guilhermelionzo/tcc_files/latex/editaveis/abreviaturas.tex

\begin{siglas} 		
\item[ADC	] Analog to Digital Converter
\item[AMBA	] Advanced Microcontroller Bus Architecture
\item[AODCS	] Attitude and Orbit Determination and Control System
\item[APIs	] Application Programming Interface
\item[ASCII	] American Standard Code for Information Interchange
\item[CAF	] Camada de Aplicação Final
\item[CAN	] Controller Area Network
\item[CBD	] Component-based Development
\item[CMOS	] Complementary Metal Oxide Semiconductor
\item[COTS	] Commercial off-the-shelf
\item[CSS	] Camada de Serviço do Sistema
\item[DD	] Displacement Damage
\item[ELDRS	] Enhanced Low Dose Rate Sensitivity
\item[EPS	] Electrical Power System
\item[FIFO	] First in, first out
\item[FRAM	] Ferroelectric Random-Access Memory
\item[GPIO	] General Purpose Input/Output
\item[GPL	] General Public License
\item[HAL	] Hardware Abstraction Layer
\item[I2C	] Inter-Integrated Circuit
\item[IMU	] Inertial Measurement Unit
\item[ISS	] International Space Station
\item[JTAG	] Joint Test Action Group
\item[LBA	] Layered-based Architecture
\item[LEO	] Low Earth Orbit
\item[OBC	] On Board Computer
\item[P-POD	] Poly-PicoSatellite Orbital Deploye
\item[PCB	] Printed Circuit Board
\item[PPT	] Pulsed Plasma Thruster 
\item[PWM	] Pulse Width Modulation
\item[RISC	] Reduced Instruction Set Computer
\item[RTC	] Real Time Clock
\item[RTOS	] Real Time Operating Systems
\item[SDW	] SPI Digital Waveform
\item[SEB	] Single Event Burnout
\item[SEE	] Single Event Effect
\item[SEGR	] Single Event Gate Rupture
\item[SEL	] Single Event Latchup	 
\item[SOA	] Service Oriented Architecture
\item[SoC	] System-on-a-chip
\item[SPI	] Serial Peripheral Interface 
\item[SS	] Structural System
\item[SSTP	] Small Space Technology Program
\item[TID	] Total de Dose Ionizante
\item[TT\&C	] Telemetry Telecomand Control
\item[UART	] Universal Asynchrounous Receiver/Transmiter
\item[UML	] Unified Modeling Language
\item[UnB	] Universidade de Brasília
\item[WTD	] Watchdog
\end{siglas}
