guilhermelionzo/tcc_files/latex/editaveis/agradecimentos.tex

\begin{comment}

\end{comment}

\begin{agradecimentos}

Agradeço à equipe da Percepio, que forneceram uma licença para a utilização do Tracealyzer. Agradeço aos professores Leonardo Aguayo e Giancarlo Santilli por acreditarem e incentivarem meu projeto de graduação. E por fim, agradeço minha irmã, Juliana Lionço, por reler inúmeras versões dessa monografia.
	
\end{agradecimentos}
