guilhermelionzo/tcc_files/documents/Referencial Bibliografico.docx

1. Referencial Bibliográfico

Esta seção visa oferecer uma introdução aos conceitos básicos para o entendimento da pesquisa.

Um ponto de ressalto é que este trabalho aborda aspectos de espaçonaves que orbitam a Terra, sendo assim essas espaçonaves são satélites. Onde se ler satélite entende-se espaçonave, vice-versa.

  1.1. Pequenos Satélites

O termo “pequenos satélites” é designado para caracterizar satélites que possuem massa úmida (massa do satélite mais massa do propelente) inferior a 500 kg. Esta definição cumpre a terminologia estabelecida pelo Small Space Tecnology Program (SSTP) da NASA (SHIMMIN, 2015). As subcategorias de pequenos satélites, e alguns exemplos de espaçonaves já lançadas, podem ser observadas na figura abaixo.

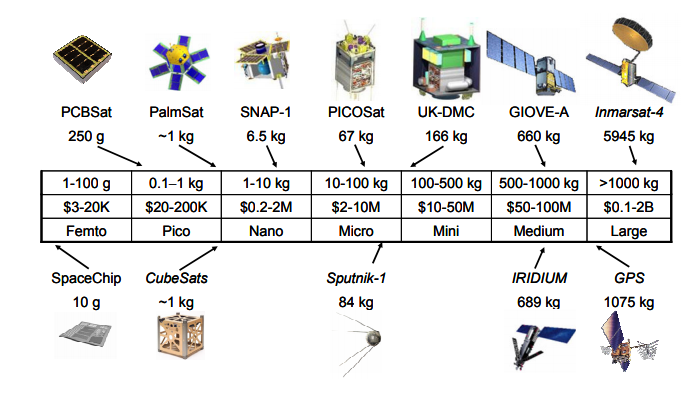
[picture p17: figure]

Figura X.: Categoria de Pequenos Satélites e alguns exemplos (BARNHART, 2008).

No limite superior da categoria de pequenos satélites, existem minissatélites como o Globalstar, satélite de telecomunicações da empresa Globalstar LP, que possui massa úmida de 450 kg (GLOBALSTAR, L.P, 2000). Já no extremo inferior, existem projetos como o KickSat que colocou em orbita 128 femtosatelites com 5g (GRIFFITHS, 2017). As espaçonaves são normalmente agrupadas conforme sua massa, onde pequenos satélites incluem minissatélites com massa entre 100-500kg, microssatélites com massa entre 10-100kg, nanosatélites com massa entre 1-10kg, picosatélites com massa entre 0.1-1kg e femtosatelites com massa entre 1-100g.

Dentre estas subcategorias uma se tornou muito popular na última década, a dos nanosatélites. Esse crescimento pode ser observado na figura X, que mostra a quantidade de pequenos satélites colocados em orbita, entre os anos de 1995 e 2014. Tal aumento foi provocado devido ao surgimento do padrão Cubesat, plataforma cubica de 10 × 10 × 10 cm que possui alguns quilogramas. No ano de 2014, mais de 123 nanosatélites foram lançados, sendo 68% CubeSats (WEKERLE; FILHO, 2017).

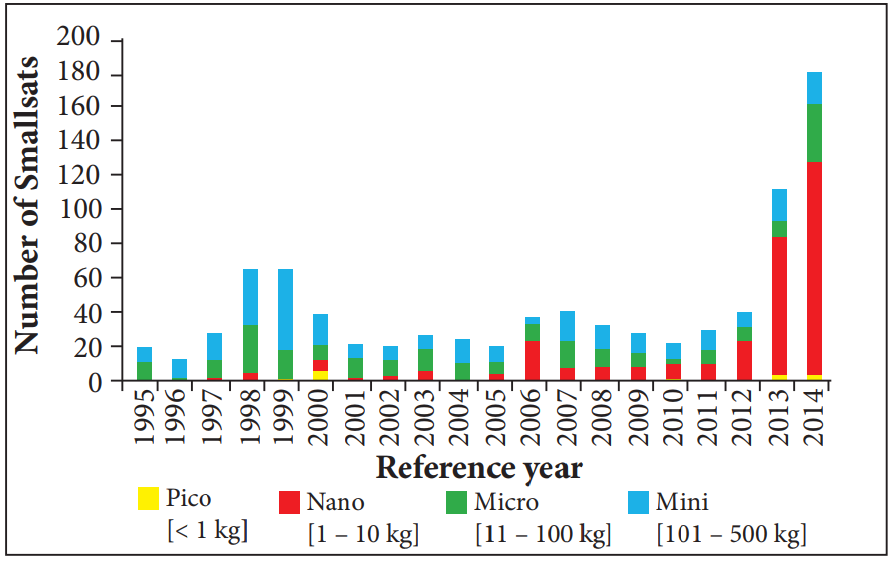
[picture p18: figure]

Figura X.: Lançamento de pequenos satélites por entre 1995 e 2014 (WEKERLE; FILHO, 2017).

Como a figura X mostra, no ano de 2014 que mais de 100 nanosatélites foram lançados, e mais de 68% eram Cubesats (WEKERLE; FILHO, 2017). Os nanosatélites Na última década um padrão de nanossatélites se tornou muito comum no meio acadêmico. Esse padrão, chamado CubeSat, possui a forma de um cubo de 10 × 10 × 10 cm que pesa apenas alguns quilogramas. Os CubeSats podem ser compostos por um único cubo (uma unidade ou 1U) ou vários cubos combinados formando, por exemplo, unidades 3U ou 6U. A figura abaixo mostra as configurações mais usuais para uma CubeSat (SHIMMIN, 2015).

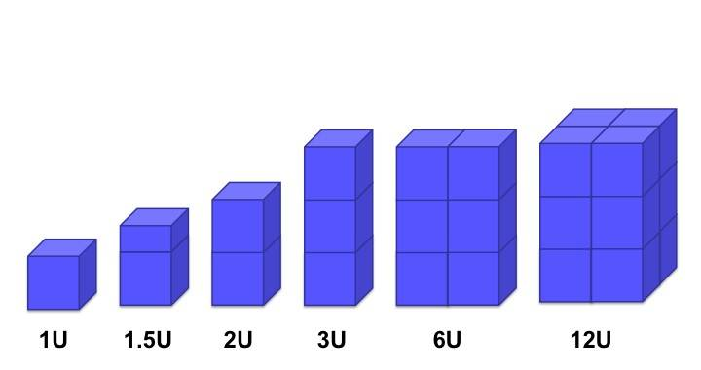
[picture p19: figure]
Image result for cubesats forms

Figura X.: Algumas variações de CubeSat (MABROUK, 2017).

  1.2. Padrão CubeSat

O padrão CubeSat começou como um esforço colaborativo entre Jordi Puig-Suari, professor na Universidade Politécnica da Califórnia (CalPoly), e Bob Twiggs, professor na Universidade de Stanford. A intenção original era fornecer para a comunidade científica universitária meios mais acessíveis ao espaço (DEEPAK; TWIGGS, 2012).

Twiggs retrata o contexto histórico do desenvolvimento do conceito CubeSat em detalhes no seu artigo “Origin of CubeSat” (TWIGGS, 2008). Em resumo, o abandono radical do design tradicional de satélites, ocasionado pelo CubeSat, começou após o lançamento bem-sucedido do Orbiting Picosatellite Automatic Launcher (OPAL), projeto liderado por Twiggs, que pôs em orbita seis hockey picosatélites. Inspirado por este sucesso, Twiggs explorou um design maior e mais cúbico para suportar mais capacidade. De acordo com Twiggs, ele encontrou o modelo perfeito para seu novo design em uma loja varejo, uma embalagem cubica de 10 cm para ursinhos de pelúcia. O nanosatélites resultante, foi um cubo medindo 10 cm de aresta e pesando apenas 1 kg, nomeado CubeSat (DEEPAK; TWIGGS, 2012).

Mais tarde naquele ano, Twiggs e Puig-Suari disponibilizaram as especificações para o CubeSat. Em 2003, Puig-Suari e CalPoly desenvolveram o Poly-PicoSatellite Orbital Deployer, ou P-POD, para lançar até três CubeSats 1U. As primeiras missões CubeSat começaram no mesmo ano do desenvolvimento do P-POD (DEEPAK; TWIGGS, 2012).

Com o passar dos anos, o documento CubeSat Standard sofreu algumas alterações. A versão mais atualizada pode ser encontrada em alguns sites, como o Cubesat.org. A imagem X mostra as dimensões padronizadas de um CubeSat 3U+ (CUBESAT PROGRAM, 2014). Um ponto a ser mencionado é que o 3U+ foi criado para atender as demandas de sensoriamento remoto, possibilitando colocar uma câmera sem prejudicar o espaço interno da plataforma.

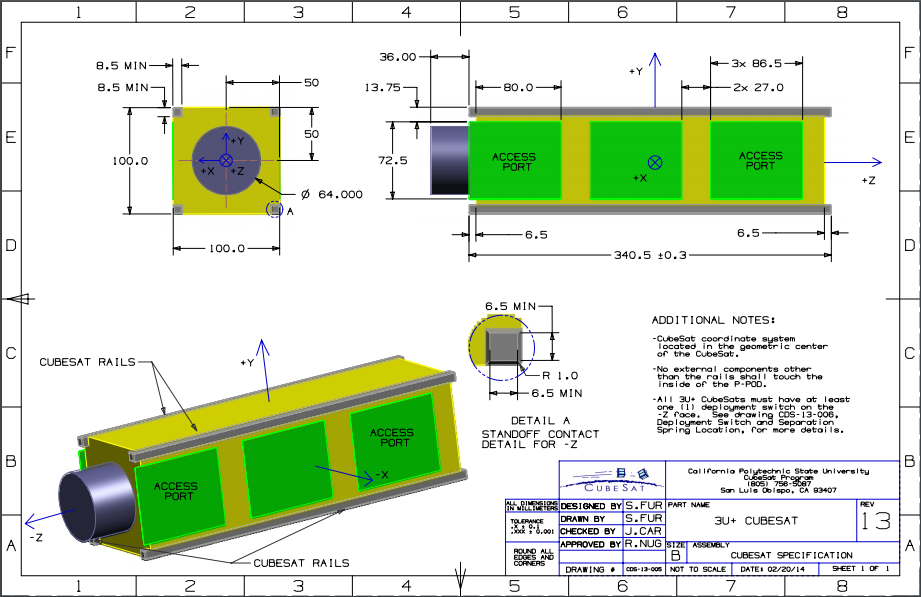
[picture p20: figure]

Figura X.: Especificações Estruturais para um CubeSat 3U+ (CUBESAT PROGRAM, 2014).

Graças aos CubeSats, muitas universidades agora possuem um programa espacial. Porém o uso dessa tecnologia não é exclusiva apenas para grandes universidades; escolas secundarias, ensino médio e escolas primarias puderam iniciar seus próprios programas CubeSat (DEEPAK; TWIGGS, 2012). Um exemplo de projetos como esse é o UbatubaSat, que é um CubeSat feito pelos estudantes da escola municipal Tancredo de Almeida Neves, em Ubatuba-SP (FIORAVANTI, 2011).

Essa facilidade de acesso ao espaço é em consequência de algumas características que o padrão CubeSat dispõem. Os aspectos mais relevantes da plataforma podem ser sintetizados em sete atributos (ISIS, 2018):

- Modularidade: Por possuir um tamanho normalizado, tornou-se possível desenvolver módulos funcionais padronizados, como subsistemas de energia, comunicação, etc. Isso fez com que soluções de prateleira (COTS) fossem amplamente utilizados no projeto de algumas missões, fazendo com que a implementação se tornasse rápida e barata;
- Lançamento: Os CubeSats são tipicamente lançados no espaço como cargas contidas em contêineres padronizados, por exemplo o P-POD, como um meio de reduzir a complexidade e custos de um lançamento;
- Custo: Geralmente as missões CubeSat são desenvolvidas usando um orçamento baixo;
- Componentes: Componentes que não possuem o selo “Space Qualified” são frequentemente utilizados e aceitos em missões CubeSat, permitindo uma abordagem de baixo custo e de rápida implementação. O fato de muitas missões CubeSat estarem em orbita baixa e possuírem um tempo de vida curto faz com que o uso desses componentes se torne viável;
- Desenvolvimento: Devido à baixa complexidade, escopo limitado e capacidade dos CubeSats, é comum usar metodologias de projeto menos formais. Em algumas circunstâncias, é possível trabalhar em equipes compactas, eliminando a necessidade de pacotes de documentação e outras despesas gerais. Obviamente, um certo nível mínimo de formalidade e documentação é sempre necessário;
- Risco: Tipicamente, a abordagem utilizada em missões CubeSats correm um risco técnico mais elevado oferecendo em troca: custo menor, implementação mais rápida, aplicação mais inovadora, ou um conjunto desses elementos;
- Nichos de Aplicação: Os benefícios do padrão CubeSats não são ter boas performances em termos de largura de banda ou resolução espacial, pois não é compatível com as restrições estruturais impostas pelo padrão. Entretanto, quando usado em redes ou constelações, os CubeSats são capazes de fornecer uma resolução temporal a preços acessíveis.
  1.3. Arquitetura e Subsistemas de um CubeSat

O satélite é formado por duas partes principais, que são: a carga útil e a plataforma. A carga útil (câmera, transceptor) é definida pela missão do satélite (observação da terra, telecomunicações…). Essa carga útil não pode funcionar corretamente no ambiente espacial sem plataforma. A plataforma é composta de vários subsistemas; cada um tem seu próprio papel. A carga deve estar inserido em um subsistema estrutural para proteger o satélite dos efeitos do ambiente espacial após sua colocação em órbita e servir como interface com o veículo lançador. Os equipamentos eletrônicos a bordo do satélite precisam ser energizados pela energia elétrica, com isso, o satélite precisa de um subsistema de energia que seja responsável pela geração, armazenamento e distribuição da energia elétrica. A temperatura no ambiente espacial pode variar entre - 170 °C (em eclipse) e + 100° C (em pleno sol). Assim, o satélite precisa de um subsistema de controle térmico que garanta que a temperatura de cada equipamento a bordo permaneça dentro do intervalo correto de temperaturas de operação. Os componentes de carga, como a antena e a câmera, devem ser apontados em uma área geográfica precisa. O satélite precisará então de um subsistema de controle de atitude que será responsável por controlar a orientação do satélite no espaço (sua atitude). (ADDAIM; KHERRAS ; ZANTOU, 2010)

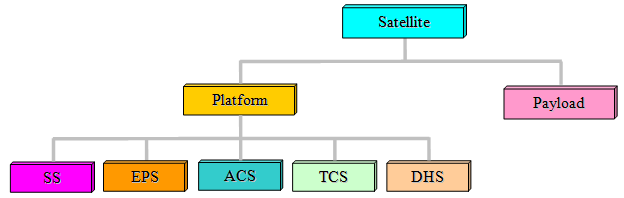
[picture p21: figure]

Figura X. Arquitetura de um Satélite (ADDAIM; KHERRAS ; ZANTOU, 2010).

  1.4. Ferramenta de Avaliação de Tecnologia

O Techonology Readiness Levels (TRLs) é uma ferramenta métrica que ajuda na avalição da maturidade de tecnologias, consistindo na atribuição da maturidade (escala de 1 até 9) de acordo com seu estágio evolucional tecnológico (Mankins, 1995). A figura X mostra a escala TRL.

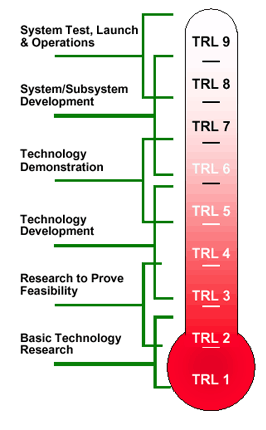
[picture p22: figure]
Image result for trl nasa

Figura X. Escala do TRL (https://en.wikipedia.org/wiki/Technology_readiness_level).

Uma tecnologia é considerada estado da arte quando seu TRL é maior ou igual a 6. Um TRL acima de 6 indica que o produto, ou protótipo, está próximo da configuração desejada em termos de desempenho, peso e volume, e foi testado e demonstrado em um ambiente relevante. Um ambiente relevante é um ambiente de laboratório de alta fidelidade ou um sistema operacional ambiente. Uma tecnologia é considerada não-técnica sempre que o seu TRL for inferior ou igual a 5. Nesta categoria, a tecnologia é considerada “no horizonte” (SHIMMIN, 2015).

O uso de TRL será importante na hora de decidir em quais missões se basear, para escolher os componentes e dispositivos. Essa ferramenta deixará explicito os possíveis riscos em se basear em missões que ainda possuem um TRL baixo.

  1.5. Computador de Bordo

O Computador de Bordo é considerado o cérebro do CubeSat e consiste essencialmente de um microcontrolador conectado à outros subsistemas por uma por barramentos de dados e periféricos adicionais. Um sistema operacional de tempo real (RTOS) controla todas as aplicações que rodam no microcotrolador e constitui o software de voo do CubeSat (FSW) (Development of an onboard computer (OBC) for a CubeSat).

As funções mais importantes de um Computador de bordo são exemplificadas abaixo (Well et al., 2003):

- Capturar e armazenar dados da telemetria e Payload para a tramsmissão para a estação de solo;
- Codificar e decodificar pacotes de dados para a estação de solo;
- Processar os telecomandos da estação de solo, incluindo o tempo atraso entre dos telecomandos enviados pelo canal de uplink;
- Monitorar os subsistemas, implementando funções de watchdog e re-iniciando subsistemas críticos quando necessário.

This is also accomplished by the OBC which decodes these telecommands and executes them by in turn commanding the other subsystems to achieve the desired action (Polaschegg, 2005).

O computador de bordo também pode fazer a leitura dos sensores do ADCS para determinar a leitu

The OBC also makes use of the data from ADCS sensors to determine the attitude of
the orbiting satellite and controls the ADCS actuators to control the satellite’s attitude.
This is done by loading a pre-defined control algorithm into the microcontroller and
executing manoeuvres whenever necessary (Hales et al., 2001).
As illustrated in Figure 2.3, the OBC is composed of both hardware and software
components. Such a global visualisation is very useful to associate all the OBC elements
with their respective functions and build the OBC architecture based on these elements
(Noergaard, 2005). These two components are presented in more details:

n its very basic form, a CubeSat’s architecture is similar to what is presented in Figure
2.2. The OBC is at the centre of all communications between other subsystems via a
serial bus interface. The OBC generally includes the memory subsystem because it has
the additional function to record housekeeping parameters and telemetry payload data
collected at given timestamps or coordinates, before initiating the transmission to the
ground station during an overpass (Hardy, 2009).
Each subsystem is assigned a dedicated task. A brief description of each subsystem is
given in the points that follow.

Os subsistemas de um satélite são encarregados de transmitir e armazenar informações ou comandos entre eles. O computar de bordo se assemelha ao coração dessa troca de dados e funciona com a comunicação a bordo entre todos os subsistemas. As especificações do computador de bordo precisam ser determinadas e otimizada para assegurar o seu funcionamento e eficiência de troca de dados, desde que varias taxas estão sendo utilizadas entre os subsistemas. (Hidayat, 2010). (TUSat1—The Innovative Creation of a Low-Cost CubeSat)

Parametros do computador de bordo, como temperatura e potencia consumida, em diferentes pontos do satelite, são constantemente medidos e armazenados na memoria do computador de bordo e constituem os dados de telemetria para sem baixados pela estação de solo durante a passada. A estação de solo pode enviar novas versões do firmware de voo, pelo canal uplink, e novos parâmetros orbitais podem ser definidos e implementados. Isso é pego asdasdasd

    1.5.1. Computadores de Bordo existentes

Nesta seção serão avaliadas algumas missões e seus Computadores de Bordo. Levou-se em consideração a maturidade tecnologia, mencionada na seção X.

- FloripaSat OBDH

O projeto FloripaSat, da Universidade Federal de Santa Catarina (UFSC), possui um computador de bordo que é responsável pela sincronização de ações e fluxo de dados entre os subsistemas (Payload e EPS) e com a Segmento Terrestre. Esse subsistema é composto por seis sub-modulos: CPU (MCU: CPU + RAM + Program Flash), memoria não volátil, Drivers de controle, unidade de medição inercial (IMU), Sensores de Corrente (sensor de Sol) e interfaces de comunicação (FLORIPASAT,2016).

O sistema responsável pela execução do firmware consiste de SoC que contém uma CPU, Memória RAM e Flash (usado para armazenamento de programas e status dos registradores). O Microcontrolador escolhido foi o MSP430F6659IPZ da Texas Instruments. Tal microcontrolador, conhecido por ter um baixo consumo, possui sete modos de operação de consumo, 4 timers de 16-bits, 12 AD/DA de 12-bits, 6 interfaces de comunicação serial, bloco de real-time clock (RTC) e mais de 74 pinos de I/O. O clock de operação do OBDH é de 32MHz (FLORIPASAT,2016).

Provendo um sistema de redundância, há um monitor de tensão com um Watchdog Timer (FLORIPASAT,2016). A figura abaixo mostra a arquitetura do OBDH do FloripaSat.

Obdh Topology

Figura X: Arquitetura do OBDH do FloripaSat. Fonte: (FLORIPASAT,2016)

- Open OBC

Esse é um computador open source para CubeSat, desenvolvido pela Universidade Federal do Ceara (UFC) com o do Instituto Nacional de Pesquisas Espaciais (INPE), tendo como pontos fortes o baixo custo e a ata confiabilidade. A arquitetura utilizada no Open OBC contém: processador TMS570LS0432 da fabricante Texas Instruments

A arquitetura proposta utiliza o processador TMS570LS0432 do fabricante Texas Instruments, o qual possui: núcleo ARM Cortex-R4 em duas CPUs; detecção e correção de falhas em suas memórias RAM e ROM internas; hardware BIST (Auto-teste interno de fábrica) tanto na CPU quanto na memória RAM; e outras características de segurança como o monitoramento do clock e da tensão de alimentação. Uma memória Flash externa foi utilizada para armazenamento de código e dados. Foram disponibilizadas duas interfaces I2C para a comunicação com os subsistemas existentes em um CubeSat, sendo uma exclusiva para comunicação com o Transponder e outra comum para os demais. A arquitetura é complementada por uma interface UART para diagnóstico e depuração, sinais PWM para acionamento das bobinas de torque e entradas ADC para medição da intensidade da luz solar nas faces do satélite. Estão previstos ainda um cartão MicroSD para armazenamentos de dados e uma interface CAN para tráfego de informações transmitidas em tempo real, garantindo assim um controle rígido de erros e a recepção de mensagens (OPENOBC, 2017)


Figura X: Arquitetura do OpenOBC. Fonte: (OPENOBC, 2017)

- ISIS On Board Computer (iOBC)

O iOBC, do fabricante ISIS (Innovative Solution In Space), é um computador de bordo com alto desempenho baseado em um processador ARM9 com velocidade de clock de 400MHz e oferece uma infinidade de interfaces padronizadas. Tem a capacidade de modularidade, permitindo a adição de eletrônicos ou interfaces especificas da missão, tornando o iOBC um ótimo computador de bordo para inúmeras missões (ISIS, 2016).

A arquitetura utiliza o processador AT91SAM9G20 do fabricante Microchip, o qual possui: núcleo ARM9 32-bit com 400MHz; detecção e correção de falhas em suas memórias RAM e ROM internas; hardware BIST (Auto-teste interno de fábrica) tanto na CPU quanto na memória RAM; e outras características de segurança como o monitoramento do clock e da tensão de alimentação. Uma memória Flash externa foi utilizada para armazenamento de código e dados. Foram disponibilizadas duas interfaces I2C para a comunicação com os subsistemas existentes em um CubeSat, sendo uma exclusiva para comunicação com o Transponder e outra comum para os demais. A arquitetura é complementada por uma interface UART para diagnóstico e depuração, sinais PWM para acionamento das bobinas de torque e entradas ADC para medição da intensidade da luz solar nas faces do satélite. Estão previstos ainda um cartão MicroSD para armazenamentos de dados e uma interface CAN para tráfego de informações transmitidas em tempo real, garantindo assim um controle rígido de erros e a recepção de mensagens (OPENOBC, 2017)

- FM430 Flight Module

O FM430, da fabricante Pumpkin Inc, é uma solução compacta para sistemas ambientais difíceis. Possui como microcontrolador o MSP430F1612 de 16-bit, da fabricante Texas Instruments, com velocidade de clock de 7.3728 MHz. 50-60kB ROM e 2-10kB de RAM, 48 pinos I/O, 2 USART, 2 SPI, 1 I2C, 12-bit A/D D/A, sensor de temperatura. SD Card para armazenamento (32MB – 2GB). Uma porta USB (Universal Serial Bus) e um conector de fonte de alimentação externa para facilitar a configuração pré-lançamento. A unidade do microcontrolador consome mais de 100 mW de potência (PUMPKIN,2008).


Figura X: Arquitetura do FM430. Fonte: (PUMPKIN, 2008)

Tabela Comparativa

| Projetos
Recursos | FloripaSat OBDH | Open OBC | iOBC | FM430 Flight Mode
Processador | MSP430F6659IPZ | TMS570LS0432 | AT91SAM9G20 | MSP430F1612
Fabricante | Texas Instruments | Texas Instruments | Micro Chip | Texas Instruments
Clock | 8 MHz | 80 MHz | 400 MHz | 7.3728 MHz
Watchdog Timer | Sim | Sim | Sim | Sim
Memória Flash | 512 KB | 16 KB | X | 55 KB
Memória RAM | 66 KB | 32 KB | 32 KB | 5 KB
EEPROM | X | 16 KB | X | X
I2C | 3 | 0 | 2 | 1
Canais ADC | 16 canais de 12bit | 6 canais de 12bit | 6 canais de 10bit | 8 canais de 12bit
CAN | X | X | X | X
SPI | 3 | 2 | 2 | 2
PWM | 5 canais | 0 | 6 | 1
UART | 3 | 1 | 7 | 2

  1.6. PADRÃO PC/104

O PC/104 é o padrão de placas eletrônicas mais utilizado na indústria e em missões CubeSat. O PC/104 Embedded Consortium (2008) definiu as restrições mecânicas e elétricas para uma placa padrão de circuito impresso. As principais restrições podem ser encontradas a seguir: mostrado na Figura X,

- Cada placa deve ter uma forma de 90x96mm;
- A potência por modulo deve estar entre 1-2W, reduzindo a corrente do barramento para 4mA.
- Os módulos devem ser de 8-bits ou 18-bits, correspondendo ao barramento PC e PC/AT, respectivamente;
- O espaçamento entre as placas não deve exceder 15,24mm;
- Os conectores do barramento podem ser do tipo “empilhado” ou “não-empilhado” dependendo do projeto;
- A altura dos componentes não deve exceder 11,05mm;
- A uso do barramento deve estar de acordo com a tabela 2, Apêndice B, PC/104 Standard.

A tecnologia PC/104 é vantajosa para missões CubeSat devido a padronização de dimensões, barramentos, interfaces mecânicas e elétricas. Esses fatores acarretam na redução de custos, riscos e tempo envolvidos no projeto, sem contar na versatilidade de integrar outras soluções presentes no mercado, que utilizam o mesmo padrão (JANES,2006). A Figura X mostra as dimensões mecanicas para uma placa PC/104 de 8-bits.

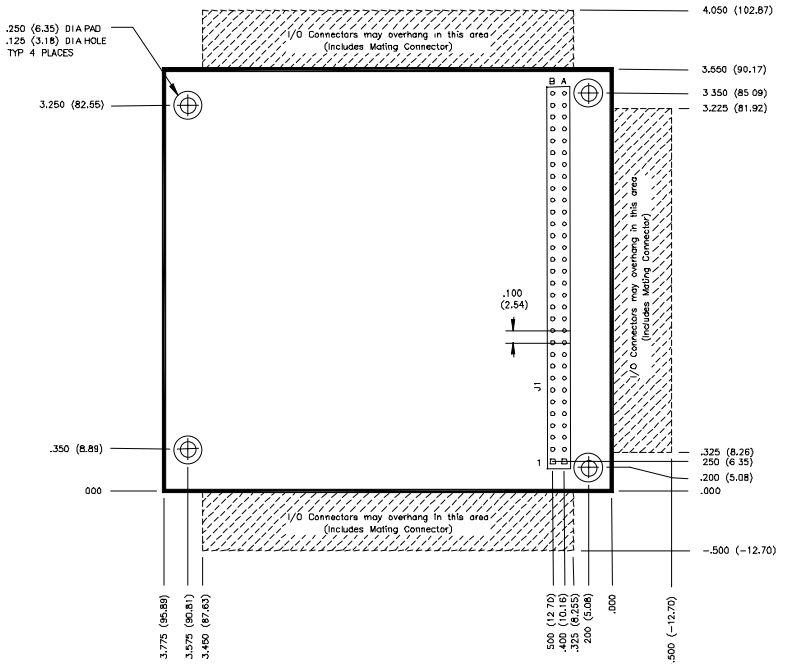
[picture p23: figure]

Figura X. PCB Padrão PC104 8-bits (PC/104 Embedded Consortium, 2008).

  1.7. AMBIENTE ESPACIAL

Um problema que se torna importante no design de um satélite, são os efeitos do ambiente espacial sobre os dispositivos eletrônicos. Esses problemas podem variar entre mal funcionamento operacional até danos físicos. Geralmente essas considerações são feitas para missões LEO e Deep Space de longa duração (SHIMMIN, 2015).

De acordo com Finckenor e Groh (2015), vários testes foram realizados na ISS para estudar a degradação dos materiais no ambiente espacial. Esses testes servirão para comparar com os dados obtidos em laboratórios, o que tornou mais preciso as bateriais de testes pre lançamento. Os efeitos que degradam os materiais são:

- Vácuo;
- Radiação Ultravioleta;
- Partículas Inionizadas (Plasma);
- Temperaturas Extremas;
- Fadiga termica;
- Impacto de Lixo Espacial;

CMOS technology is preferred for space applications because of its high noise margins and low static power requirements. Scaling and integration are other advances CMOS technology has over other semiconductor technologies. On the other hand, CMOS is susceptive to two types of space radiation effects caused by electrons and protons trapped by the terrestrial magnetic field: Total Ionizing Dose (TID) and Single Event Effects (SEE). TID effects are the result of accumulated exposure to ionizing radiation. SEE are the result of a single high-energy particle that strikes the device.

The total dose radiation exposure is measured in rads. The term rad (radiation absorbed dose) quantifies the total radiation exposure of a material. One rad(Si) is equal to 10 x 10-6 W of energy absorbed per gram of silicon. The total dose radiation threshold of a device is the minimum level of rad(Si) that will cause device failure. Typical CMOS technology devices can survive nearly 5 krads before physical damage occurs (Pisacane & Moore, 1994 (https://www.intechopen.com/books/aerospace-technologies-advancements/design-of-low-cost-telecommunications-cubesat-class-spacecraft)).

However, single-event effects are significantly more hazardous to the satellite and can result in either Single Event Upset (SEU) or Single Event Transient (SET) (Poivey et al., 2003 (https://www.intechopen.com/books/aerospace-technologies-advancements/design-of-low-cost-telecommunications-cubesat-class-spacecraft)) or Single Event Latchup (SEL). SEU effects are internal device memory bit changes (0 becomes 1 and vice versa) that can cause erroneous instruction execution and SET is a transient voltage pulse that can cause erroneous data transmission over a bus. SEU and SET effects are considered soft-errors and do not cause physical damage to the devices. In contrast, SEL effect is a hard-error, which leads to a high current-flow through the device. If not remedied quickly, latch-up can cause permanent damage.

Tema: radiance

https://www.nasa.gov/sites/default/files/atoms/files/small_spacecraft_technology_state_of_the_art_2015_tagged.pdf

As the cubesat class of small spacecraft evolve into deep space and extended duration missions, there will be a need to address the impact of the space radiation environment. It will be necessary to develop radiation tolerant system designs to ensure mission reliability and success. Radiation hardened (rad-hard) hardware is available for a majority of the electronic components used in C&DH systems. However rad-hard devices can be significantly more costly when compared to standard COTS components. Developers will undoubtedly utilize a combination of rad-hard components, COTS devices, shielding and mitigation techniques such as watchdog timers and memory scrubbing to reduce radiation environment impacts and improve system reliability in an effort to keep development costs as low as possible.

2. REFERENCIAS BIBLIOGRAFICAS

SHIMMIN, Rogan. Editor. Small Spacecraft Technology State of the Art. California: NASA Ames Research Center, 2015. 17 p. Disponível em: <https://www.nasa.gov/sites/default/files/atoms/files/small_spacecraft_technology_state_of_the_art_2015_tagged.pdf>. Acesso em: 25 mar. 2018.

DEEPAK, Ravi A.; TWIGGS, Robert J. Thinking Out of the Box: Space Science Beyond the CubeSat. 1. ed. Virginia - US: Journal Of Small Satellites, 2012. 3 e 4 p. v. 1. Disponível em: <http://www.jossonline.com/wp-content/uploads/2014/12/0101-Thinking-Outside-the-Box-Space-Science-Beyond-the-CubeSat.pdf>. Acesso em: 25 mar. 2018.

FIORAVANTI, Carlos . Uma escola em órbita: Professores e estudantes constroem satélite no litoral paulista. São Paulo: FAPESP, 2011. 1 p. Disponível em: <http://revistapesquisa.fapesp.br/wp-content/uploads/2012/05/040-041-180.pdf>. Acesso em: 25 mar. 2018.

MABROUK, Elizabeth . What are SmallSats and CubeSats?. Disponível em: <https://www.nasa.gov/content/what-are-smallsats-and-cubesats>. Acesso em: 25 mar. 2018.

TWIGGS, Robert. Origin of CubeSat. In: HELVAJIAN, HENRY ; JANSON, SIEGFRIED W. . SMALL SATELLITES: PAST, PRESENT, AND FUTURE. 1. ed. El Segundo, CA: He Aerospace Corporation, 2008. p. 151-153. v. 1.

GLOBALSTAR, L.P. EMPRESA. Description of the Globalstar System. California: [s.n.], 2000. 47 p. Disponível em: <https://gsproductsupport.files.wordpress.com/2009/04/description-of-the-globalstar-system-gs-tr-94-0001-rev-e-2000-12-07.pdf>. Acesso em: 31 mar. 2018.

GRIFFITHS, Ian Michael. Location techniques for pico- and femto-satellites, with applications for space weather monitoring. 2017. 142 p. Thesis ( Doctor of Philosophy)- University of Leicester, England, 2017. Disponível em: <https://lra.le.ac.uk/bitstream/2381/39973/1/2017GriffithsIMPhD.pdf>. Acesso em: 31 mar. 2018.

WEKERLE, Timo ; FILHO, José Bezerra Pessoa . Status and Trends of Smallsats and Their Launch Vehicles — An Up-to-date Review. São Paulo: Departamento de Ciência e Tecnologia Aeroespacial - Instituto Tecnológico de Aeronáutica - Divisão de Engenharia Aeronáutica e Mecânica, 2017. 18 p. v. 3. Disponível em: <http://www.scielo.br/pdf/jatm/v9n3/2175-9146-jatm-09-03-0269.pdf>. Acesso em: 31 mar. 2018.

BARNHART, David J. .Very Small Satellite Design for Space Sensor Networks . United Kingdom: Faculty Of Engineering And Physical Sciences - Faculty Of Engineering And Physical Sciences, 2008. 233 p. Disponível em: <http://www.dtic.mil/dtic/tr/fulltext/u2/a486188.pdf>. Acesso em: 31 mar. 2018.

CUBESAT PROGRAM. CubeSat Design Specification Rev. 13. California: California Polytechnic, 2014. 42 p. Disponível em: <https://static1.squarespace.com/static/5418c831e4b0fa4ecac1bacd/t/56e9b62337013b6c063a655a/1458157095454/cds_rev13_final2.pdf>. Acesso em: 31 mar. 2018.

ISIS. Innovative Solutions In Space. 2016. Disponível em: <https://www.isispace.nl/cubesats/>. Acesso em: 31 nov. 2018.

ADDAIM, Adnane ; KHERRAS , Abdelhaq ; ZANTOU, El Bachir. Design of Low-cost Telecommunications CubeSat-class Spacecraft. Centre For Space Research And Studies, EMI, Marocos: [s.n.], 2010. 6 p. Disponível em: <https://www.intechopen.com/books/aerospace-technologies-advancements/design-of-low-cost-telecommunications-cubesat-class-spacecraft/>. Acesso em: 05 abr. 2018.

LUMBWE, LWABANJI TONY. Development of an onboard computer (OBC) for a CubeSat. Bellville: Faculty Of Engineering At The Cape Peninsula University Of Technology, 2013. 178 p. Disponível em: <http://etd.cput.ac.za/bitstream/handle/20.500.11838/1172/Lumbwe_T_Final2013.pdf?sequence=1&isAllowed=y>. Acesso em: 06 abr. 2018.

PC/104 Embedded Consortium. PC/104 Embedded Consortium. 2.6. ed. [S.l.: s.n.], 2008. 25 p. Disponível em: <https://pc104.org/wp-content/uploads/2015/02/PC104_Spec_v2_6.pdf>. Acesso em: 06 abr. 2018.

JANES, Michael . The PC/104 Technology In Embedded System Design. Canada: [s.n.], 2006. 22 p. Disponível em: <http://nparc.nrc-cnrc.gc.ca/eng/view/fulltext/?id=22caabb7-7f63-42b1-96fa-47bcd465d87b>. Acesso em: 08 abr. 2018.

FINCKENOR, Miria M. ; GROH, Kim K. . Space Environmental Effects. Washington: NASA ISS Program Science Office, 2015. 40 p. Disponível em: <https://www.nasa.gov/sites/default/files/files/NP-2015-03-015-JSC_Space_Environment-ISS-Mini-Book-2015-508.pdf>. Acesso em: 08 abr. 2018.
