guilhermelionzo/tcc_files/latex/figuras/flowChart_wdt.pdf

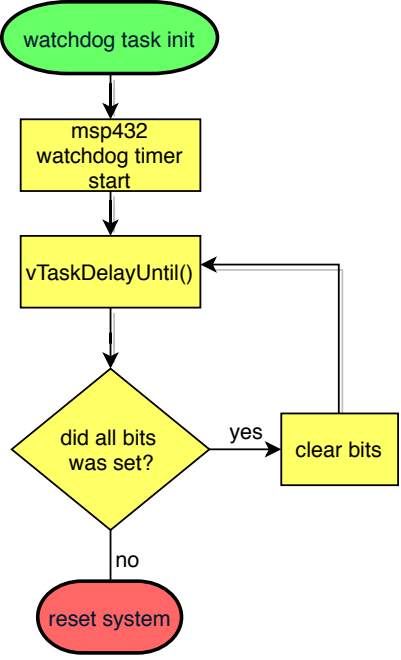
[picture p57: figure]
watchdog task init; vTaskDelayUntil(); clear bits did all bits was set?; yes; reset system; msp432 watchdog timer start
