guilhermelionzo/tcc_files/latex/editaveis/dedicatoria.tex

\begin{dedicatoria}
	\vspace*{\fill}
	\centering
	\noindent

	\textbf{Dedicatória}.
	
	\textit{Dedico este trabalho primeiramente à Deus, que me guiou durante toda minha jornada. Aos meus pais, irmãos e à toda minha família que, com muito carinho e apoio, não mediram esforços para que eu chegasse até esta etapa de minha vida. Aos meus amigos, que tornaram a graduação mais agradável e divertida.} 

	\vspace*{\fill}
\end{dedicatoria}

\begin{comment}

\end{comment}
