guilhermelionzo/tcc_files/latex/editaveis/informacoes.tex

% Dados pessoais
\autor{Guilherme Silva Lionço}
\curso{Engenharia Aeroespacial}

% Dados do trabalho
\titulo{Desenvolvimento de um Computador de Bordo para Pequenos Satélites}
\data{2019}
\palavraChaveUm{Palavra-chave01}
\palavraChaveDois{Palavra-chave02}

% Dados da orientacao
\orientador{Prof. Dr. Leonardo Aguayo}
\coorientador{Prof. Dr. Giancarlo Santilli}

% Dados para a ficha catalográfica
\cdu{02:141:005.6}

% Dados da aprovação do trabalho
\dataDaAprovacao{15 de julho de 2019 -- Data da aprovação do trabalho}
\membroConvidadoUm{Prof. Dr. William Reis Silva}
%\membroConvidadoDois{Prof. Dr. YY}
