guilhermelionzo/tcc_files/latex/editaveis/epigrafe.tex

\begin{epigrafe}
    \vspace*{\fill}
	\begin{flushright}

		\textit{``Nunca guarde o conhecimento.\\ 
        		Guardado enaltece o ego, partilhado enobrece o ser.\\ 
                Guardado morre inerte, partilhado vive ativo.\\ 
                Guardado vale apenas àquilo que é,
                partilhado vale aquilo em que pode se tornar.\\  
                Transmitir o que se sabe é eternizar a existência.``\\
		(Fernando Pinheiro)}
	\end{flushright}
\end{epigrafe}
