guilhermelionzo/tcc_files/documents/Justificativa.docx

- PRIMEIRA VERTENTE (POLONESES)

Justificativa

-Realizar um computador de bordo levando em consideração os requisitos da missão;

Metodologia

- o que eu fiz no TCC1 e o que será feito no TCC2;

- explicar o uso da launchpad para facilitar o desenvolvimento do projeto;

- SEGUNDA VERTENTE (FOMENTO DO CENARIO AEROESPACIAL)

Justificativa

- importância no meio acadêmico e cientifico;

- importância técnica;

- o que já existia na área e revisão bibliográfica;

Metodologia

- o que eu fiz no TCC1 e o que será feito no TCC2;

- explicar o uso da launchpad para facilitar o desenvolvimento do projeto;
