guilhermelionzo/tcc_files/email/1.docx

Boa noite professores,

Gostaria de agradecer mais uma vez pela avaliação e conselhos durante a defesa. Fiquem a vontade para enviar outras sugestões.

Mais uma vez muito obrigado.

Boa noite professor Giancarlo,

O professor Aguayo será o orientador do TCC2? Esqueci de perguntar isso ontem para o senhor.

Fala Netinho, beleza meu vei? Então, você teria como pagar os 30,00 reais esse mês? Valeuuu meu vei. Ah, bora marcar de ficar locão na próxima semana. To quase ficando louco com a facul kkkk
