guilhermelionzo/tcc_files/latex/figuras/capa-eps-converted-to.pdf

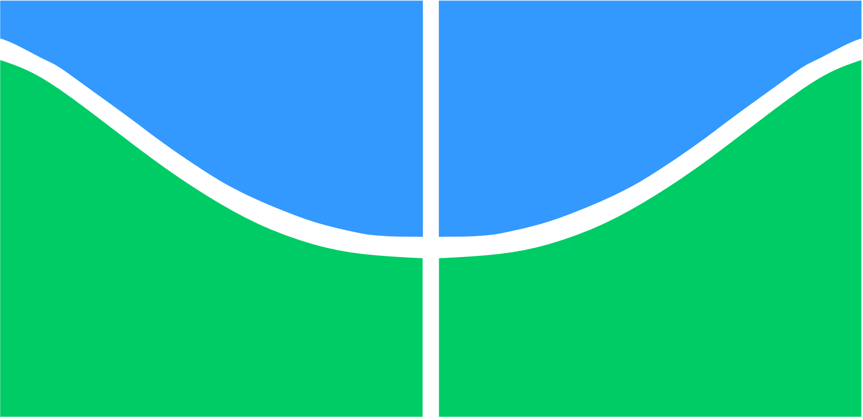
[picture p105: figure]
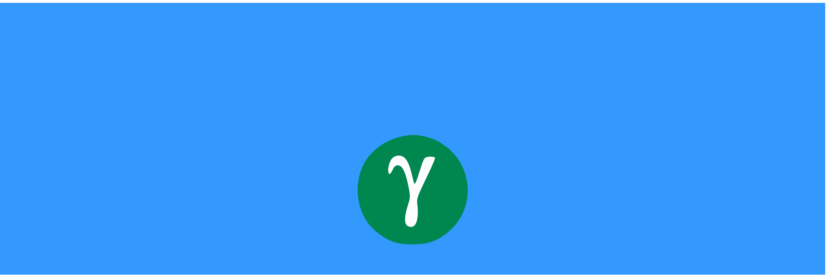
[picture p106: figure]
