guilhermelionzo/tcc_files/imagens/alimentacao_esquema.PNG

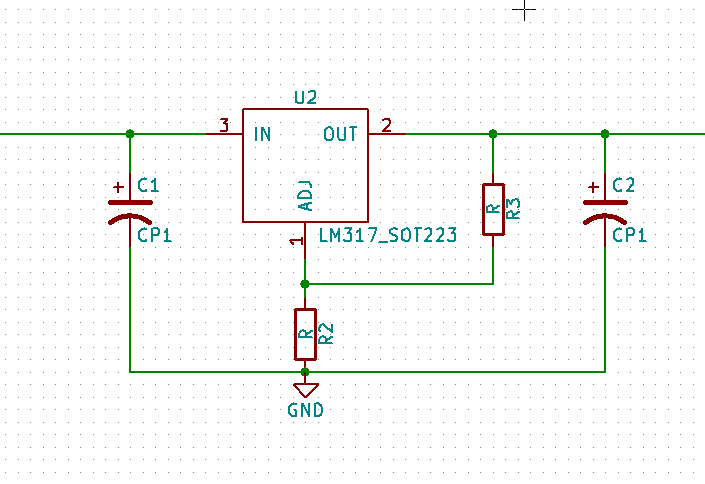
imagens/alimentacao_esquema.PNG
