guilhermelionzo/tcc_files/imagens/aodcs.jpg

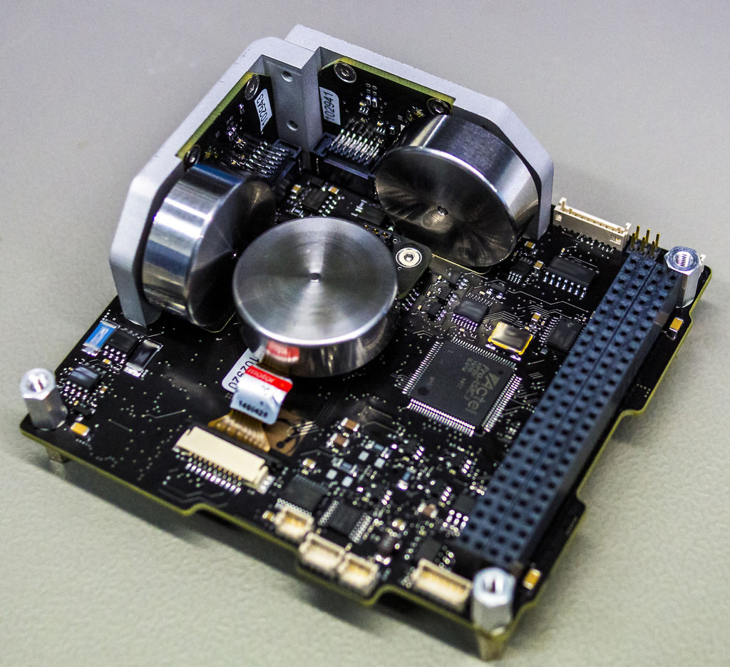
imagens/aodcs.jpg
