guilhermelionzo/tcc_files/imagens/cronograma.PNG

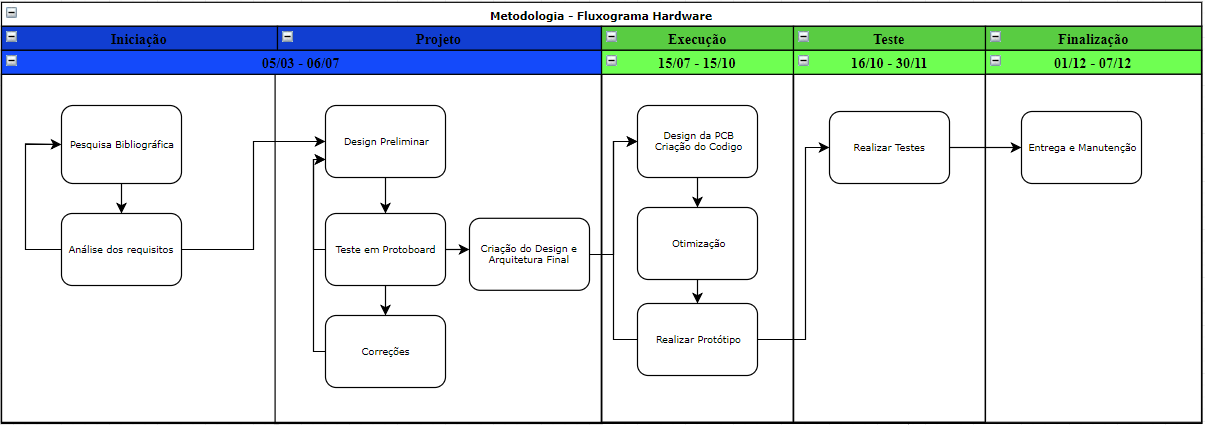
imagens/cronograma.PNG
