guilhermelionzo/tcc_files/imagens/Cubesat-OBC-module-1.png

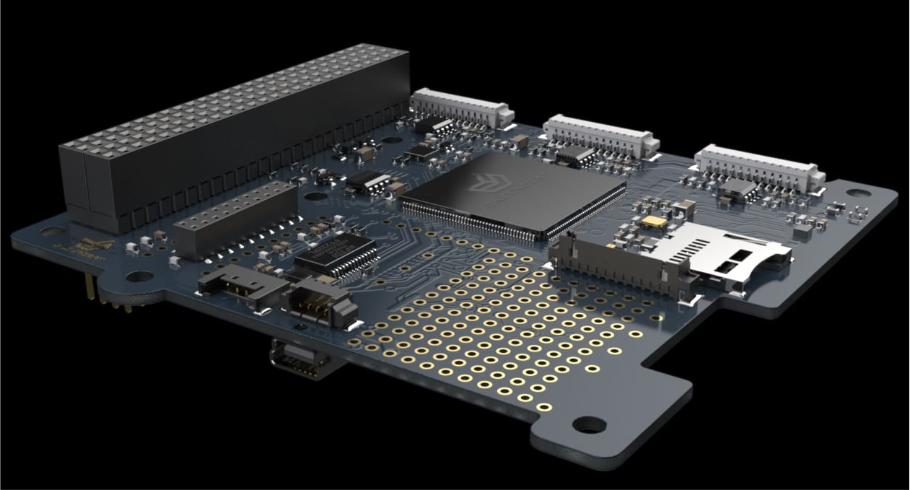
imagens/Cubesat-OBC-module-1.png
