guilhermelionzo/tcc_files/imagens/eventLog_wtd.png

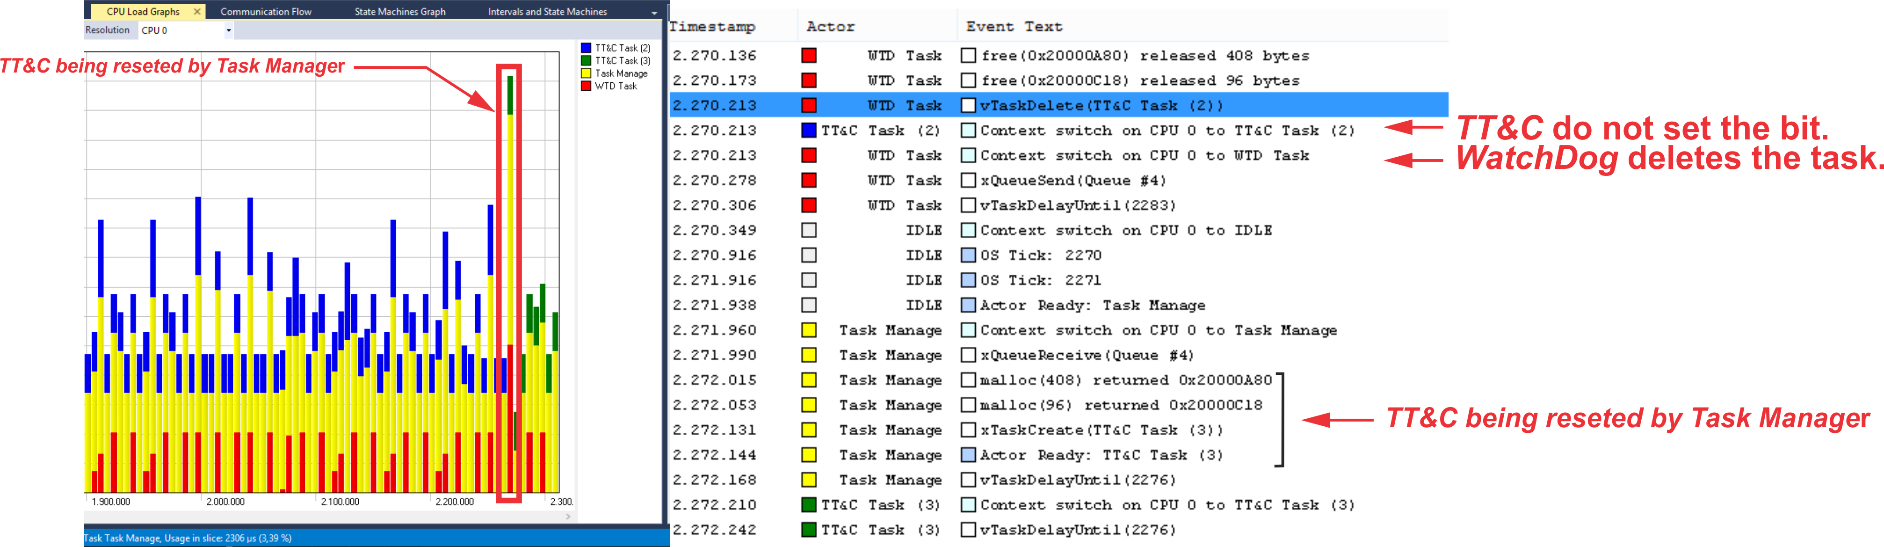
imagens/eventLog_wtd.png
