guilhermelionzo/tcc_files/imagens/Modos de Operação do S.E..png

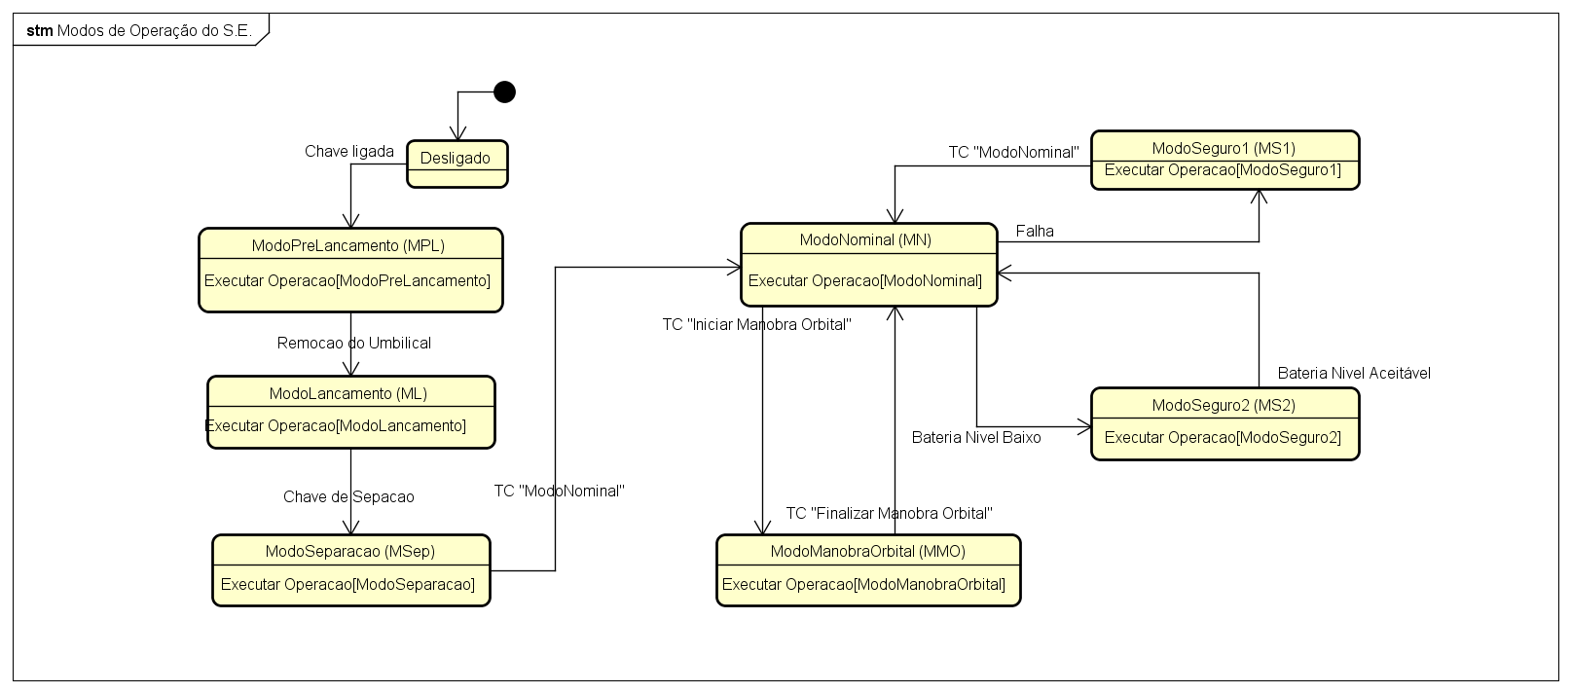
imagens/Modos de Operação do S.E..png
