guilhermelionzo/tcc_files/imagens/msp432_esquematico.PNG

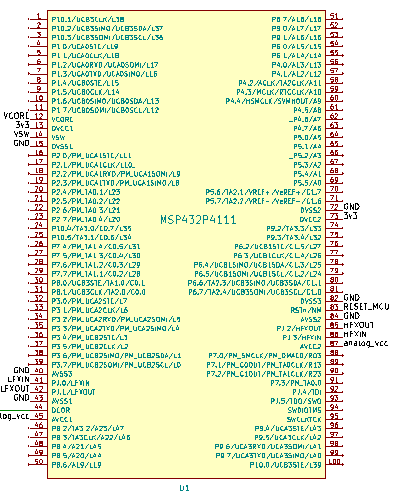
imagens/msp432_esquematico.PNG
