guilhermelionzo/tcc_files/imagens/ppt.jpg

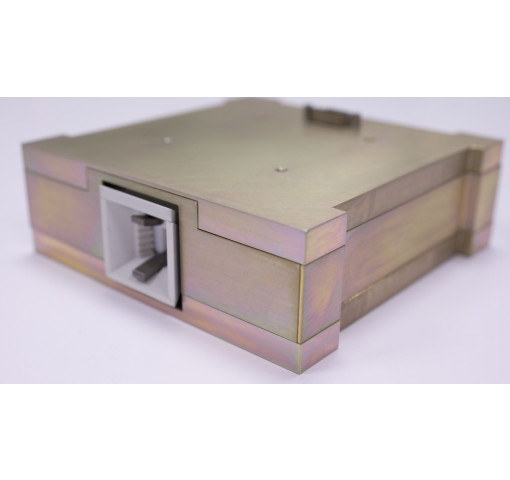
imagens/ppt.jpg
