guilhermelionzo/tcc_files/imagens/protoboard/IMG_8201.JPG

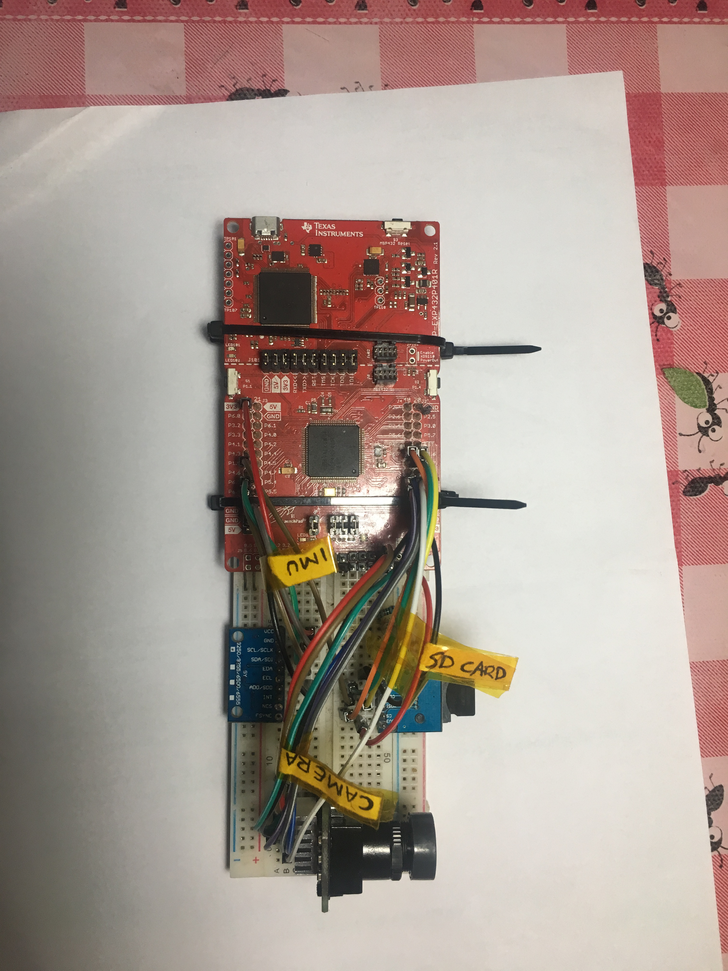
imagens/protoboard/IMG_8201.JPG
