guilhermelionzo/tcc_files/imagens/protoboard/IMG_8202.JPG

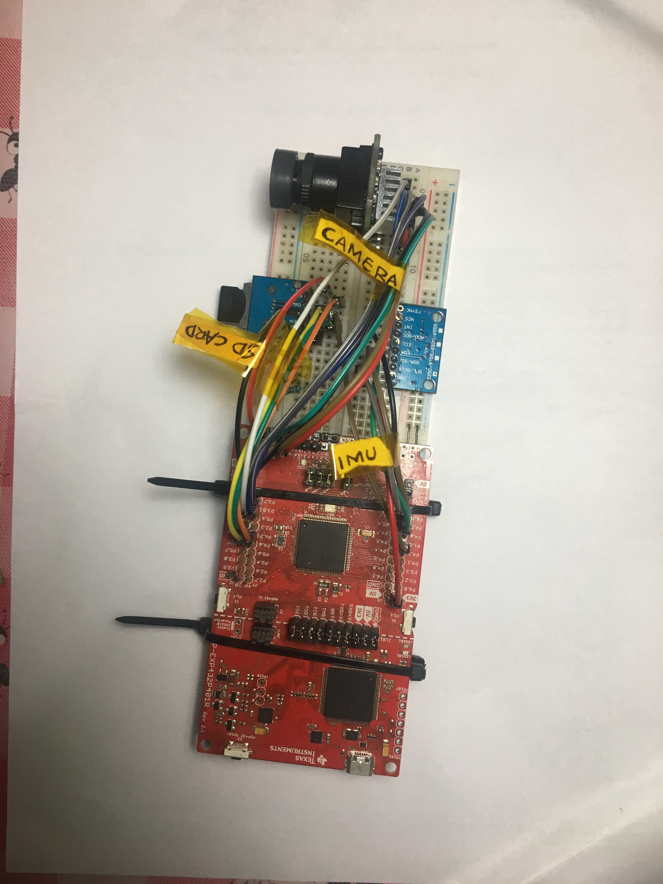
imagens/protoboard/IMG_8202.JPG
