guilhermelionzo/tcc_files/imagens/protoboard/IMG_8203.JPG

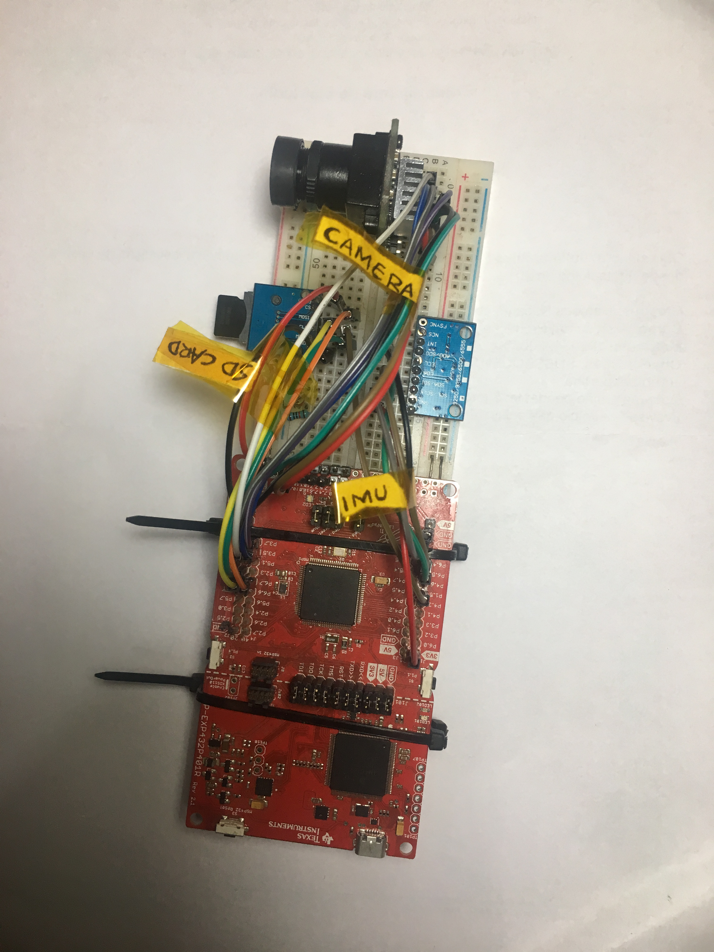
imagens/protoboard/IMG_8203.JPG
