guilhermelionzo/tcc_files/imagens/protoboard/IMG_8204.JPG

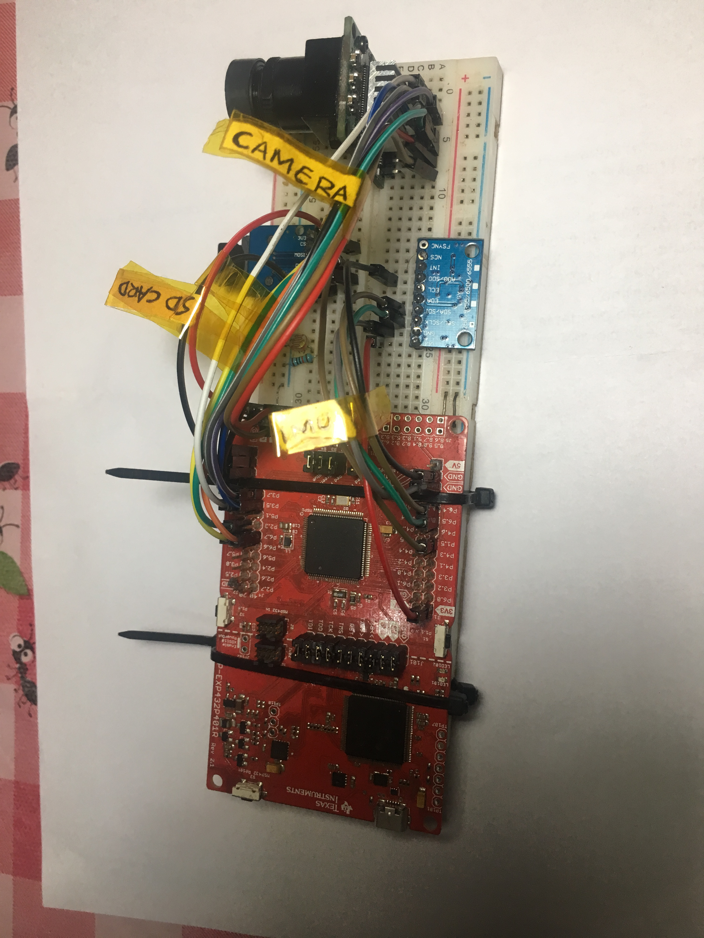
imagens/protoboard/IMG_8204.JPG
