guilhermelionzo/tcc_files/imagens/protoboard/IMG_8205.JPG

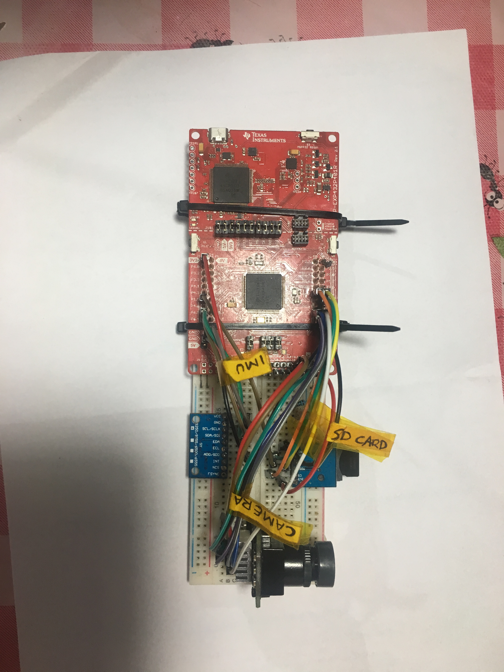
imagens/protoboard/IMG_8205.JPG
