guilhermelionzo/tcc_files/imagens/protoboard/IMG_8206.JPG

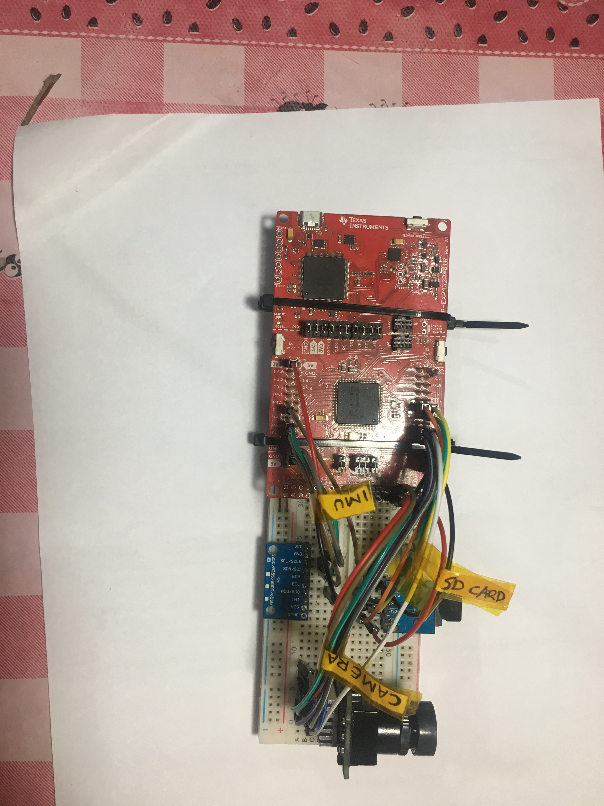
imagens/protoboard/IMG_8206.JPG
