guilhermelionzo/tcc_files/imagens/rodapé.jpg

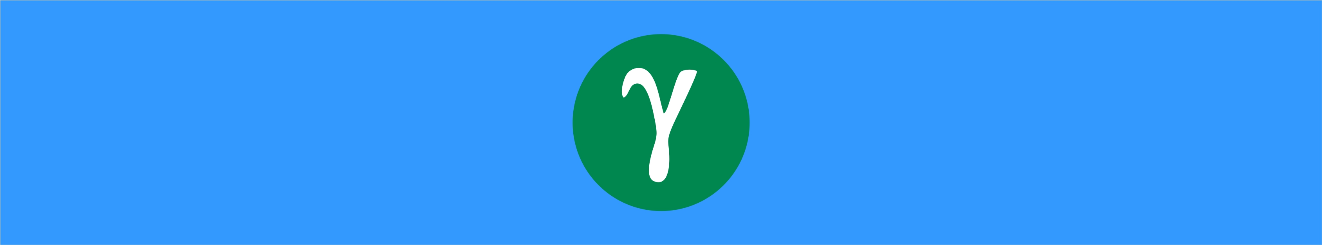
imagens/rodapé.jpg
