guilhermelionzo/tcc_files/imagens/ToDo.PNG

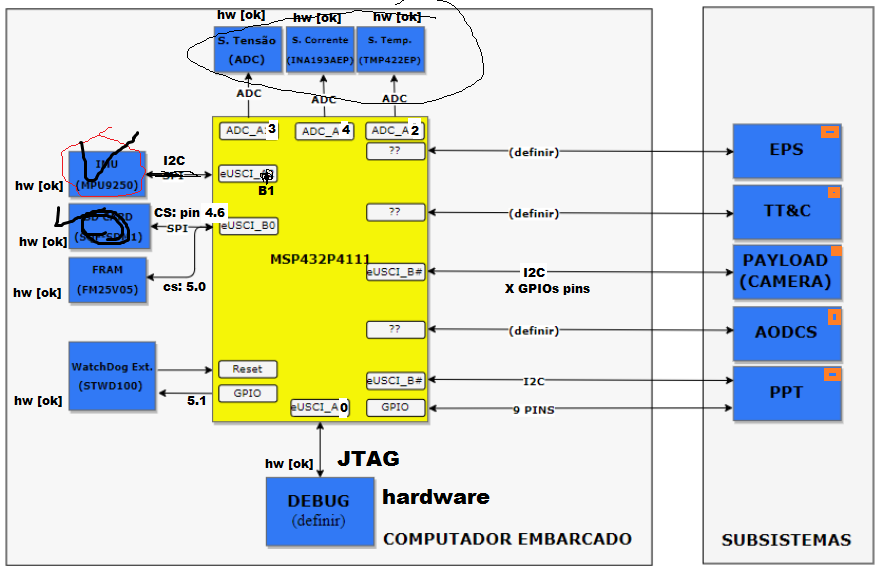
imagens/ToDo.PNG
