guilhermelionzo/tcc_files/imagens/Topologia_Hardware.jpg

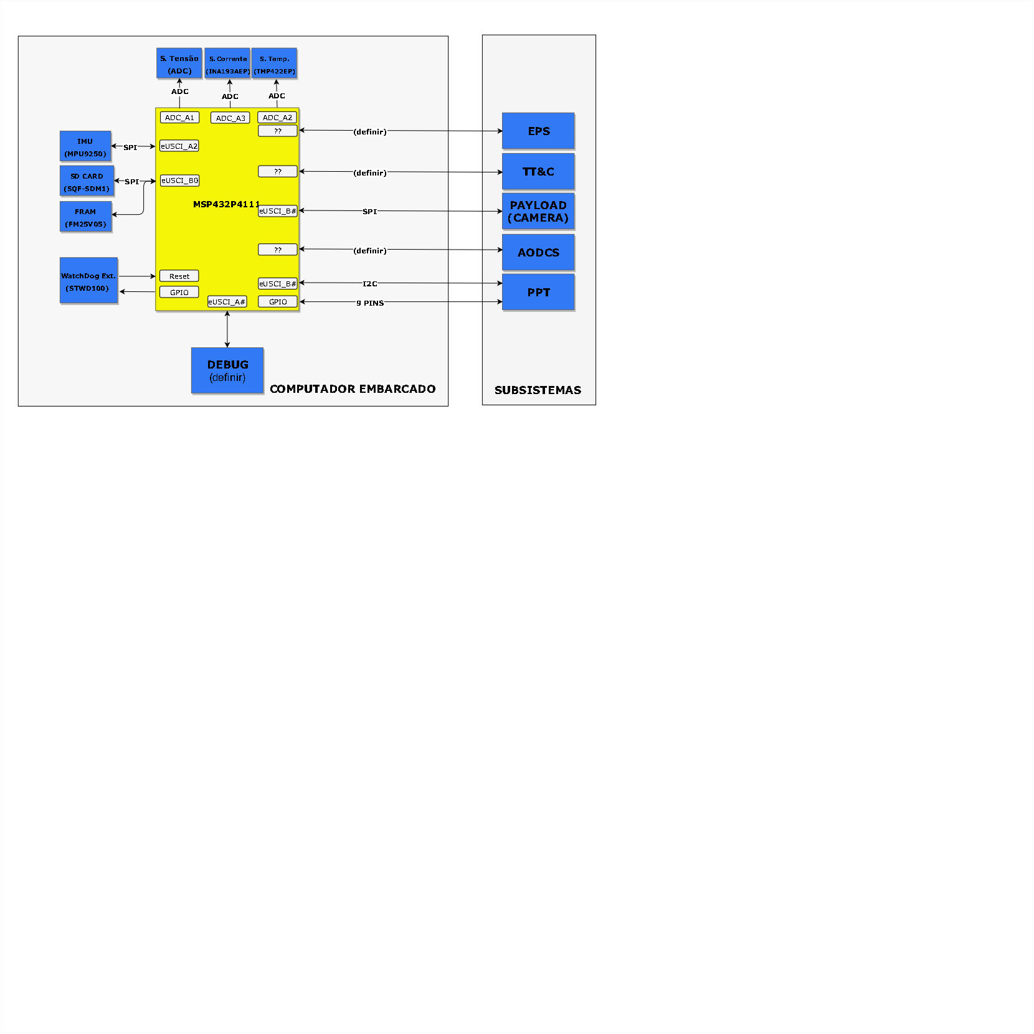
imagens/Topologia_Hardware.jpg
