guilhermelionzo/tcc_files/imagens/uhf-communication-cubesat-module-endurosat-1024x683.png

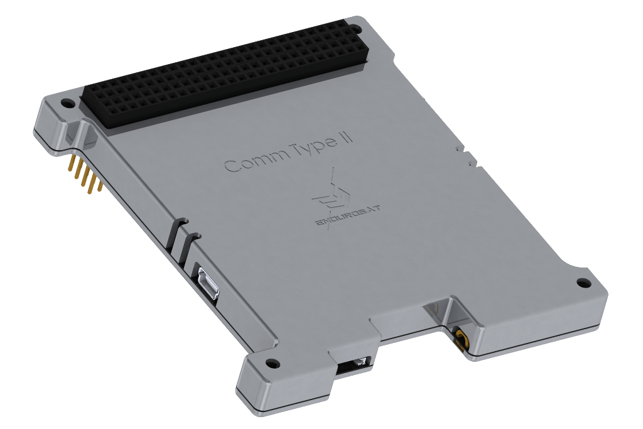
imagens/uhf-communication-cubesat-module-endurosat-1024x683.png
