guilhermelionzo/tcc_files/latex/figuras/arquitetura_de_hardware_2.png

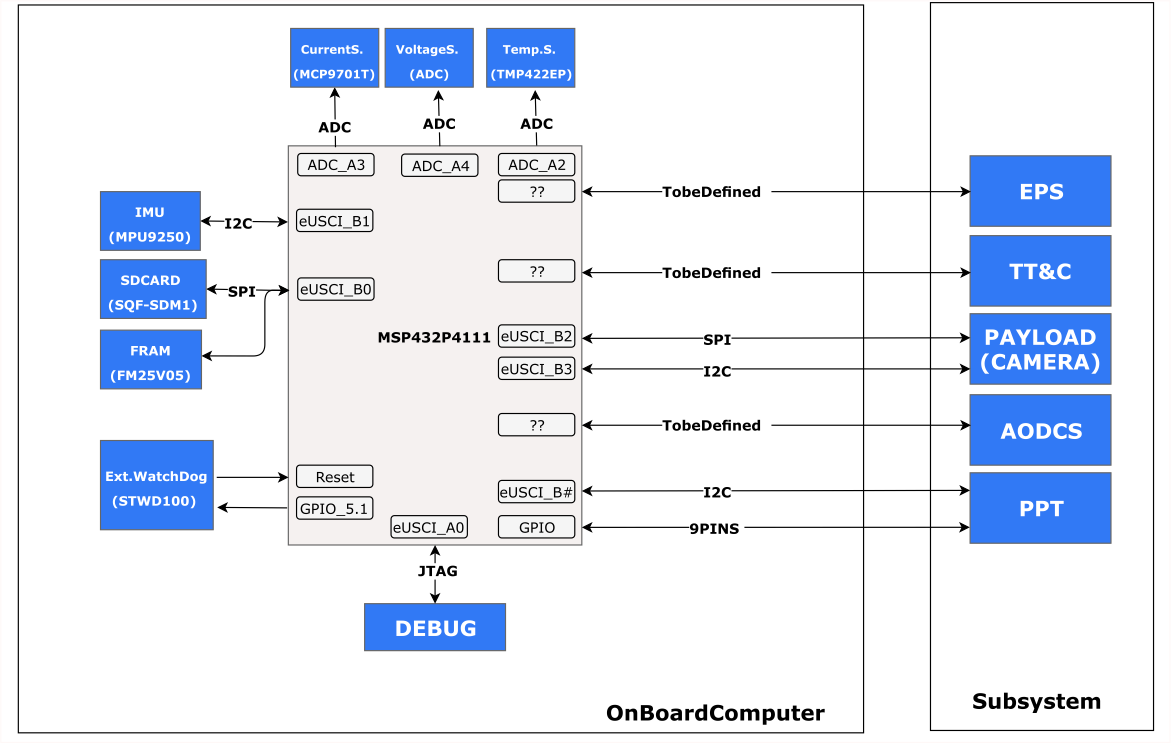
latex/figuras/arquitetura_de_hardware_2.png
