guilhermelionzo/tcc_files/latex/figuras/arquitetura_de_software_2.png

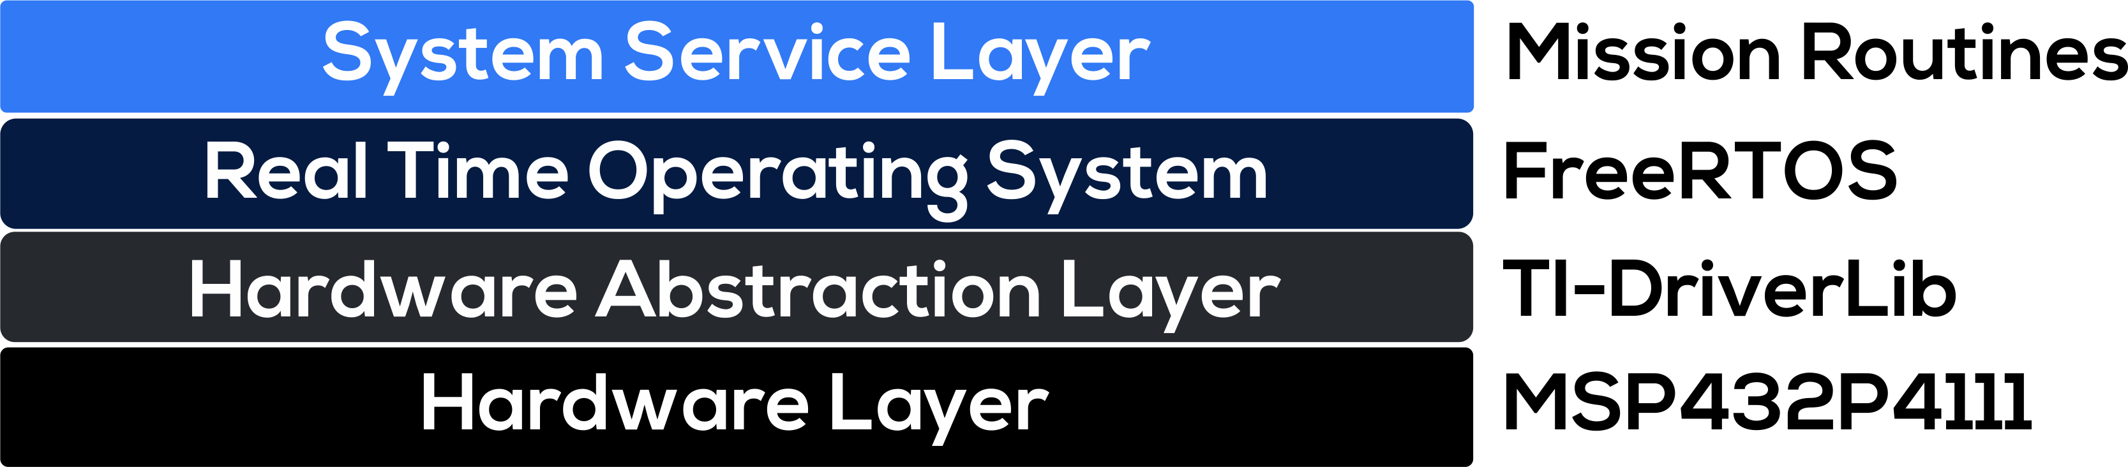
latex/figuras/arquitetura_de_software_2.png
