guilhermelionzo/tcc_files/latex/figuras/bottomLayer.png

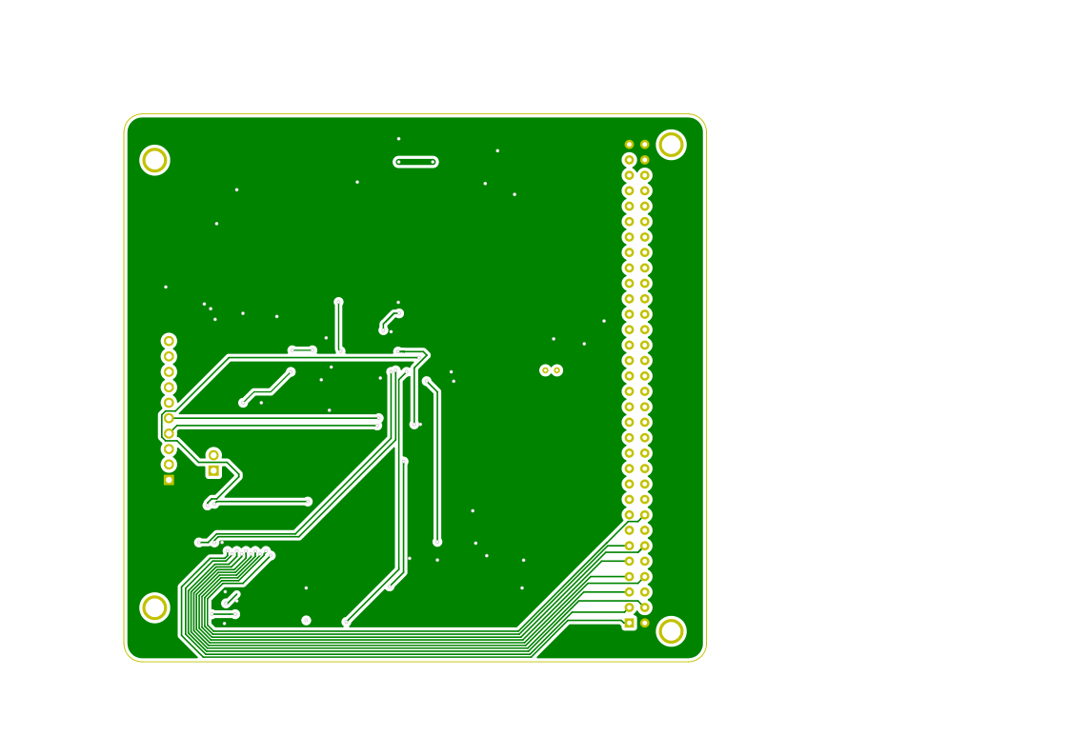
latex/figuras/bottomLayer.png
