guilhermelionzo/tcc_files/latex/figuras/currentSensor.JPG

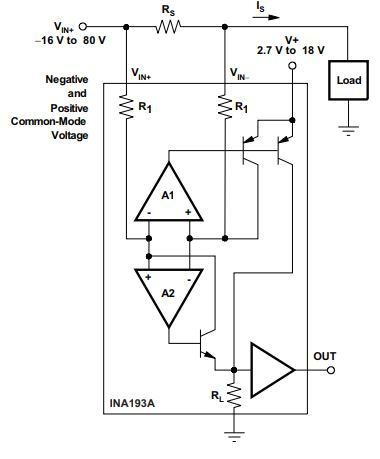
latex/figuras/currentSensor.JPG
