guilhermelionzo/tcc_files/latex/figuras/esquematico.PNG

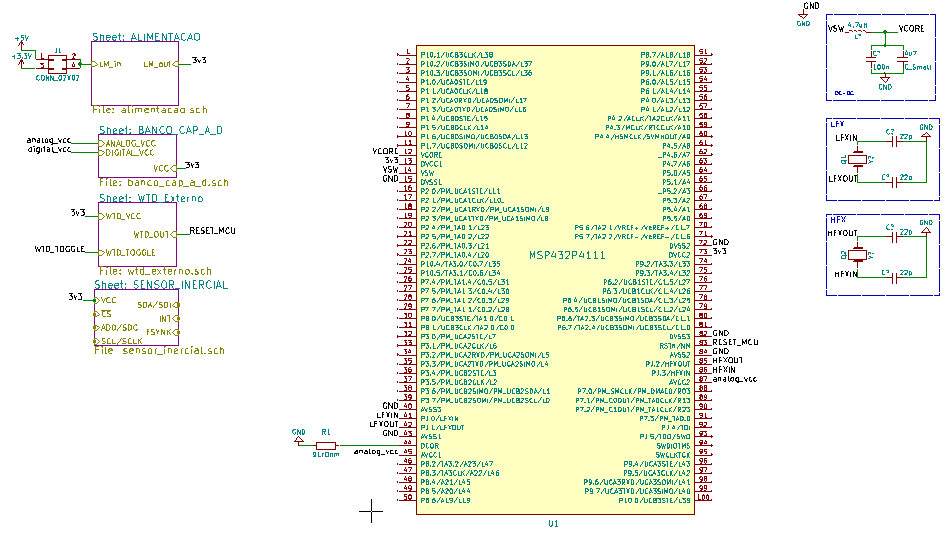
latex/figuras/esquematico.PNG
