guilhermelionzo/tcc_files/latex/figuras/eventLog_wtd.png

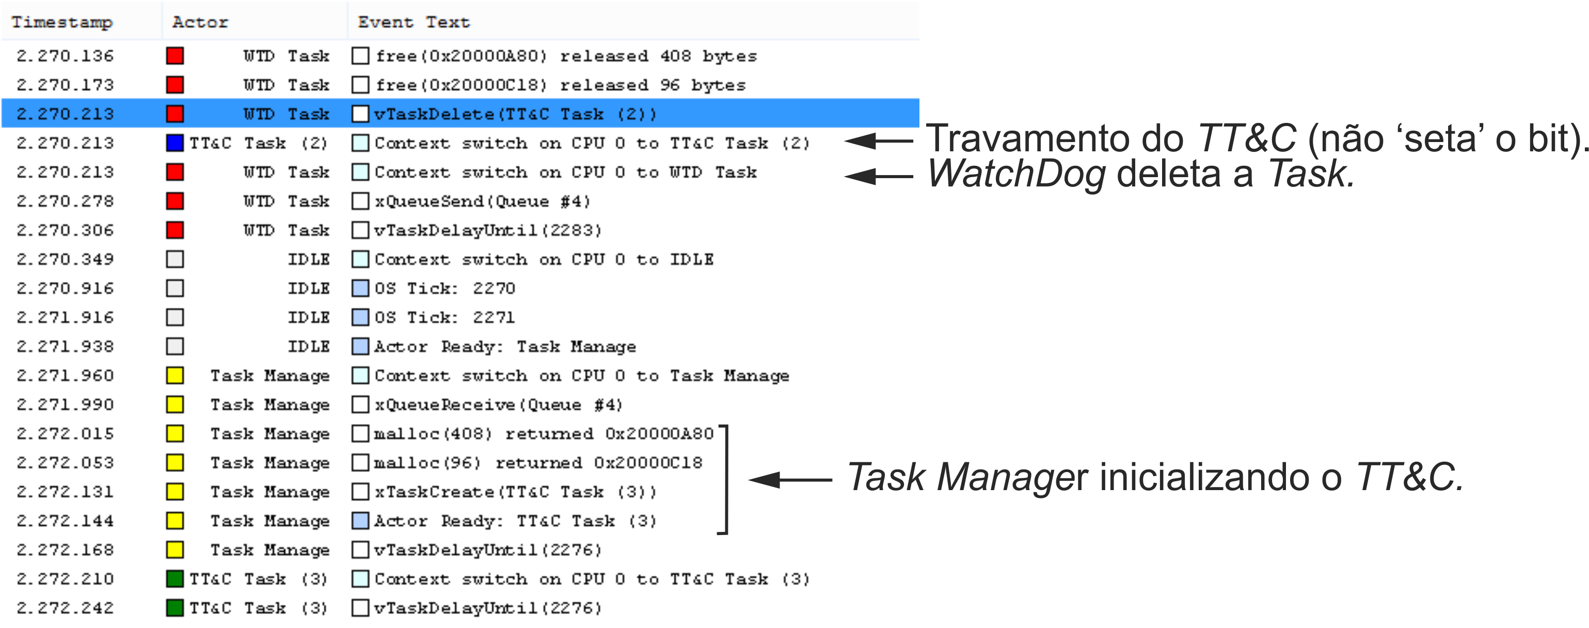
latex/figuras/eventLog_wtd.png
