guilhermelionzo/tcc_files/latex/figuras/gndSignal.PNG

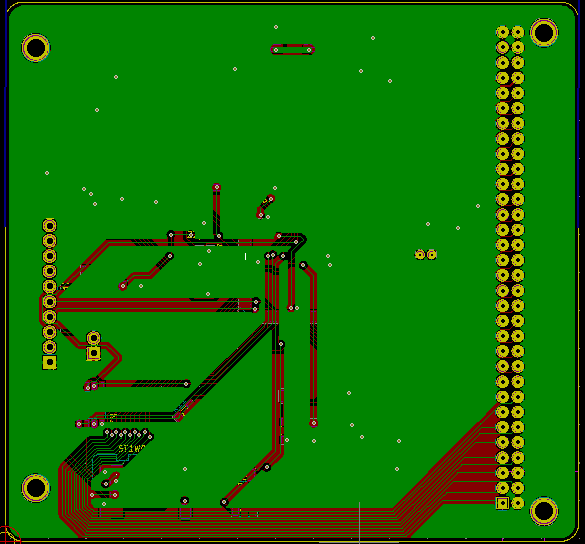
latex/figuras/gndSignal.PNG
