guilhermelionzo/tcc_files/latex/figuras/hibernatexLBM_data.PNG

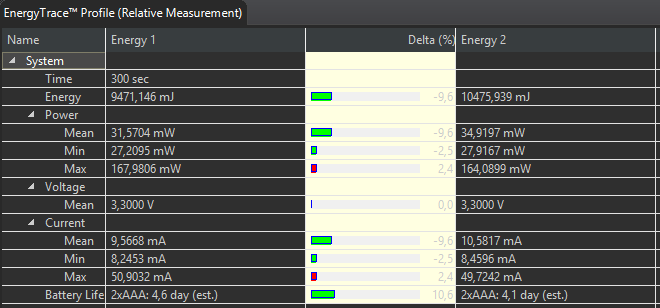
latex/figuras/hibernatexLBM_data.PNG
