guilhermelionzo/tcc_files/latex/figuras/mpu9250_esquema.PNG

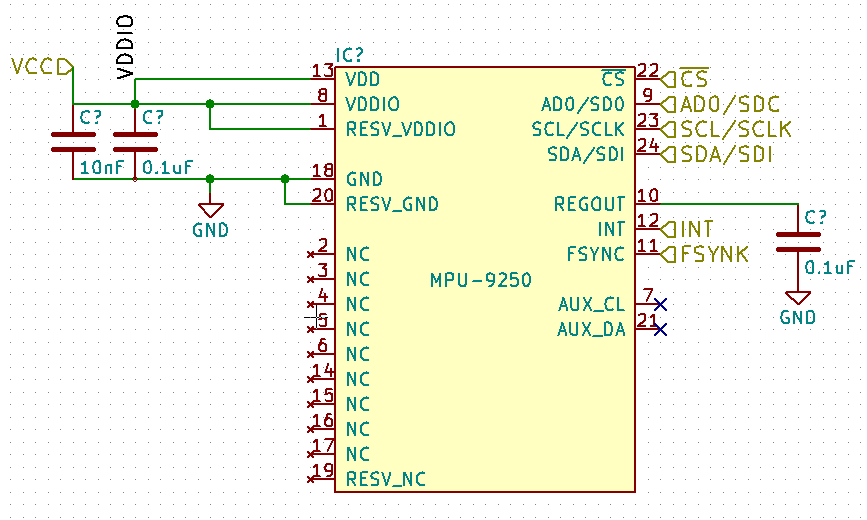
latex/figuras/mpu9250_esquema.PNG
