guilhermelionzo/tcc_files/latex/figuras/pcb_back.png

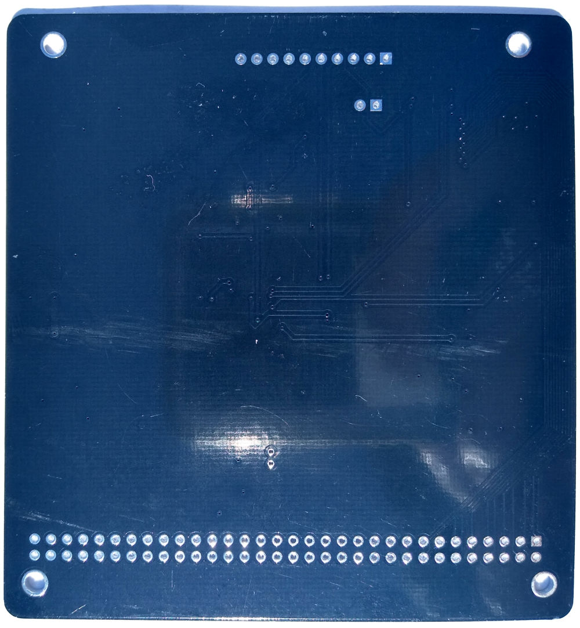
latex/figuras/pcb_back.png
