guilhermelionzo/tcc_files/latex/figuras/pcb_front.png

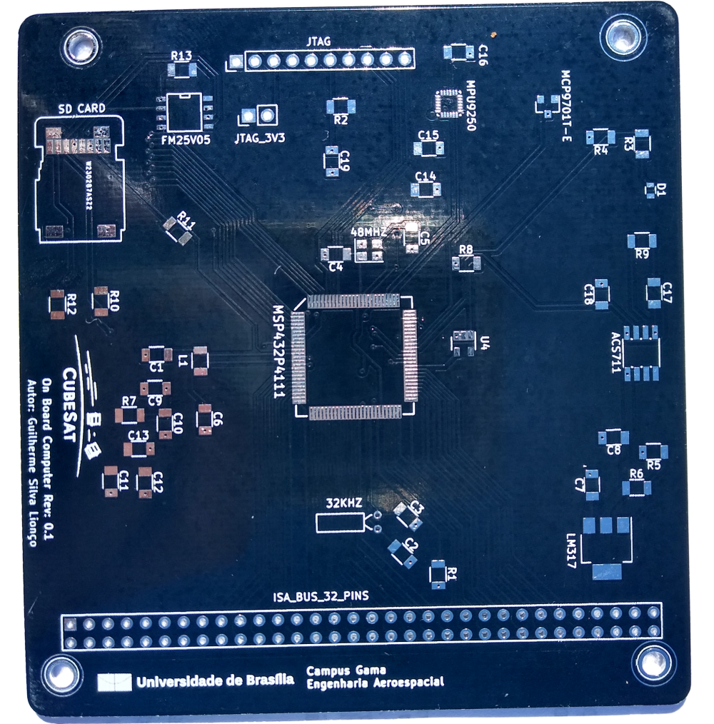
latex/figuras/pcb_front.png
