guilhermelionzo/tcc_files/latex/figuras/pcbFoto.jpg

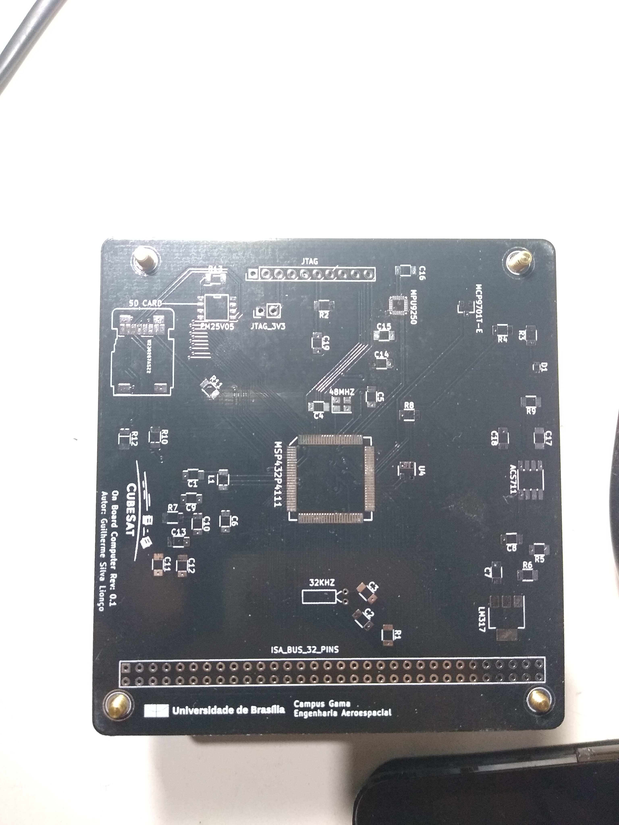
latex/figuras/pcbFoto.jpg
