guilhermelionzo/tcc_files/latex/figuras/powerComsuption.PNG

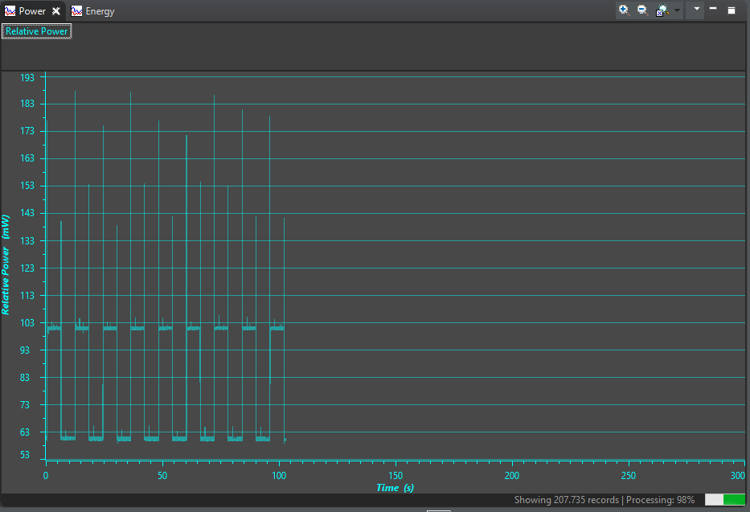
latex/figuras/powerComsuption.PNG
