guilhermelionzo/tcc_files/latex/figuras/protoboard.jpg

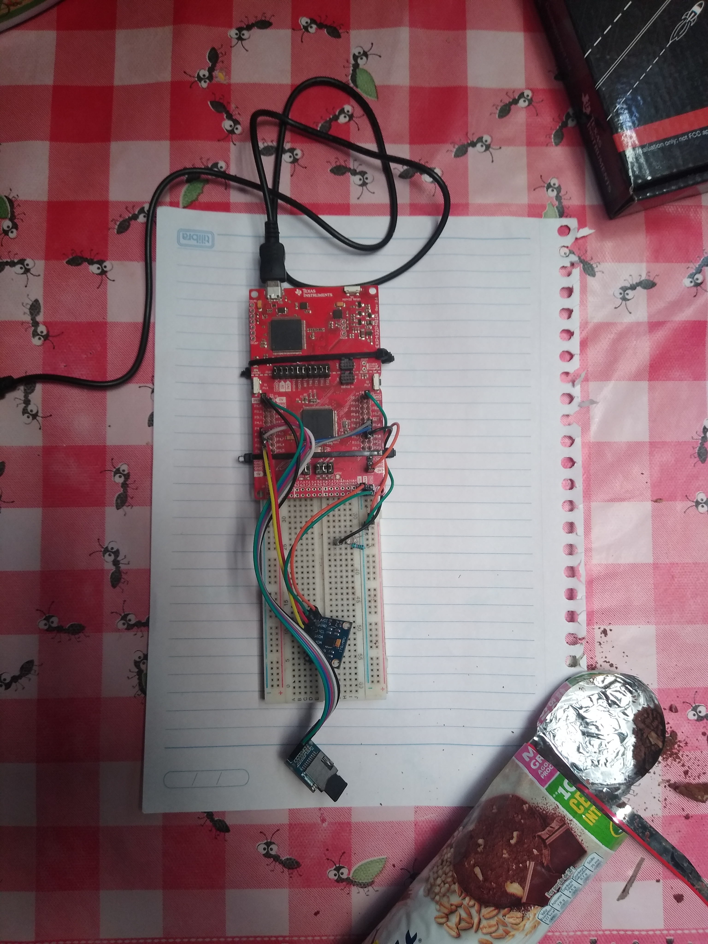
latex/figuras/protoboard.jpg
