guilhermelionzo/tcc_files/latex/figuras/protoboardComplete.png

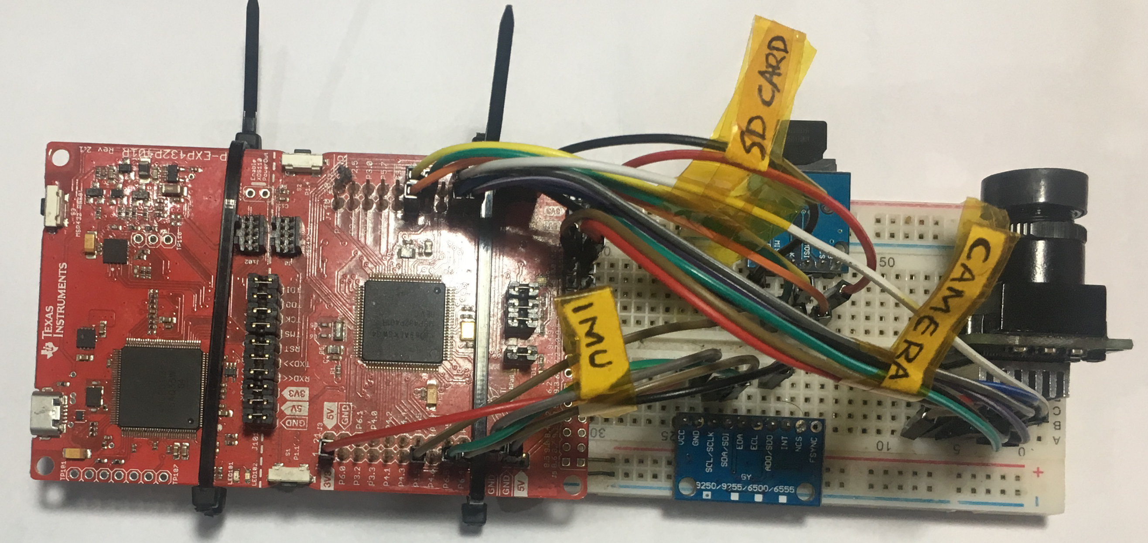
latex/figuras/protoboardComplete.png
