guilhermelionzo/tcc_files/latex/figuras/signalLayout.PNG

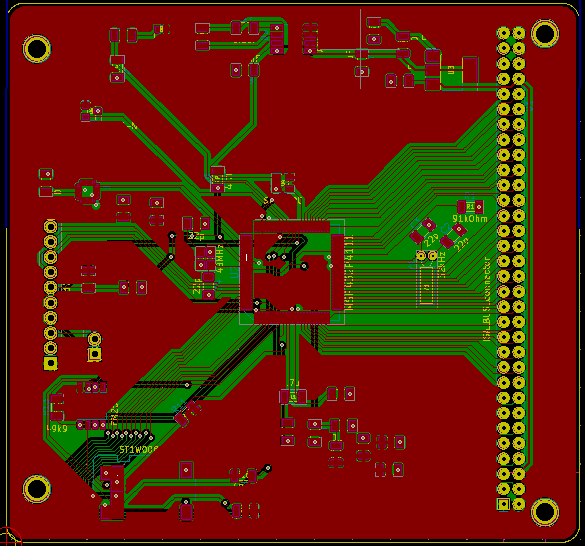
latex/figuras/signalLayout.PNG
