guilhermelionzo/tcc_files/latex/figuras/trace_snapshoot.PNG

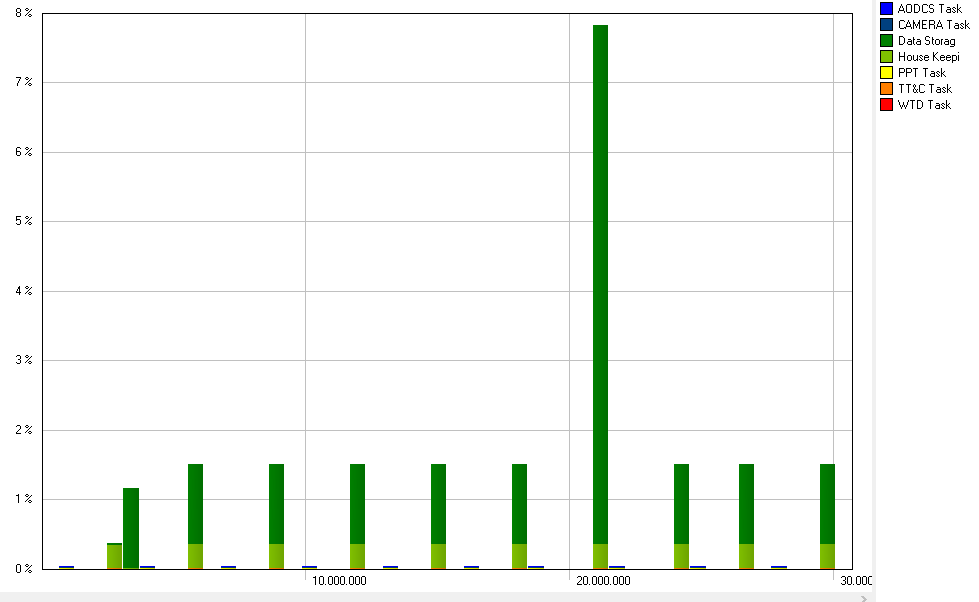
latex/figuras/trace_snapshoot.PNG
