guilhermelionzo/tcc_files/latex/figuras/trace_snapshoot_6.PNG

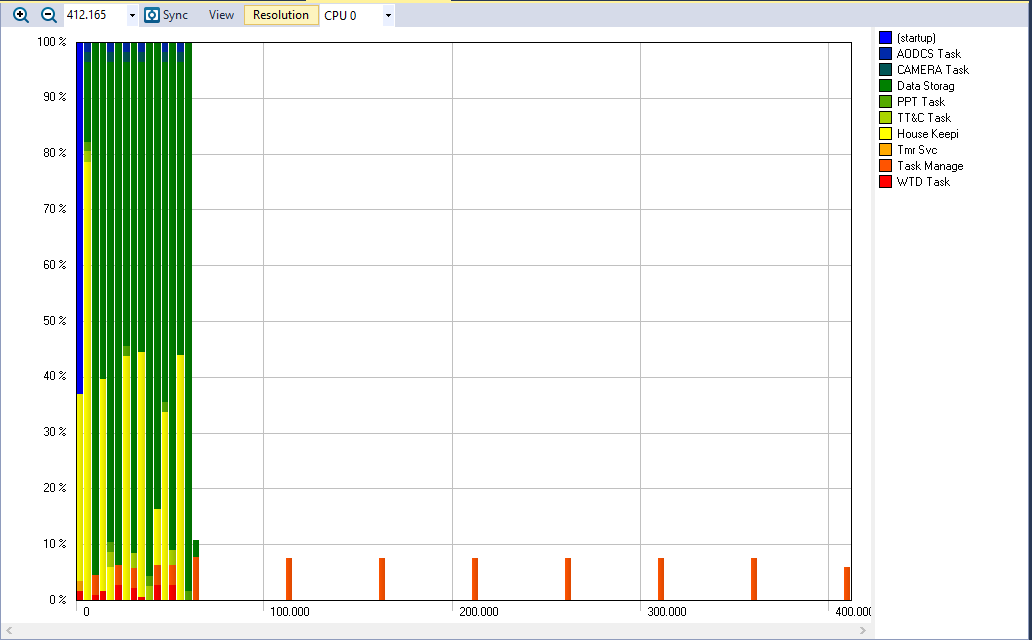
latex/figuras/trace_snapshoot_6.PNG
