guilhermelionzo/tcc_files/latex/figuras/trace_snapshoot_7.PNG

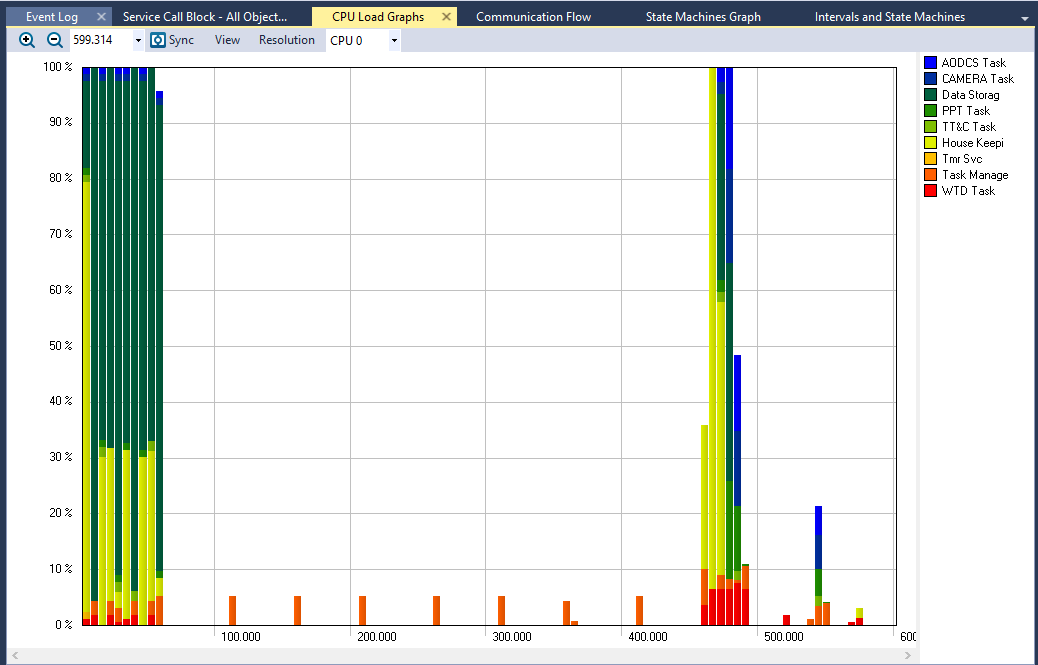
latex/figuras/trace_snapshoot_7.PNG
