guilhermelionzo/tcc_files/latex/figuras/upperLayer.png

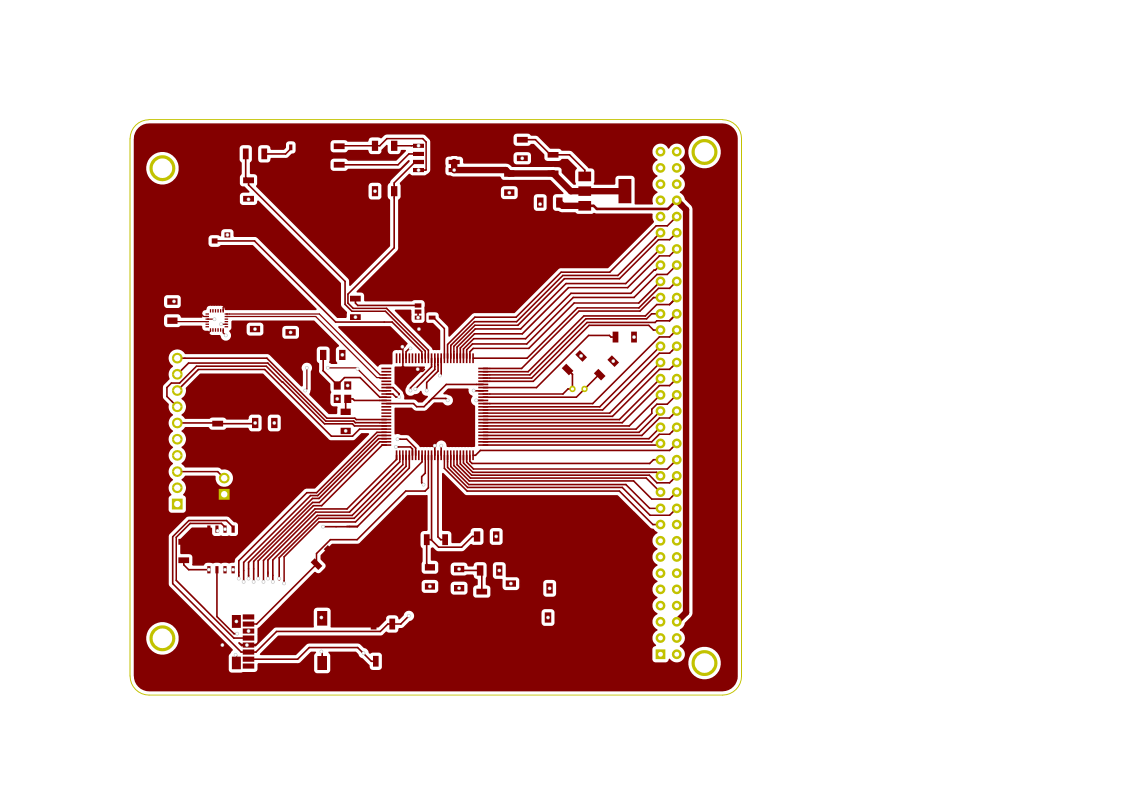
latex/figuras/upperLayer.png
