guilhermelionzo/tcc_files/latex/figuras/watchDogFreeRTOS.PNG

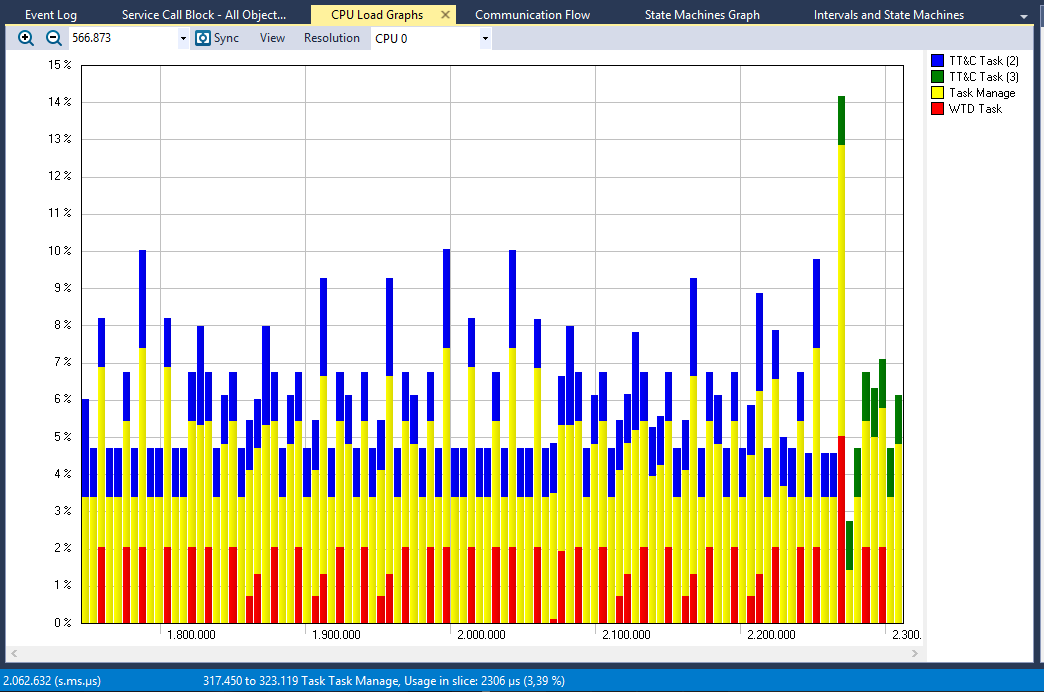
latex/figuras/watchDogFreeRTOS.PNG
