guilhermelionzo/tcc_files/latex/figuras/watchDogFreeRTOS_2.PNG

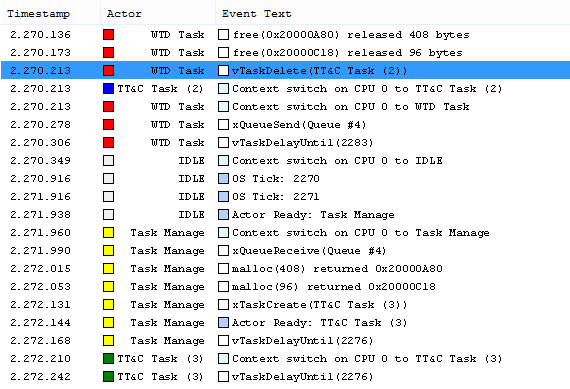
latex/figuras/watchDogFreeRTOS_2.PNG
