guilhermelionzo/tcc_files/latex/figuras/wtd_esquema.PNG

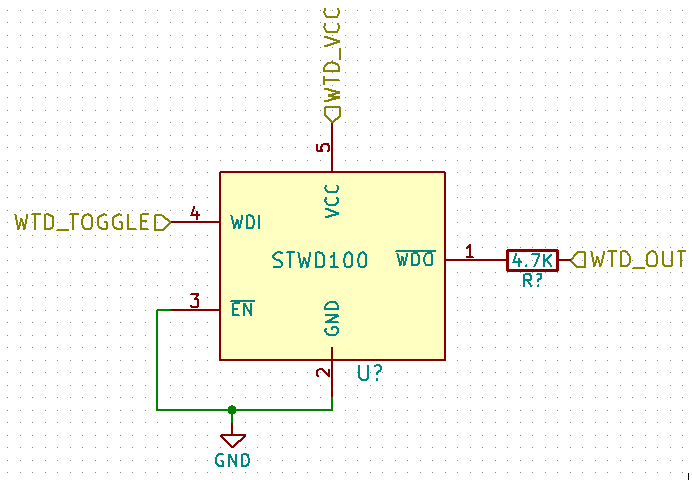
latex/figuras/wtd_esquema.PNG
