guilhermelionzo/tcc_files/pcb/images/groundPlane_view.jpeg

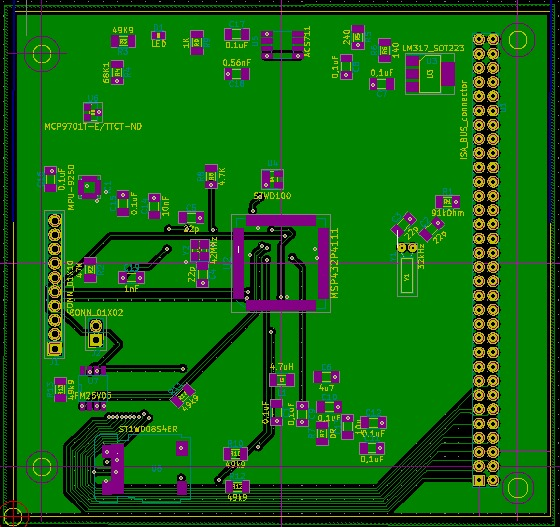
pcb/images/groundPlane_view.jpeg
