guilhermelionzo/tcc_files/pcb/images/realistic_view.jpeg

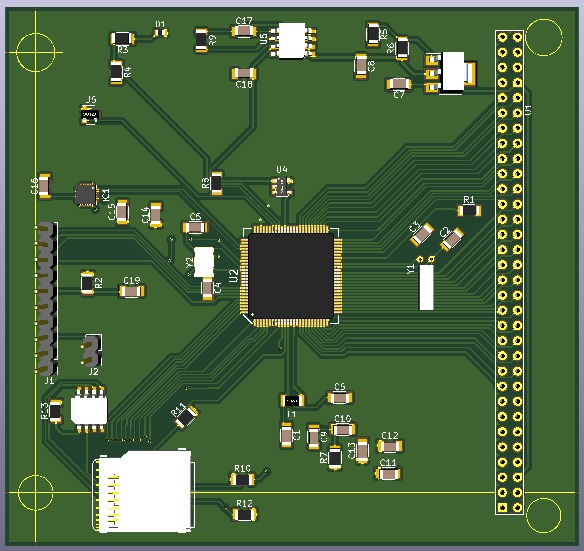
pcb/images/realistic_view.jpeg
