guilhermelionzo/tcc_files/pcb/images/SignalView_pcb.jpeg

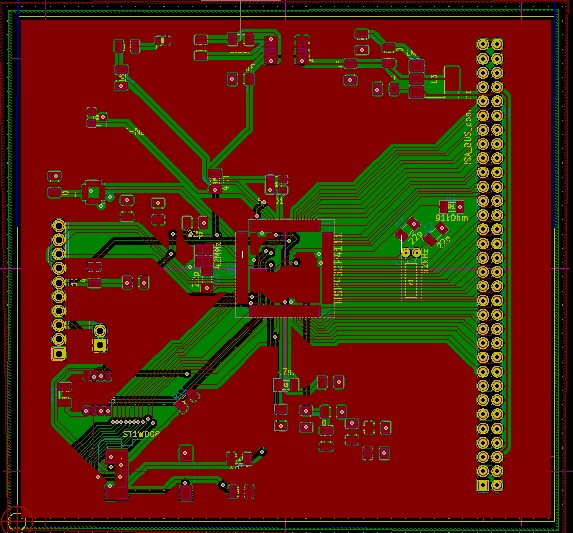
pcb/images/SignalView_pcb.jpeg
