guilhermelionzo/tcc_files/bom_v1.xlsx

Index | Quantity | Part Number | Manufacturer Part Number | Description | Customer Reference | Available | Backorder | Unit Price | Extended Price USD
1 | 2 | 478-2368-1-ND | TAJA104K035RNJ | CAP TANT 0.1UF 10% 35V 1206 |  | 2 | 0 | 0.49 | 0.98
2 | 2 | 490-10390-1-ND | GRM033C80J104KE15D | CAP CER 0.1UF 6.3V X6S 0201 |  | 2 | 0 | 0.1 | 0.20
3 | 6 | 311-1179-1-ND | CC1206KRX7R9BB104 | CAP CER 0.1UF 50V X7R 1206 |  | 6 | 0 | 0.24 | 1.44
4 | 1 | 478-1653-1-ND | TAJA106K006RNJ | CAP TANT 10UF 10% 6.3V 1206 |  | 1 | 0 | 0.34 | 0.34
5 | 1 | 490-7194-1-ND | GRM033R61E103KA12D | CAP CER 10000PF 25V X5R 0201 |  | 1 | 0 | 0.1 | 0.10
6 | 1 | RMCF1206ZT0R00CT-ND | RMCF1206ZT0R00 | RES 0 OHM JUMPER 1/4W 1206 |  | 1 | 0 | 0.1 | 0.10
7 | 1 | RMCF1206FT140RCT-ND | RMCF1206FT140R | RES 140 OHM 1% 1/4W 1206 |  | 1 | 0 | 0.1 | 0.10
8 | 1 | RNCP1206FTD1K00CT-ND | RNCP1206FTD1K00 | RES 1K OHM 1% 1/2W 1206 |  | 1 | 0 | 0.1 | 0.10
9 | 1 | P240BCCT-ND | ERA-8AEB241V | RES SMD 240 OHM 0.1% 1/4W 1206 |  | 1 | 0 | 0.66 | 0.66
10 | 1 | A130181CT-ND | CRGCQ1206J4K7 | CRGCQ 1206 4K7 5% |  | 1 | 0 | 0.1 | 0.10
11 | 1 | RMCF1206JT47K0CT-ND | RMCF1206JT47K0 | RES 47K OHM 5% 1/4W 1206 |  | 1 | 0 | 0.1 | 0.10
12 | 5 | P49.9KBCCT-ND | ERA-8AEB4992V | RES SMD 49.9K OHM 0.1% 1/4W 1206 |  | 5 | 0 | 0.66 | 3.30
13 | 1 | RNCP1206FTD68K1CT-ND | RNCP1206FTD68K1 | RES 68.1K OHM 1% 1/2W 1206 |  | 1 | 0 | 0.1 | 0.10
14 | 1 | 311-91.0KFRCT-ND | RC1206FR-0791KL | RES SMD 91K OHM 1% 1/4W 1206 |  | 1 | 0 | 0.1 | 0.10
15 | 1 | 399-17482-1-ND | C1206C511J5GAC7800 | CAP CER 510PF 50V NP0 1206 |  | 1 | 0 | 0.45 | 0.45
16 | 1 | 399-1222-1-ND | C1206C102K1RACTU | CAP CER 1000PF 100V X7R 1206 |  | 1 | 0 | 0.32 | 0.32
17 | 6 | 490-11621-1-ND | GRM31A5C2J220JW01D | CAP CER 22PF 630V C0G/NP0 1206 |  | 6 | 0 | 0.47 | 2.82
18 | 1 | 399-1262-1-ND | C1206C475Z4VACTU | CAP CER 4.7UF 16V Y5V 1206 |  | 1 | 0 | 0.27 | 0.27
19 | 1 | SML-D12U1WT86CT-ND | SML-D12U1WT86 | LED RED DIFFUSED 1608 SMD |  | 1 | 0 | 0.22 | 0.22
20 | 1 | SER3310-ND | C-2 32.0000K-P:PBFREE | CRYSTAL 32.0000KHZ 11PF T/H |  | 1 | 0 | 0.94 | 0.94
21 | 1 | 490-6706-1-ND | LQM31PN4R7M00L | FIXED IND 4.7UH 700MA 300 MOHM |  | 1 | 0 | 0.4 | 0.40
22 | 1 | 535-11305-1-ND | ABM3C-48.000MHZ-D4Y-T | CRYSTAL 48.0000MHZ 18PF SMD |  | 1 | 0 | 0.86 | 0.86
23 | 1 | 620-1370-1-ND | ACS711ELCTR-12AB-T | SENSOR CURRENT HALL 12.5A AC/DC |  | 1 | 0 | 2.89 | 2.89
24 | 1 | 428-3213-ND | FM25V05-G | IC FRAM 512K SPI 40MHZ 8SOIC |  | 1 | 0 | 13.89 | 13.89
25 | 1 | 296-12602-1-ND | LM317DCYR | IC REG LIN POS ADJ 1.5A SOT223-4 |  | 1 | 0 | 0.8 | 0.80
26 | 1 | MCP9701T-E/TTCT-ND | MCP9701T-E/TT | SENSOR ANALOG -10C-125C SOT23-3 |  | 1 | 0 | 0.26 | 0.26
27 | 1 | 670-1528-1-ND | ST1W008S4ER1500 | CONN MICRO SD CARD HINGED TYPE |  | 1 | 0 | 1.99 | 1.99
28 | 1 | 497-10058-1-ND | STWD100NYWY3F | IC WATCHDOG TIME CIRCUIT SOT23-5 |  | 1 | 0 | 0.85 | 0.85
29 | 1 | 296-50599-ND | MSP432P4111IPZ | IC MCU 32BIT 2MB FLASH 100LQFP |  | 1 | 0 | 13.35 | 13.35
30 | 1 | 1428-1011-1-ND | MPU-6500 | IMU ACCEL/GYRO 3-AXIS I2C 24QFN |  | 1 | 0 | 8.31 | 8.31
