guilhermelionzo/tcc_files/pcb/bom_material.xlsx

Sheet: main
 | BOM | PCB
VALOR | $56.34 | $5.00
FRETE | $40.00 | $41.00
TOTAL USD | $96.34 | $46.00
TOTAL BRL | R$423.90 | R$202.40
 | R$626.30

Sheet: BOM
STATUS | ref | value5 | footprint | datasheet | lib | part | description | names | tstamps6 | tstamp | field | name7 | lib8 | part9 | description10 | docs | fp | field11 | name12 | num | name13 | type | logical | uri | code | name14 | ref15 | pin
OK | C1 | 0.1uF | Capacitors_SMD:C_1206 | https://www.digikey.com/product-detail/en/yageo/CC1206KRX7R9BB104/311-1179-1-ND/303089 | Device | C_Small | Unpolarized capacitor, small symbol | / | / | 5B1D0DBC
OK | C10 | 0.1uF | Capacitors_SMD:C_1206 | https://www.digikey.com/product-detail/en/yageo/CC1206KRX7R9BB104/311-1179-1-ND/303089 | Device | C_Small | Unpolarized capacitor, small symbol | /CAP_AC_DC/ | /5B1CC14F/ | 5B1CC4B7
OK | C11 | 0.1uF | Capacitors_SMD:C_1206 | https://www.digikey.com/product-detail/en/yageo/CC1206KRX7R9BB104/311-1179-1-ND/303089 | Device | C_Small | Unpolarized capacitor, small symbol | /CAP_AC_DC/ | /5B1CC14F/ | 5B1CC509
OK | C12 | 0.1uF | Capacitors_SMD:C_1206 | https://www.digikey.com/product-detail/en/yageo/CC1206KRX7R9BB104/311-1179-1-ND/303089 | Device | C_Small | Unpolarized capacitor, small symbol | /CAP_AC_DC/ | /5B1CC14F/ | 5B1CC58F
OK | C13 | 10uF | Capacitors_SMD:C_1206 | https://www.digikey.com/product-detail/en/avx-corporation/TAJA106K006RNJ/478-1653-1-ND/564685 | Device | CP | Polarized capacitor | /CAP_AC_DC/ | /5B1CC14F/ | 5B1CC377
OK | C14 | 10nF | Capacitors_SMD:C_1206 | https://www.digikey.com/product-detail/en/murata-electronics-north-america/GRM033R61E103KA12D/490-7194-2-ND/3900496 | Device | C | Unpolarized capacitor | /SENSOR_INERCIAL / | /5B1DB60E/ | 5B1DB743
OK | C15 | 0.1uF | Capacitors_SMD:C_1206 | https://www.digikey.com/product-detail/en/murata-electronics-north-america/GRM033C80J104KE15D/490-10390-1-ND/5026263 | Device | C | Unpolarized capacitor | /SENSOR_INERCIAL / | /5B1DB60E/ | 5B1DB947
OK | C16 | 0.1uF | Capacitors_SMD:C_1206 | https://www.digikey.com/product-detail/en/murata-electronics-north-america/GRM033C80J104KE15D/490-10390-1-ND/5026263 | Device | C | Unpolarized capacitor | /SENSOR_INERCIAL / | /5B1DB60E/ | 5B1DB835
OK | C17 | 0.1uF | Capacitors_SMD:C_1206 | https://www.digikey.com/product-detail/en/yageo/CC1206KRX7R9BB104/311-1179-1-ND/303089 | Device | C | Unpolarized capacitor | /CurrentSensor/ | /5B5D629B/ | 5B5DC977
OK | C18 | 0.56nF | Capacitors_SMD:C_1206 | https://www.digikey.com/product-detail/en/kemet/C1206C511J5GAC7800/399-17482-1-ND/8570449 | Device | C | Unpolarized capacitor | /CurrentSensor/ | /5B5D629B/ | 5B5DD57D
OK | C19 | 1nF | Capacitors_SMD:C_1206 | https://www.digikey.com/product-detail/en/kemet/C1206C102K1RACTU/399-1222-1-ND/411497 | Device | C | Unpolarized capacitor | / | / | 5CD7E615
OK | C2 | 22p | Capacitors_SMD:C_1206 | https://www.digikey.com/product-detail/en/murata-electronics-north-america/GRM31A5C2J220JW01D/490-11621-2-ND/4359002 | Device | C_Small | Unpolarized capacitor, small symbol | / | / | 5B1D237F
OK | C3 | 22p | Capacitors_SMD:C_1206 | https://www.digikey.com/product-detail/en/murata-electronics-north-america/GRM31A5C2J220JW01D/490-11621-2-ND/4359002 | Device | C_Small | Unpolarized capacitor, small symbol | / | / | 5B1D23E4
OK | C4 | 22p | Capacitors_SMD:C_1206 | https://www.digikey.com/product-detail/en/murata-electronics-north-america/GRM31A5C2J220JW01D/490-11621-2-ND/4359002 | Device | C_Small | Unpolarized capacitor, small symbol | / | / | 5B1D36CF
OK | C5 | 22p | Capacitors_SMD:C_1206 | https://www.digikey.com/product-detail/en/murata-electronics-north-america/GRM31A5C2J220JW01D/490-11621-2-ND/4359002 | Device | C_Small | Unpolarized capacitor, small symbol | / | / | 5B1D36D5
OK | C6 | 4u7 | Capacitors_SMD:C_1206 | https://www.digikey.com/product-detail/en/kemet/C1206C475Z4VACTU/399-1262-1-ND/411537 | Device | C_Small | Unpolarized capacitor, small symbol | / | / | 5B1D0E36
OK | C7 | 0.1uF | Capacitors_SMD:C_1206 | https://www.digikey.com/product-detail/en/avx-corporation/TAJA104K035RNJ/478-2368-2-ND/678452 | Device | CP1 | Polarized capacitor, US symbol | /ALIMENTACAO/ | /5AFC2476/ | 5AFC316F
OK | C8 | 0.1uF | Capacitors_SMD:C_1206 | https://www.digikey.com/product-detail/en/avx-corporation/TAJA104K035RNJ/478-2368-2-ND/678452 | Device | CP1 | Polarized capacitor, US symbol | /ALIMENTACAO/ | /5AFC2476/ | 5AFC318C
OK | C9 | 0.1uF | Capacitors_SMD:C_1206 | https://www.digikey.com/product-detail/en/yageo/CC1206KRX7R9BB104/311-1179-1-ND/303089 | Device | C_Small | Unpolarized capacitor, small symbol | /CAP_AC_DC/ | /5B1CC14F/ | 5B1CC325
OK | D1 | LED | Resistors_SMD:R_0603 | https://www.digikey.com/product-detail/en/rohm-semiconductor/SML-D12U1WT86/SML-D12U1WT86CT-ND/5843858 | Device | LED | Light emitting diode | /VoltageSensor/ | /5CD44408/ | 5CD44513
OK | IC1 | MPU-9250 | Housings_DFN_QFN:QFN-24_3x3mm_Pitch0.4mm | https://www.digikey.com/product-detail/en/tdk-invensense/MPU-9250/1428-1019-2-ND/4626449 | mpu-9250 | MPU-9250 | MPU-9250 9DoF IMU from InvenSense | /SENSOR_INERCIAL / | /5B1DB60E/ | 5B1DB684 | 1428-1019-1-ND | DigiKey
OK | IC1 | MPU-9250 | Housings_DFN_QFN:QFN-24_3x3mm_Pitch0.4mm | https://www.digikey.com/product-detail/en/tdk-invensense/MPU-9250/1428-1019-2-ND/4626449 | mpu-9250 | MPU-9250 | MPU-9250 9DoF IMU from InvenSense | /SENSOR_INERCIAL / | /5B1DB60E/ | 5B1DB684 | 883-7942 | RS
NOK | J1 | CONN_01X10 | Pin_Headers:Pin_Header_Straight_1x10_Pitch2.54mm | https://www.digikey.com/product-detail/en/amphenol-icc-fci/67997-410HLF/609-3243-ND/1878475 | conn | CONN_01X10 | Connector, single row, 01x10, pin header | /jtag/ | /5CD7D296/ | 5CD8ACB1
NOK | J2 | CONN_01X02 | Pin_Headers:Pin_Header_Straight_1x02_Pitch2.54mm | https://www.digikey.com/product-detail/en/amphenol-icc-fci/67997-410HLF/609-3243-ND/1878475 | conn | CONN_01X02 | Connector, single row, 01x02, pin header | /jtag/ | /5CD7D296/ | 5CD8AD81
OK | L1 | 4.7uH | Inductors_SMD:L_1206 | https://www.digikey.com/product-detail/en/murata-electronics-north-america/LQM31PN4R7M00L/490-6706-1-ND/3845903 | Device | L | Inductor | / | / | 5B1D0C56
OK | R1 | 91kOhm | Resistors_SMD:R_1206 | https://www.digikey.com/product-detail/en/yageo/RC1206FR-0791KL/311-91.0KFRCT-ND/732116 | Device | R | Resistor | / | / | 5AFB9135
OK | R10 | 49k9 | Resistors_SMD:R_1206 | https://www.digikey.com/product-detail/en/panasonic-electronic-components/ERA-8AEB4992V/P49.9KBCCT-ND/3069837 | Device | R | Resistor | /Memory/ | /5B5F07C9/ | 5CD26002
OK | R11 | 49k9 | Resistors_SMD:R_1206 | https://www.digikey.com/product-detail/en/panasonic-electronic-components/ERA-8AEB4992V/P49.9KBCCT-ND/3069837 | Device | R | Resistor | /Memory/ | /5B5F07C9/ | 5CD25E39
OK | R12 | 49k9 | Resistors_SMD:R_1206 | https://www.digikey.com/product-detail/en/panasonic-electronic-components/ERA-8AEB4992V/P49.9KBCCT-ND/3069837 | Device | R | Resistor | /Memory/ | /5B5F07C9/ | 5CD25E97
OK | R13 | 49k9 | Resistors_SMD:R_1206 | https://www.digikey.com/product-detail/en/panasonic-electronic-components/ERA-8AEB4992V/P49.9KBCCT-ND/3069837 | Device | R | Resistor | /Memory/ | /5B5F07C9/ | 5CD2B918
OK | R2 | 47K | Resistors_SMD:R_1206 | https://www.digikey.com/product-detail/en/stackpole-electronics-inc/RMCF1206JT47K0/RMCF1206JT47K0TR-ND/1753849 | Device | R | Resistor | / | / | 5CD7E54A
OK | R3 | 49K9 | Resistors_SMD:R_1206 | https://www.digikey.com/product-detail/en/panasonic-electronic-components/ERA-8AEB4992V/P49.9KBCCT-ND/3069837 | Device | R | Resistor | /VoltageSensor/ | /5CD44408/ | 5CD444E3
OK | R4 | 68K1 | Resistors_SMD:R_1206 | https://www.digikey.com/product-detail/en/stackpole-electronics-inc/RNCP1206FTD68K1/RNCP1206FTD68K1CT-ND/2240736 | Device | R | Resistor | /VoltageSensor/ | /5CD44408/ | 5CD444FA
OK | R5 | 240 | Resistors_SMD:R_1206 | https://www.digikey.com/product-detail/en/panasonic-electronic-components/ERA-8AEB241V/P240BCCT-ND/3069680 | Device | R | Resistor | /ALIMENTACAO/ | /5AFC2476/ | 5AFC30F1
OK | R6 | 140 | Resistors_SMD:R_1206 | https://www.digikey.com/product-detail/en/stackpole-electronics-inc/RMCF1206FT140R/RMCF1206FT140RCT-ND/2418574 | Device | R | Resistor | /ALIMENTACAO/ | /5AFC2476/ | 5AFC3148
OK | R7 | 0R | Resistors_SMD:R_1206 | https://www.digikey.com/product-detail/en/stackpole-electronics-inc/RMCF1206ZT0R00/RMCF1206ZT0R00TR-ND/1756906 | Device | R | Resistor | /CAP_AC_DC/ | /5B1CC14F/ | 5B1CC61A
OK | R8 | 4.7K | Resistors_SMD:R_1206 | https://www.digikey.com/product-detail/en/te-connectivity-passive-product/CRGCQ1206J4K7/A130181CT-ND/8578013 | Device | R | Resistor | /WTD_Externo/ | /5B1D7EBC/ | 5B1D8509
OK | R9 | 1K | Resistors_SMD:R_1206 | https://www.digikey.com/product-detail/en/stackpole-electronics-inc/RNCP1206FTD1K00/RNCP1206FTD1K00CT-ND/2240675 | Device | R | Resistor | /CurrentSensor/ | /5B5D629B/ | 5B5DD491
NOK | U1 | ISA_BUS_connector | isaConnector:ISA_CONNECTOR | http://www.dpieshop.com/pc104-connector-pin-bit-isa-connector-stackthrough-version-p-520.html | isa_bus_connector | ISA_BUS_connector |  | / | / | 5C8098BD
OK | U2 | MSP432P4111 | PCB_TCC:MSP432P4111 | http://www.ti.com/lit/ds/symlink/msp432p4111.pdf | pcb_v1-rescue | MSP432P4111-RESCUE-pcb_v1 |  | / | / | 5AFB756C
OK | U3 | LM317_SOT223 | TO_SOT_Packages_SMD:SOT-223-3_TabPin2 | https://www.digikey.com/product-detail/en/texas-instruments/LM317DCYR/296-12602-1-ND/443738 | regul | LM317_SOT223 | Linear Regulator (adjustable) | /ALIMENTACAO/ | /5AFC2476/ | 5AFC2FD4
OK | U4 | STWD100 | TO_SOT_Packages_SMD:SOT-23-5 | https://www.digikey.com/product-detail/en/stmicroelectronics/STWD100NYWY3F/497-10058-1-ND/2175107 | stwd100 | STWD100 |  | /WTD_Externo/ | /5B1D7EBC/ | 5B1D7F0F
OK | U5 | ACS711 | .pretty:ACS711_8-pin SOICN | https://www.digikey.com/product-detail/en/allegro-microsystems-llc/ACS711ELCTR-12AB-T/620-1370-1-ND/2470594 | acs711 | ACS711 |  | /CurrentSensor/ | /5B5D629B/ | 5B5DD146
OK | U6 | MCP9701T-E/TTCT-ND | TO_SOT_Packages_SMD:SOT-23 | https://www.digikey.com/product-detail/en/microchip-technology/MCP9701T-E-TT/MCP9701T-E-TTCT-ND/1987446 | pcb_v1-rescue | MCP9700T-E_LT |  | /TemperatureSensor/ | /5B5E7622/ | 5B5E76D9
OK | U7 | FM25V05 | SMD_Packages:SOIC-8-N | https://www.digikey.com/product-detail/en/cypress-semiconductor-corp/FM25V05-G/428-3213-ND/3788675 | FM25V05 | FM25V05 |  | /Memory/ | /5B5F07C9/ | 5BB2AF28
OK | U8 | ST1W008S4ER | ST1W008S4ER1500:ST1W008S4ER1500 | https://www.digikey.com/product-detail/en/jae-electronics/ST1W008S4ER1500/670-1528-1-ND/1668844 | st1w008s4er | ST1W008S4ER |  | /Memory/ | /5B5F07C9/ | 5CD04CC3
OK | Y1 | 32kHz | Crystals:Crystal_DS26_d2.0mm_l6.0mm_Horizontal | https://www.digikey.com/product-detail/en/epson/C-2-32.0000K-P-PBFREE/SER3310-ND/1022102 | Device | Crystal | Two pin crystal | / | / | 5CE338F3
OK | Y2 | 42MHz | Oscillators:Oscillator_SMD_Abracon_ASE-4pin_3.2x2.5mm | https://www.digikey.com/product-detail/en/abracon-llc/ABM3C-48.000MHZ-D4Y-T/535-11305-1-ND/2639936 | Device | Crystal_GND23 | Four pin crystal, GND on pins 2 and 3 | / | / | 5CE1ECEA
 |  |  |  |  |  |  |  |  |  |  |  |  | Device | C | Unpolarized capacitor | ~ | C_*
 |  |  |  |  |  |  |  |  |  |  |  |  | Device | C | Unpolarized capacitor | ~ |  | C | Reference
 |  |  |  |  |  |  |  |  |  |  |  |  | Device | C | Unpolarized capacitor | ~ |  | C | Value
 |  |  |  |  |  |  |  |  |  |  |  |  | Device | C | Unpolarized capacitor | ~ |  |  |  | 1 | ~ | passive
 |  |  |  |  |  |  |  |  |  |  |  |  | Device | C | Unpolarized capacitor | ~ |  |  |  | 2 | ~ | passive
 |  |  |  |  |  |  |  |  |  |  |  |  | Device | CP | Polarized capacitor | ~ | CP_*
 |  |  |  |  |  |  |  |  |  |  |  |  | Device | CP | Polarized capacitor | ~ |  | C | Reference
 |  |  |  |  |  |  |  |  |  |  |  |  | Device | CP | Polarized capacitor | ~ |  | CP | Value
 |  |  |  |  |  |  |  |  |  |  |  |  | Device | CP | Polarized capacitor | ~ |  |  |  | 1 | ~ | passive
 |  |  |  |  |  |  |  |  |  |  |  |  | Device | CP | Polarized capacitor | ~ |  |  |  | 2 | ~ | passive
 |  |  |  |  |  |  |  |  |  |  |  |  | Device | CP1 | Polarized capacitor, US symbol | ~ | CP_*
 |  |  |  |  |  |  |  |  |  |  |  |  | Device | CP1 | Polarized capacitor, US symbol | ~ |  | C | Reference
 |  |  |  |  |  |  |  |  |  |  |  |  | Device | CP1 | Polarized capacitor, US symbol | ~ |  | CP1 | Value
 |  |  |  |  |  |  |  |  |  |  |  |  | Device | CP1 | Polarized capacitor, US symbol | ~ |  |  |  | 1 | ~ | passive
 |  |  |  |  |  |  |  |  |  |  |  |  | Device | CP1 | Polarized capacitor, US symbol | ~ |  |  |  | 2 | ~ | passive
 |  |  |  |  |  |  |  |  |  |  |  |  | Device | C_Small | Unpolarized capacitor, small symbol | ~ | C_*
 |  |  |  |  |  |  |  |  |  |  |  |  | Device | C_Small | Unpolarized capacitor, small symbol | ~ |  | C | Reference
 |  |  |  |  |  |  |  |  |  |  |  |  | Device | C_Small | Unpolarized capacitor, small symbol | ~ |  | C_Small | Value
 |  |  |  |  |  |  |  |  |  |  |  |  | Device | C_Small | Unpolarized capacitor, small symbol | ~ |  |  |  | 1 | ~ | passive
 |  |  |  |  |  |  |  |  |  |  |  |  | Device | C_Small | Unpolarized capacitor, small symbol | ~ |  |  |  | 2 | ~ | passive
 |  |  |  |  |  |  |  |  |  |  |  |  | Device | Crystal | Two pin crystal | ~ | Crystal*
 |  |  |  |  |  |  |  |  |  |  |  |  | Device | Crystal | Two pin crystal | ~ |  | Y | Reference
 |  |  |  |  |  |  |  |  |  |  |  |  | Device | Crystal | Two pin crystal | ~ |  | Crystal | Value
 |  |  |  |  |  |  |  |  |  |  |  |  | Device | Crystal | Two pin crystal | ~ |  |  |  | 1 | 1 | passive
 |  |  |  |  |  |  |  |  |  |  |  |  | Device | Crystal | Two pin crystal | ~ |  |  |  | 2 | 2 | passive
 |  |  |  |  |  |  |  |  |  |  |  |  | Device | Crystal_GND23 | Four pin crystal, GND on pins 2 and 3 | ~ | Crystal*
 |  |  |  |  |  |  |  |  |  |  |  |  | Device | Crystal_GND23 | Four pin crystal, GND on pins 2 and 3 | ~ |  | Y | Reference
 |  |  |  |  |  |  |  |  |  |  |  |  | Device | Crystal_GND23 | Four pin crystal, GND on pins 2 and 3 | ~ |  | Crystal_GND23 | Value
 |  |  |  |  |  |  |  |  |  |  |  |  | Device | Crystal_GND23 | Four pin crystal, GND on pins 2 and 3 | ~ |  |  |  | 1 | 1 | passive
 |  |  |  |  |  |  |  |  |  |  |  |  | Device | Crystal_GND23 | Four pin crystal, GND on pins 2 and 3 | ~ |  |  |  | 2 | 2 | passive
 |  |  |  |  |  |  |  |  |  |  |  |  | Device | Crystal_GND23 | Four pin crystal, GND on pins 2 and 3 | ~ |  |  |  | 3 | 3 | passive
 |  |  |  |  |  |  |  |  |  |  |  |  | Device | Crystal_GND23 | Four pin crystal, GND on pins 2 and 3 | ~ |  |  |  | 4 | 4 | passive
 |  |  |  |  |  |  |  |  |  |  |  |  | Device | L | Inductor | ~ | Choke_*
 |  |  |  |  |  |  |  |  |  |  |  |  | Device | L | Inductor | ~ | *Coil*
 |  |  |  |  |  |  |  |  |  |  |  |  | Device | L | Inductor | ~ | Inductor_*
 |  |  |  |  |  |  |  |  |  |  |  |  | Device | L | Inductor | ~ | L_*
 |  |  |  |  |  |  |  |  |  |  |  |  | Device | L | Inductor | ~ |  | L | Reference
 |  |  |  |  |  |  |  |  |  |  |  |  | Device | L | Inductor | ~ |  | L | Value
 |  |  |  |  |  |  |  |  |  |  |  |  | Device | L | Inductor | ~ |  |  |  | 1 | 1 | passive
 |  |  |  |  |  |  |  |  |  |  |  |  | Device | L | Inductor | ~ |  |  |  | 2 | 2 | passive
 |  |  |  |  |  |  |  |  |  |  |  |  | Device | LED | Light emitting diode | ~ | LED*
 |  |  |  |  |  |  |  |  |  |  |  |  | Device | LED | Light emitting diode | ~ | LED_SMD:*
 |  |  |  |  |  |  |  |  |  |  |  |  | Device | LED | Light emitting diode | ~ | LED_THT:*
 |  |  |  |  |  |  |  |  |  |  |  |  | Device | LED | Light emitting diode | ~ |  | D | Reference
 |  |  |  |  |  |  |  |  |  |  |  |  | Device | LED | Light emitting diode | ~ |  | LED | Value
 |  |  |  |  |  |  |  |  |  |  |  |  | Device | LED | Light emitting diode | ~ |  |  |  | 1 | K | passive
 |  |  |  |  |  |  |  |  |  |  |  |  | Device | LED | Light emitting diode | ~ |  |  |  | 2 | A | passive
 |  |  |  |  |  |  |  |  |  |  |  |  | Device | R | Resistor | ~ | R_*
 |  |  |  |  |  |  |  |  |  |  |  |  | Device | R | Resistor | ~ |  | R | Reference
 |  |  |  |  |  |  |  |  |  |  |  |  | Device | R | Resistor | ~ |  | R | Value
 |  |  |  |  |  |  |  |  |  |  |  |  | Device | R | Resistor | ~ |  |  |  | 1 | ~ | passive
 |  |  |  |  |  |  |  |  |  |  |  |  | Device | R | Resistor | ~ |  |  |  | 2 | ~ | passive
 |  |  |  |  |  |  |  |  |  |  |  |  | FM25V05 | FM25V05 |  |  |  | U | Reference
 |  |  |  |  |  |  |  |  |  |  |  |  | FM25V05 | FM25V05 |  |  |  | FM25V05 | Value
 |  |  |  |  |  |  |  |  |  |  |  |  | FM25V05 | FM25V05 |  |  |  |  |  | 1 | ~CS | input
 |  |  |  |  |  |  |  |  |  |  |  |  | FM25V05 | FM25V05 |  |  |  |  |  | 2 | SO | input
 |  |  |  |  |  |  |  |  |  |  |  |  | FM25V05 | FM25V05 |  |  |  |  |  | 3 | ~WP | input
 |  |  |  |  |  |  |  |  |  |  |  |  | FM25V05 | FM25V05 |  |  |  |  |  | 4 | VSS | input
 |  |  |  |  |  |  |  |  |  |  |  |  | FM25V05 | FM25V05 |  |  |  |  |  | 5 | SI | input
 |  |  |  |  |  |  |  |  |  |  |  |  | FM25V05 | FM25V05 |  |  |  |  |  | 6 | SCK | input
 |  |  |  |  |  |  |  |  |  |  |  |  | FM25V05 | FM25V05 |  |  |  |  |  | 7 | ~HOLD | input
 |  |  |  |  |  |  |  |  |  |  |  |  | FM25V05 | FM25V05 |  |  |  |  |  | 8 | VDD | input
 |  |  |  |  |  |  |  |  |  |  |  |  | acs711 | ACS711 |  |  |  | U | Reference
 |  |  |  |  |  |  |  |  |  |  |  |  | acs711 | ACS711 |  |  |  | ACS711 | Value
 |  |  |  |  |  |  |  |  |  |  |  |  | acs711 | ACS711 |  |  |  |  |  | 1 | IP+ | input
 |  |  |  |  |  |  |  |  |  |  |  |  | acs711 | ACS711 |  |  |  |  |  | 2 | IP+ | input
 |  |  |  |  |  |  |  |  |  |  |  |  | acs711 | ACS711 |  |  |  |  |  | 3 | IP- | input
 |  |  |  |  |  |  |  |  |  |  |  |  | acs711 | ACS711 |  |  |  |  |  | 4 | IP- | input
 |  |  |  |  |  |  |  |  |  |  |  |  | acs711 | ACS711 |  |  |  |  |  | 5 | GND | input
 |  |  |  |  |  |  |  |  |  |  |  |  | acs711 | ACS711 |  |  |  |  |  | 6 | ~FAULT | input
 |  |  |  |  |  |  |  |  |  |  |  |  | acs711 | ACS711 |  |  |  |  |  | 7 | VIout | input
 |  |  |  |  |  |  |  |  |  |  |  |  | acs711 | ACS711 |  |  |  |  |  | 8 | VCC | input
 |  |  |  |  |  |  |  |  |  |  |  |  | conn | CONN_01X02 | Connector, single row, 01x02, pin header |  | Pin_Header_Straight_1X*
 |  |  |  |  |  |  |  |  |  |  |  |  | conn | CONN_01X02 | Connector, single row, 01x02, pin header |  | Pin_Header_Angled_1X*
 |  |  |  |  |  |  |  |  |  |  |  |  | conn | CONN_01X02 | Connector, single row, 01x02, pin header |  | Socket_Strip_Straight_1X*
 |  |  |  |  |  |  |  |  |  |  |  |  | conn | CONN_01X02 | Connector, single row, 01x02, pin header |  | Socket_Strip_Angled_1X*
 |  |  |  |  |  |  |  |  |  |  |  |  | conn | CONN_01X02 | Connector, single row, 01x02, pin header |  |  | J | Reference
 |  |  |  |  |  |  |  |  |  |  |  |  | conn | CONN_01X02 | Connector, single row, 01x02, pin header |  |  | CONN_01X02 | Value
 |  |  |  |  |  |  |  |  |  |  |  |  | conn | CONN_01X02 | Connector, single row, 01x02, pin header |  |  |  |  | 1 | P1 | passive
 |  |  |  |  |  |  |  |  |  |  |  |  | conn | CONN_01X02 | Connector, single row, 01x02, pin header |  |  |  |  | 2 | P2 | passive
 |  |  |  |  |  |  |  |  |  |  |  |  | conn | CONN_01X10 | Connector, single row, 01x10, pin header |  | Pin_Header_Straight_1X*
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
 |  |  |  |  |  |  |  |  |  |  |  |  | isa_bus_connector | ISA_BUS_connector |  |  |  |  |  | 47 | 47 | input
 |  |  |  |  |  |  |  |  |  |  |  |  | isa_bus_connector | ISA_BUS_connector |  |  |  |  |  | 48 | 48 | input
 |  |  |  |  |  |  |  |  |  |  |  |  | isa_bus_connector | ISA_BUS_connector |  |  |  |  |  | 49 | 49 | input
 |  |  |  |  |  |  |  |  |  |  |  |  | isa_bus_connector | ISA_BUS_connector |  |  |  |  |  | 50 | 50 | input
 |  |  |  |  |  |  |  |  |  |  |  |  | isa_bus_connector | ISA_BUS_connector |  |  |  |  |  | 51 | 51 | input
 |  |  |  |  |  |  |  |  |  |  |  |  | isa_bus_connector | ISA_BUS_connector |  |  |  |  |  | 52 | 52 | input
 |  |  |  |  |  |  |  |  |  |  |  |  | isa_bus_connector | ISA_BUS_connector |  |  |  |  |  | 53 | 53 | input
 |  |  |  |  |  |  |  |  |  |  |  |  | isa_bus_connector | ISA_BUS_connector |  |  |  |  |  | 54 | 54 | input
 |  |  |  |  |  |  |  |  |  |  |  |  | isa_bus_connector | ISA_BUS_connector |  |  |  |  |  | 55 | 55 | input
 |  |  |  |  |  |  |  |  |  |  |  |  | isa_bus_connector | ISA_BUS_connector |  |  |  |  |  | 56 | 56 | input
 |  |  |  |  |  |  |  |  |  |  |  |  | isa_bus_connector | ISA_BUS_connector |  |  |  |  |  | 57 | 57 | input
 |  |  |  |  |  |  |  |  |  |  |  |  | isa_bus_connector | ISA_BUS_connector |  |  |  |  |  | 58 | 58 | input
 |  |  |  |  |  |  |  |  |  |  |  |  | isa_bus_connector | ISA_BUS_connector |  |  |  |  |  | 59 | 59 | input
 |  |  |  |  |  |  |  |  |  |  |  |  | isa_bus_connector | ISA_BUS_connector |  |  |  |  |  | 60 | 60 | input
 |  |  |  |  |  |  |  |  |  |  |  |  | isa_bus_connector | ISA_BUS_connector |  |  |  |  |  | 61 | 61 | input
 |  |  |  |  |  |  |  |  |  |  |  |  | isa_bus_connector | ISA_BUS_connector |  |  |  |  |  | 62 | 62 | input
 |  |  |  |  |  |  |  |  |  |  |  |  | isa_bus_connector | ISA_BUS_connector |  |  |  |  |  | 63 | 63 | input
 |  |  |  |  |  |  |  |  |  |  |  |  | isa_bus_connector | ISA_BUS_connector |  |  |  |  |  | 64 | 64 | input
 |  |  |  |  |  |  |  |  |  |  |  |  | mpu-9250 | MPU-9250 | MPU-9250 9DoF IMU from InvenSense |  |  | IC | Reference
 |  |  |  |  |  |  |  |  |  |  |  |  | mpu-9250 | MPU-9250 | MPU-9250 9DoF IMU from InvenSense |  |  | MPU-9250 | Value
 |  |  |  |  |  |  |  |  |  |  |  |  | mpu-9250 | MPU-9250 | MPU-9250 9DoF IMU from InvenSense |  |  | agg:QFN-24-MPU9250 | Footprint
 |  |  |  |  |  |  |  |  |  |  |  |  | mpu-9250 | MPU-9250 | MPU-9250 9DoF IMU from InvenSense |  |  | http://43zrtwysvxb2gf29r5o0athu.wpengine.netdna-cdn.com/wp-content/uploads/2015/02/MPU-9250-Datasheet.pdf | Datasheet
 |  |  |  |  |  |  |  |  |  |  |  |  | mpu-9250 | MPU-9250 | MPU-9250 9DoF IMU from InvenSense |  |  | 883-7942 | RS
 |  |  |  |  |  |  |  |  |  |  |  |  | mpu-9250 | MPU-9250 | MPU-9250 9DoF IMU from InvenSense |  |  | 1428-1019-1-ND | DigiKey
 |  |  |  |  |  |  |  |  |  |  |  |  | mpu-9250 | MPU-9250 | MPU-9250 9DoF IMU from InvenSense |  |  |  |  | 1 | RESV_VDDIO | input
 |  |  |  |  |  |  |  |  |  |  |  |  | mpu-9250 | MPU-9250 | MPU-9250 9DoF IMU from InvenSense |  |  |  |  | 2 | NC | NotConnected
 |  |  |  |  |  |  |  |  |  |  |  |  | mpu-9250 | MPU-9250 | MPU-9250 9DoF IMU from InvenSense |  |  |  |  | 3 | NC | NotConnected
 |  |  |  |  |  |  |  |  |  |  |  |  | mpu-9250 | MPU-9250 | MPU-9250 9DoF IMU from InvenSense |  |  |  |  | 4 | NC | NotConnected
 |  |  |  |  |  |  |  |  |  |  |  |  | mpu-9250 | MPU-9250 | MPU-9250 9DoF IMU from InvenSense |  |  |  |  | 5 | NC | NotConnected
 |  |  |  |  |  |  |  |  |  |  |  |  | mpu-9250 | MPU-9250 | MPU-9250 9DoF IMU from InvenSense |  |  |  |  | 6 | NC | NotConnected
 |  |  |  |  |  |  |  |  |  |  |  |  | mpu-9250 | MPU-9250 | MPU-9250 9DoF IMU from InvenSense |  |  |  |  | 7 | AUX_CL | 3state
 |  |  |  |  |  |  |  |  |  |  |  |  | mpu-9250 | MPU-9250 | MPU-9250 9DoF IMU from InvenSense |  |  |  |  | 8 | VDDIO | power_in
 |  |  |  |  |  |  |  |  |  |  |  |  | mpu-9250 | MPU-9250 | MPU-9250 9DoF IMU from InvenSense |  |  |  |  | 9 | AD0/SD0 | BiDi
 |  |  |  |  |  |  |  |  |  |  |  |  | mpu-9250 | MPU-9250 | MPU-9250 9DoF IMU from InvenSense |  |  |  |  | 10 | REGOUT | passive
 |  |  |  |  |  |  |  |  |  |  |  |  | mpu-9250 | MPU-9250 | MPU-9250 9DoF IMU from InvenSense |  |  |  |  | 11 | FSYNC | input
 |  |  |  |  |  |  |  |  |  |  |  |  | mpu-9250 | MPU-9250 | MPU-9250 9DoF IMU from InvenSense |  |  |  |  | 12 | INT | openCol
 |  |  |  |  |  |  |  |  |  |  |  |  | mpu-9250 | MPU-9250 | MPU-9250 9DoF IMU from InvenSense |  |  |  |  | 13 | VDD | power_in
 |  |  |  |  |  |  |  |  |  |  |  |  | mpu-9250 | MPU-9250 | MPU-9250 9DoF IMU from InvenSense |  |  |  |  | 14 | NC | NotConnected
 |  |  |  |  |  |  |  |  |  |  |  |  | mpu-9250 | MPU-9250 | MPU-9250 9DoF IMU from InvenSense |  |  |  |  | 15 | NC | NotConnected
 |  |  |  |  |  |  |  |  |  |  |  |  | mpu-9250 | MPU-9250 | MPU-9250 9DoF IMU from InvenSense |  |  |  |  | 16 | NC | NotConnected
 |  |  |  |  |  |  |  |  |  |  |  |  | mpu-9250 | MPU-9250 | MPU-9250 9DoF IMU from InvenSense |  |  |  |  | 17 | NC | NotConnected
 |  |  |  |  |  |  |  |  |  |  |  |  | mpu-9250 | MPU-9250 | MPU-9250 9DoF IMU from InvenSense |  |  |  |  | 18 | GND | power_in
 |  |  |  |  |  |  |  |  |  |  |  |  | mpu-9250 | MPU-9250 | MPU-9250 9DoF IMU from InvenSense |  |  |  |  | 19 | RESV_NC | NotConnected
 |  |  |  |  |  |  |  |  |  |  |  |  | mpu-9250 | MPU-9250 | MPU-9250 9DoF IMU from InvenSense |  |  |  |  | 20 | RESV_GND | input
 |  |  |  |  |  |  |  |  |  |  |  |  | mpu-9250 | MPU-9250 | MPU-9250 9DoF IMU from InvenSense |  |  |  |  | 21 | AUX_DA | 3state
 |  |  |  |  |  |  |  |  |  |  |  |  | mpu-9250 | MPU-9250 | MPU-9250 9DoF IMU from InvenSense |  |  |  |  | 22 | ~CS | input
 |  |  |  |  |  |  |  |  |  |  |  |  | mpu-9250 | MPU-9250 | MPU-9250 9DoF IMU from InvenSense |  |  |  |  | 23 | SCL/SCLK | input
 |  |  |  |  |  |  |  |  |  |  |  |  | mpu-9250 | MPU-9250 | MPU-9250 9DoF IMU from InvenSense |  |  |  |  | 24 | SDA/SDI | input
 |  |  |  |  |  |  |  |  |  |  |  |  | pcb_v1-rescue | MCP9700T-E_LT |  |  |  | U | Reference
 |  |  |  |  |  |  |  |  |  |  |  |  | pcb_v1-rescue | MCP9700T-E_LT |  |  |  | MCP9700T-E_LT | Value
 |  |  |  |  |  |  |  |  |  |  |  |  | pcb_v1-rescue | MCP9700T-E_LT |  |  |  |  |  | 1 | VCC | input
 |  |  |  |  |  |  |  |  |  |  |  |  | pcb_v1-rescue | MCP9700T-E_LT |  |  |  |  |  | 2 | VOUT | input
 |  |  |  |  |  |  |  |  |  |  |  |  | pcb_v1-rescue | MCP9700T-E_LT |  |  |  |  |  | 3 | GND | input
 |  |  |  |  |  |  |  |  |  |  |  |  | pcb_v1-rescue | MSP432P4111-RESCUE-pcb_v1 |  |  |  | U | Reference
 |  |  |  |  |  |  |  |  |  |  |  |  | pcb_v1-rescue | MSP432P4111-RESCUE-pcb_v1 |  |  |  | MSP432P4111-RESCUE-pcb_v1 | Value
 |  |  |  |  |  |  |  |  |  |  |  |  | pcb_v1-rescue | MSP432P4111-RESCUE-pcb_v1 |  |  |  |  |  | 1 | P10.1/UCB3CLK/L38 | input
 |  |  |  |  |  |  |  |  |  |  |  |  | pcb_v1-rescue | MSP432P4111-RESCUE-pcb_v1 |  |  |  |  |  | 2 | P10.2/UCB3SIMO/UCB3SDA/L37 | input
 |  |  |  |  |  |  |  |  |  |  |  |  | pcb_v1-rescue | MSP432P4111-RESCUE-pcb_v1 |  |  |  |  |  | 3 | P10.3/UCB3SOMI/UCB3SCL/L36 | input
 |  |  |  |  |  |  |  |  |  |  |  |  | pcb_v1-rescue | MSP432P4111-RESCUE-pcb_v1 |  |  |  |  |  | 4 | P1.0/UCA0STE/L19 | input
 |  |  |  |  |  |  |  |  |  |  |  |  | pcb_v1-rescue | MSP432P4111-RESCUE-pcb_v1 |  |  |  |  |  | 5 | P1.1/UCA0CLK/L18 | input
 |  |  |  |  |  |  |  |  |  |  |  |  | pcb_v1-rescue | MSP432P4111-RESCUE-pcb_v1 |  |  |  |  |  | 6 | P1.2/UCA0RXD/UCA0SOMI/L17 | input
 |  |  |  |  |  |  |  |  |  |  |  |  | pcb_v1-rescue | MSP432P4111-RESCUE-pcb_v1 |  |  |  |  |  | 7 | P1.3/UCA0TXD/UCA0SIMO/L16 | input
 |  |  |  |  |  |  |  |  |  |  |  |  | pcb_v1-rescue | MSP432P4111-RESCUE-pcb_v1 |  |  |  |  |  | 8 | P1.4/UCB0STE/L15 | input
 |  |  |  |  |  |  |  |  |  |  |  |  | pcb_v1-rescue | MSP432P4111-RESCUE-pcb_v1 |  |  |  |  |  | 9 | P1.5/UCB0CLK/L14 | input
 |  |  |  |  |  |  |  |  |  |  |  |  | pcb_v1-rescue | MSP432P4111-RESCUE-pcb_v1 |  |  |  |  |  | 10 | P1.6/UCB0SIMO/UCB0SDA/L13 | input
 |  |  |  |  |  |  |  |  |  |  |  |  | pcb_v1-rescue | MSP432P4111-RESCUE-pcb_v1 |  |  |  |  |  | 11 | P1.7/UCB0SOMI/UCB0SCL/L12 | input
 |  |  |  |  |  |  |  |  |  |  |  |  | pcb_v1-rescue | MSP432P4111-RESCUE-pcb_v1 |  |  |  |  |  | 12 | VCORE | input
 |  |  |  |  |  |  |  |  |  |  |  |  | pcb_v1-rescue | MSP432P4111-RESCUE-pcb_v1 |  |  |  |  |  | 13 | DVCC1 | input
 |  |  |  |  |  |  |  |  |  |  |  |  | pcb_v1-rescue | MSP432P4111-RESCUE-pcb_v1 |  |  |  |  |  | 14 | VSW | input
 |  |  |  |  |  |  |  |  |  |  |  |  | pcb_v1-rescue | MSP432P4111-RESCUE-pcb_v1 |  |  |  |  |  | 15 | DVSS1 | input
 |  |  |  |  |  |  |  |  |  |  |  |  | pcb_v1-rescue | MSP432P4111-RESCUE-pcb_v1 |  |  |  |  |  | 16 | P2.0/PM_UCA1STE/L11 | input
 |  |  |  |  |  |  |  |  |  |  |  |  | pcb_v1-rescue | MSP432P4111-RESCUE-pcb_v1 |  |  |  |  |  | 17 | P2.1/PM_UCA1CLK/L10_ | input
 |  |  |  |  |  |  |  |  |  |  |  |  | pcb_v1-rescue | MSP432P4111-RESCUE-pcb_v1 |  |  |  |  |  | 18 | P2.2/PM_UCA1RXD/PM_UCA1SOMI/L9 | input
 |  |  |  |  |  |  |  |  |  |  |  |  | pcb_v1-rescue | MSP432P4111-RESCUE-pcb_v1 |  |  |  |  |  | 19 | P2.3/PM_UCA1TXD/PM_UCA1SIMO/L8 | input
 |  |  |  |  |  |  |  |  |  |  |  |  | pcb_v1-rescue | MSP432P4111-RESCUE-pcb_v1 |  |  |  |  |  | 20 | P2.4/PM_TA0.1/L23 | input
 |  |  |  |  |  |  |  |  |  |  |  |  | pcb_v1-rescue | MSP432P4111-RESCUE-pcb_v1 |  |  |  |  |  | 21 | P2.5/PM_TA0.2/L22 | input
 |  |  |  |  |  |  |  |  |  |  |  |  | pcb_v1-rescue | MSP432P4111-RESCUE-pcb_v1 |  |  |  |  |  | 22 | P2.6/PM_TA0.3/L21 | input
 |  |  |  |  |  |  |  |  |  |  |  |  | pcb_v1-rescue | MSP432P4111-RESCUE-pcb_v1 |  |  |  |  |  | 23 | P2.7/PM_TA0.4/L20 | input
 |  |  |  |  |  |  |  |  |  |  |  |  | pcb_v1-rescue | MSP432P4111-RESCUE-pcb_v1 |  |  |  |  |  | 24 | P10.4/TA3.0/C0.7/L35 | input
 |  |  |  |  |  |  |  |  |  |  |  |  | pcb_v1-rescue | MSP432P4111-RESCUE-pcb_v1 |  |  |  |  |  | 25 | P10.5/TA3.1/C0.6/L34 | input
 |  |  |  |  |  |  |  |  |  |  |  |  | pcb_v1-rescue | MSP432P4111-RESCUE-pcb_v1 |  |  |  |  |  | 26 | P7.4/PM_TA1.4/C0.5/L31 | input
 |  |  |  |  |  |  |  |  |  |  |  |  | pcb_v1-rescue | MSP432P4111-RESCUE-pcb_v1 |  |  |  |  |  | 27 | P7.5/PM_TA1.3/C0.4/L30 | input
 |  |  |  |  |  |  |  |  |  |  |  |  | pcb_v1-rescue | MSP432P4111-RESCUE-pcb_v1 |  |  |  |  |  | 28 | P7.6/PM_TA1.2/C0.3/L29 | input
 |  |  |  |  |  |  |  |  |  |  |  |  | pcb_v1-rescue | MSP432P4111-RESCUE-pcb_v1 |  |  |  |  |  | 29 | P7.7/PM_TA1.1/C0.2/L28 | input
 |  |  |  |  |  |  |  |  |  |  |  |  | pcb_v1-rescue | MSP432P4111-RESCUE-pcb_v1 |  |  |  |  |  | 30 | P8.0/UCB3STE/TA1.0/C0.1 | input
 |  |  |  |  |  |  |  |  |  |  |  |  | pcb_v1-rescue | MSP432P4111-RESCUE-pcb_v1 |  |  |  |  |  | 31 | P8.1/UCB3CLK/TA2.0/C0.0 | input
 |  |  |  |  |  |  |  |  |  |  |  |  | pcb_v1-rescue | MSP432P4111-RESCUE-pcb_v1 |  |  |  |  |  | 32 | P3.0/PM_UCA2STE/L7 | input
 |  |  |  |  |  |  |  |  |  |  |  |  | pcb_v1-rescue | MSP432P4111-RESCUE-pcb_v1 |  |  |  |  |  | 33 | P3.1/PM_UCA2CLK/L6 | input
 |  |  |  |  |  |  |  |  |  |  |  |  | pcb_v1-rescue | MSP432P4111-RESCUE-pcb_v1 |  |  |  |  |  | 34 | P3.2/PM_UCA2RXD/PM_UCA2SOMI/L5 | input
 |  |  |  |  |  |  |  |  |  |  |  |  | pcb_v1-rescue | MSP432P4111-RESCUE-pcb_v1 |  |  |  |  |  | 35 | P3.3/PM_UCA2TXD/PM_UCA2SIMO/L4 | input
 |  |  |  |  |  |  |  |  |  |  |  |  | pcb_v1-rescue | MSP432P4111-RESCUE-pcb_v1 |  |  |  |  |  | 36 | P3.4/PM_UCB2STE/L3 | input
 |  |  |  |  |  |  |  |  |  |  |  |  | pcb_v1-rescue | MSP432P4111-RESCUE-pcb_v1 |  |  |  |  |  | 37 | P3.5/PM_UCB2CLK/L2 | input
 |  |  |  |  |  |  |  |  |  |  |  |  | pcb_v1-rescue | MSP432P4111-RESCUE-pcb_v1 |  |  |  |  |  | 38 | P3.6/PM_UCB2SIMO/PM_UCB2SDA/L1 | input
 |  |  |  |  |  |  |  |  |  |  |  |  | pcb_v1-rescue | MSP432P4111-RESCUE-pcb_v1 |  |  |  |  |  | 39 | P3.7/PM_UCB2SOMI/PM_UCB2SCL/L0 | input
 |  |  |  |  |  |  |  |  |  |  |  |  | pcb_v1-rescue | MSP432P4111-RESCUE-pcb_v1 |  |  |  |  |  | 40 | AVSS3 | input
 |  |  |  |  |  |  |  |  |  |  |  |  | pcb_v1-rescue | MSP432P4111-RESCUE-pcb_v1 |  |  |  |  |  | 41 | PJ.0/LFXIN | input
 |  |  |  |  |  |  |  |  |  |  |  |  | pcb_v1-rescue | MSP432P4111-RESCUE-pcb_v1 |  |  |  |  |  | 42 | PJ.1/LFXOUT | input
 |  |  |  |  |  |  |  |  |  |  |  |  | pcb_v1-rescue | MSP432P4111-RESCUE-pcb_v1 |  |  |  |  |  | 43 | AVSS1 | input
 |  |  |  |  |  |  |  |  |  |  |  |  | pcb_v1-rescue | MSP432P4111-RESCUE-pcb_v1 |  |  |  |  |  | 44 | DCOR | input
 |  |  |  |  |  |  |  |  |  |  |  |  | pcb_v1-rescue | MSP432P4111-RESCUE-pcb_v1 |  |  |  |  |  | 45 | AVCC1 | input
 |  |  |  |  |  |  |  |  |  |  |  |  | pcb_v1-rescue | MSP432P4111-RESCUE-pcb_v1 |  |  |  |  |  | 46 | P8.2/TA3.2/A23/L47 | input
 |  |  |  |  |  |  |  |  |  |  |  |  | pcb_v1-rescue | MSP432P4111-RESCUE-pcb_v1 |  |  |  |  |  | 47 | P8.3/TA3CLK/A22/L46 | input
 |  |  |  |  |  |  |  |  |  |  |  |  | pcb_v1-rescue | MSP432P4111-RESCUE-pcb_v1 |  |  |  |  |  | 48 | P8.4/A21/L45 | input
 |  |  |  |  |  |  |  |  |  |  |  |  | pcb_v1-rescue | MSP432P4111-RESCUE-pcb_v1 |  |  |  |  |  | 49 | P8.5/A20/L44 | input
 |  |  |  |  |  |  |  |  |  |  |  |  | pcb_v1-rescue | MSP432P4111-RESCUE-pcb_v1 |  |  |  |  |  | 50 | P8.6/A19/L19 | input
 |  |  |  |  |  |  |  |  |  |  |  |  | pcb_v1-rescue | MSP432P4111-RESCUE-pcb_v1 |  |  |  |  |  | 51 | P8.7/A18/L18 | input
 |  |  |  |  |  |  |  |  |  |  |  |  | pcb_v1-rescue | MSP432P4111-RESCUE-pcb_v1 |  |  |  |  |  | 52 | P9.0/A17/L17 | input
 |  |  |  |  |  |  |  |  |  |  |  |  | pcb_v1-rescue | MSP432P4111-RESCUE-pcb_v1 |  |  |  |  |  | 53 | P9.1/A16/L16 | input
 |  |  |  |  |  |  |  |  |  |  |  |  | pcb_v1-rescue | MSP432P4111-RESCUE-pcb_v1 |  |  |  |  |  | 54 | P6.0/A15/L15 | input
 |  |  |  |  |  |  |  |  |  |  |  |  | pcb_v1-rescue | MSP432P4111-RESCUE-pcb_v1 |  |  |  |  |  | 55 | P6.1/A14/L14 | input
 |  |  |  |  |  |  |  |  |  |  |  |  | pcb_v1-rescue | MSP432P4111-RESCUE-pcb_v1 |  |  |  |  |  | 56 | P4.0/A13/L13 | input
 |  |  |  |  |  |  |  |  |  |  |  |  | pcb_v1-rescue | MSP432P4111-RESCUE-pcb_v1 |  |  |  |  |  | 57 | P4.1/A12/L12 | input
 |  |  |  |  |  |  |  |  |  |  |  |  | pcb_v1-rescue | MSP432P4111-RESCUE-pcb_v1 |  |  |  |  |  | 58 | P4.2/ACLK/TA2CLK/A11 | input
 |  |  |  |  |  |  |  |  |  |  |  |  | pcb_v1-rescue | MSP432P4111-RESCUE-pcb_v1 |  |  |  |  |  | 59 | P4.3/MCLK/RTCCLK/A10 | input
 |  |  |  |  |  |  |  |  |  |  |  |  | pcb_v1-rescue | MSP432P4111-RESCUE-pcb_v1 |  |  |  |  |  | 60 | P4.4/HSMCLK/SVMHOUT/A9 | input
 |  |  |  |  |  |  |  |  |  |  |  |  | pcb_v1-rescue | MSP432P4111-RESCUE-pcb_v1 |  |  |  |  |  | 61 | P4.5/A8 | input
 |  |  |  |  |  |  |  |  |  |  |  |  | pcb_v1-rescue | MSP432P4111-RESCUE-pcb_v1 |  |  |  |  |  | 62 | _P4.6/A7 | input
 |  |  |  |  |  |  |  |  |  |  |  |  | pcb_v1-rescue | MSP432P4111-RESCUE-pcb_v1 |  |  |  |  |  | 63 | P4.7/A6 | input
 |  |  |  |  |  |  |  |  |  |  |  |  | pcb_v1-rescue | MSP432P4111-RESCUE-pcb_v1 |  |  |  |  |  | 64 | P5.0/A5 | input
 |  |  |  |  |  |  |  |  |  |  |  |  | pcb_v1-rescue | MSP432P4111-RESCUE-pcb_v1 |  |  |  |  |  | 65 | P5.1/A4 | input
 |  |  |  |  |  |  |  |  |  |  |  |  | pcb_v1-rescue | MSP432P4111-RESCUE-pcb_v1 |  |  |  |  |  | 66 | _P5.2/A3 | input
 |  |  |  |  |  |  |  |  |  |  |  |  | pcb_v1-rescue | MSP432P4111-RESCUE-pcb_v1 |  |  |  |  |  | 67 | P5.3/A2 | input
 |  |  |  |  |  |  |  |  |  |  |  |  | pcb_v1-rescue | MSP432P4111-RESCUE-pcb_v1 |  |  |  |  |  | 68 | P5.4/A1 | input
 |  |  |  |  |  |  |  |  |  |  |  |  | pcb_v1-rescue | MSP432P4111-RESCUE-pcb_v1 |  |  |  |  |  | 69 | P5.5/A0 | input
 |  |  |  |  |  |  |  |  |  |  |  |  | pcb_v1-rescue | MSP432P4111-RESCUE-pcb_v1 |  |  |  |  |  | 70 | P5.6/TA2.1/VREF+/VeREF+/C1.7 | input
 |  |  |  |  |  |  |  |  |  |  |  |  | pcb_v1-rescue | MSP432P4111-RESCUE-pcb_v1 |  |  |  |  |  | 71 | P5.7/TA2.2/VREF-/VeREF-/C1.6 | input
 |  |  |  |  |  |  |  |  |  |  |  |  | pcb_v1-rescue | MSP432P4111-RESCUE-pcb_v1 |  |  |  |  |  | 72 | DVSS2 | input
 |  |  |  |  |  |  |  |  |  |  |  |  | pcb_v1-rescue | MSP432P4111-RESCUE-pcb_v1 |  |  |  |  |  | 73 | DVCC2 | input
 |  |  |  |  |  |  |  |  |  |  |  |  | pcb_v1-rescue | MSP432P4111-RESCUE-pcb_v1 |  |  |  |  |  | 74 | P9.2/TA3.3/L33 | input
 |  |  |  |  |  |  |  |  |  |  |  |  | pcb_v1-rescue | MSP432P4111-RESCUE-pcb_v1 |  |  |  |  |  | 75 | P9.3/TA3.4/L32 | input
 |  |  |  |  |  |  |  |  |  |  |  |  | pcb_v1-rescue | MSP432P4111-RESCUE-pcb_v1 |  |  |  |  |  | 76 | P6.2/UCB1STE/C1.5/L27 | input
 |  |  |  |  |  |  |  |  |  |  |  |  | pcb_v1-rescue | MSP432P4111-RESCUE-pcb_v1 |  |  |  |  |  | 77 | P6.3/UCB1CLK/C1.4/L26 | input
 |  |  |  |  |  |  |  |  |  |  |  |  | pcb_v1-rescue | MSP432P4111-RESCUE-pcb_v1 |  |  |  |  |  | 78 | P6.4/UCB1SIMO/UCB1SDA/C1.3/L25 | input
 |  |  |  |  |  |  |  |  |  |  |  |  | pcb_v1-rescue | MSP432P4111-RESCUE-pcb_v1 |  |  |  |  |  | 79 | P6.5/UCB1SOMI/UCB1SCL/C1.2/L24 | input
 |  |  |  |  |  |  |  |  |  |  |  |  | pcb_v1-rescue | MSP432P4111-RESCUE-pcb_v1 |  |  |  |  |  | 80 | P6.6/TA2.3/UCB3SIMO/UCB3SDA/C1.1 | input
 |  |  |  |  |  |  |  |  |  |  |  |  | pcb_v1-rescue | MSP432P4111-RESCUE-pcb_v1 |  |  |  |  |  | 81 | P6.7/TA2.4/UCB3SOMI/UCB3SCL/C1.0 | input
 |  |  |  |  |  |  |  |  |  |  |  |  | pcb_v1-rescue | MSP432P4111-RESCUE-pcb_v1 |  |  |  |  |  | 82 | DVSS3 | input
 |  |  |  |  |  |  |  |  |  |  |  |  | pcb_v1-rescue | MSP432P4111-RESCUE-pcb_v1 |  |  |  |  |  | 83 | RSTn/NM | input
 |  |  |  |  |  |  |  |  |  |  |  |  | pcb_v1-rescue | MSP432P4111-RESCUE-pcb_v1 |  |  |  |  |  | 84 | AVSS2 | input
 |  |  |  |  |  |  |  |  |  |  |  |  | pcb_v1-rescue | MSP432P4111-RESCUE-pcb_v1 |  |  |  |  |  | 85 | PJ.2/HFXOUT | input
 |  |  |  |  |  |  |  |  |  |  |  |  | pcb_v1-rescue | MSP432P4111-RESCUE-pcb_v1 |  |  |  |  |  | 86 | PJ.3/HFXIN | input
 |  |  |  |  |  |  |  |  |  |  |  |  | pcb_v1-rescue | MSP432P4111-RESCUE-pcb_v1 |  |  |  |  |  | 87 | AVCC2 | input
 |  |  |  |  |  |  |  |  |  |  |  |  | pcb_v1-rescue | MSP432P4111-RESCUE-pcb_v1 |  |  |  |  |  | 88 | P7.0/PM_SMCLK/PM_DMAE0/R03 | input
 |  |  |  |  |  |  |  |  |  |  |  |  | pcb_v1-rescue | MSP432P4111-RESCUE-pcb_v1 |  |  |  |  |  | 89 | P7.1/PM_C0OUT/PM_TA0CLK/R13 | input
 |  |  |  |  |  |  |  |  |  |  |  |  | pcb_v1-rescue | MSP432P4111-RESCUE-pcb_v1 |  |  |  |  |  | 90 | P7.2/PM_C1OUT/PM_TA1CLK/R23 | input
 |  |  |  |  |  |  |  |  |  |  |  |  | pcb_v1-rescue | MSP432P4111-RESCUE-pcb_v1 |  |  |  |  |  | 91 | P7.3/PM_TA0.0 | input
 |  |  |  |  |  |  |  |  |  |  |  |  | pcb_v1-rescue | MSP432P4111-RESCUE-pcb_v1 |  |  |  |  |  | 92 | PJ.4/TDI | input
 |  |  |  |  |  |  |  |  |  |  |  |  | pcb_v1-rescue | MSP432P4111-RESCUE-pcb_v1 |  |  |  |  |  | 93 | PJ.5/TDO/SWO | input
 |  |  |  |  |  |  |  |  |  |  |  |  | pcb_v1-rescue | MSP432P4111-RESCUE-pcb_v1 |  |  |  |  |  | 94 | SWDIOTMS | input
 |  |  |  |  |  |  |  |  |  |  |  |  | pcb_v1-rescue | MSP432P4111-RESCUE-pcb_v1 |  |  |  |  |  | 95 | SWCLKTCK | input
 |  |  |  |  |  |  |  |  |  |  |  |  | pcb_v1-rescue | MSP432P4111-RESCUE-pcb_v1 |  |  |  |  |  | 96 | P9.4/UCA3STE/L43 | input
 |  |  |  |  |  |  |  |  |  |  |  |  | pcb_v1-rescue | MSP432P4111-RESCUE-pcb_v1 |  |  |  |  |  | 97 | P9.5/UCA3CLK/L42 | input
 |  |  |  |  |  |  |  |  |  |  |  |  | pcb_v1-rescue | MSP432P4111-RESCUE-pcb_v1 |  |  |  |  |  | 98 | P9.6/UCA3RXD/UCA3SOMI/L41 | input
 |  |  |  |  |  |  |  |  |  |  |  |  | pcb_v1-rescue | MSP432P4111-RESCUE-pcb_v1 |  |  |  |  |  | 99 | P9.7/UCA3TXD/UCA3SIMO/L40 | input
 |  |  |  |  |  |  |  |  |  |  |  |  | pcb_v1-rescue | MSP432P4111-RESCUE-pcb_v1 |  |  |  |  |  | 100 | P10.0/UCB3STE/L39 | input
 |  |  |  |  |  |  |  |  |  |  |  |  | regul | LM317_SOT223 | Linear Regulator (adjustable) | regulator/lm117.pdf |  | U | Reference
 |  |  |  |  |  |  |  |  |  |  |  |  | regul | LM317_SOT223 | Linear Regulator (adjustable) | regulator/lm117.pdf |  | LM317_SOT223 | Value
 |  |  |  |  |  |  |  |  |  |  |  |  | regul | LM317_SOT223 | Linear Regulator (adjustable) | regulator/lm117.pdf |  |  |  | 1 | ADJ | input
 |  |  |  |  |  |  |  |  |  |  |  |  | regul | LM317_SOT223 | Linear Regulator (adjustable) | regulator/lm117.pdf |  |  |  | 2 | OUT | power_out
 |  |  |  |  |  |  |  |  |  |  |  |  | regul | LM317_SOT223 | Linear Regulator (adjustable) | regulator/lm117.pdf |  |  |  | 3 | IN | input
 |  |  |  |  |  |  |  |  |  |  |  |  | st1w008s4er | ST1W008S4ER |  |  |  | U | Reference
 |  |  |  |  |  |  |  |  |  |  |  |  | st1w008s4er | ST1W008S4ER |  |  |  | ST1W008S4ER | Value
 |  |  |  |  |  |  |  |  |  |  |  |  | st1w008s4er | ST1W008S4ER |  |  |  |  |  | 1 | DAT2 | input
 |  |  |  |  |  |  |  |  |  |  |  |  | st1w008s4er | ST1W008S4ER |  |  |  |  |  | 2 | CD/DAT3 | input
 |  |  |  |  |  |  |  |  |  |  |  |  | st1w008s4er | ST1W008S4ER |  |  |  |  |  | 3 | CMD | input
 |  |  |  |  |  |  |  |  |  |  |  |  | st1w008s4er | ST1W008S4ER |  |  |  |  |  | 4 | VDD | input
 |  |  |  |  |  |  |  |  |  |  |  |  | st1w008s4er | ST1W008S4ER |  |  |  |  |  | 5 | CLK | input
 |  |  |  |  |  |  |  |  |  |  |  |  | st1w008s4er | ST1W008S4ER |  |  |  |  |  | 6 | VSS | input
 |  |  |  |  |  |  |  |  |  |  |  |  | st1w008s4er | ST1W008S4ER |  |  |  |  |  | 7 | DAT1 | input
 |  |  |  |  |  |  |  |  |  |  |  |  | st1w008s4er | ST1W008S4ER |  |  |  |  |  | 8 | DAT0 | input
 |  |  |  |  |  |  |  |  |  |  |  |  | st1w008s4er | ST1W008S4ER |  |  |  |  |  | 9 | GND1 | input
 |  |  |  |  |  |  |  |  |  |  |  |  | st1w008s4er | ST1W008S4ER |  |  |  |  |  | 10 | GND2 | input
 |  |  |  |  |  |  |  |  |  |  |  |  | st1w008s4er | ST1W008S4ER |  |  |  |  |  | 11 | GND3 | input
 |  |  |  |  |  |  |  |  |  |  |  |  | st1w008s4er | ST1W008S4ER |  |  |  |  |  | 12 | GND4 | input
 |  |  |  |  |  |  |  |  |  |  |  |  | stwd100 | STWD100 |  |  |  | U | Reference
 |  |  |  |  |  |  |  |  |  |  |  |  | stwd100 | STWD100 |  |  |  | STWD100 | Value
 |  |  |  |  |  |  |  |  |  |  |  |  | stwd100 | STWD100 |  |  |  |  |  | 1 | ~WDO~ | input
 |  |  |  |  |  |  |  |  |  |  |  |  | stwd100 | STWD100 |  |  |  |  |  | 2 | GND | input
 |  |  |  |  |  |  |  |  |  |  |  |  | stwd100 | STWD100 |  |  |  |  |  | 3 | ~EN~ | input
 |  |  |  |  |  |  |  |  |  |  |  |  | stwd100 | STWD100 |  |  |  |  |  | 4 | WDI | input
 |  |  |  |  |  |  |  |  |  |  |  |  | stwd100 | STWD100 |  |  |  |  |  | 5 | VCC | input
 |  |  |  |  |  |  |  |  |  |  |  |  |  |  |  |  |  |  |  |  |  |  | Device | C:\Program Files\KiCad\share\kicad\library/Device.lib
 |  |  |  |  |  |  |  |  |  |  |  |  |  |  |  |  |  |  |  |  |  |  | FM25V05 | C:\Users\Guilherme\Documents\MEGA\UNB\TCC\tcc\pcb/FM25V05.lib
 |  |  |  |  |  |  |  |  |  |  |  |  |  |  |  |  |  |  |  |  |  |  | acs711 | C:\Users\Guilherme\Documents\MEGA\UNB\TCC\tcc\pcb/acs711.lib
 |  |  |  |  |  |  |  |  |  |  |  |  |  |  |  |  |  |  |  |  |  |  | conn | C:\Program Files\KiCad\share\kicad\library/conn.lib
 |  |  |  |  |  |  |  |  |  |  |  |  |  |  |  |  |  |  |  |  |  |  | isa_bus_connector | C:\Users\Guilherme\Documents\MEGA\UNB\TCC\tcc\pcb/isa_bus_connector.lib
 |  |  |  |  |  |  |  |  |  |  |  |  |  |  |  |  |  |  |  |  |  |  | mpu-9250 | C:\Users\Guilherme\Documents\MEGA\UNB\TCC\tcc\pcb/mpu-9250.lib
 |  |  |  |  |  |  |  |  |  |  |  |  |  |  |  |  |  |  |  |  |  |  | pcb_v1-rescue | C:\Users\Guilherme\Documents\MEGA\UNB\TCC\tcc\pcb/pcb_v1-rescue.lib
 |  |  |  |  |  |  |  |  |  |  |  |  |  |  |  |  |  |  |  |  |  |  | regul | C:\Program Files\KiCad\share\kicad\library/regul.lib
 |  |  |  |  |  |  |  |  |  |  |  |  |  |  |  |  |  |  |  |  |  |  | st1w008s4er | C:\Users\Guilherme\Documents\MEGA\UNB\TCC\tcc\pcb/st1w008s4er.lib
 |  |  |  |  |  |  |  |  |  |  |  |  |  |  |  |  |  |  |  |  |  |  | stwd100 | C:\Users\Guilherme\Documents\MEGA\UNB\TCC\tcc\pcb/stwd100.lib
