guilhermelionzo/tcc_files/imagens/check_out_BOM.PNG

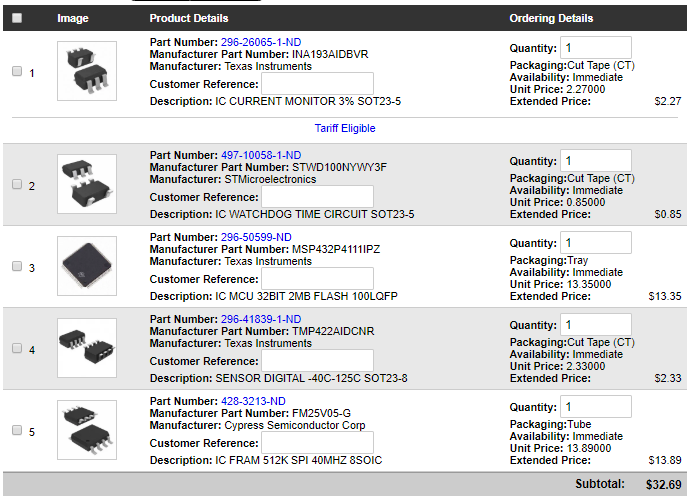
imagens/check_out_BOM.PNG
