guilhermelionzo/tcc_files/pcb/pcb_v1.step

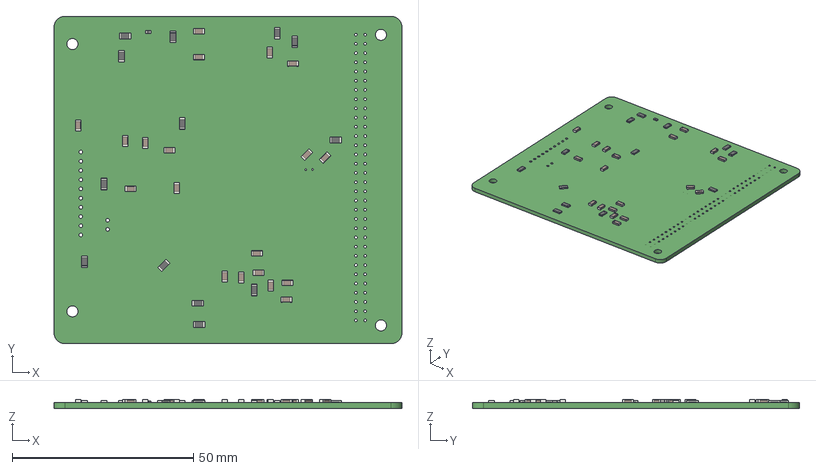
[picture p152: CAD file, 2019-12-02]
pcb/pcb_v1.step
95.9 x 90.2 x 2.43 mm
AB2_LQFP100
SOIC-8-N x 2
L_1206
SOT-223
SOT-23-5
Pin_Header_Straight_1x10_Pitch2.54mm
Pin_Header_Straight_1x02_Pitch2.54mm
SOT-23
SD_Card
QFN-24-1EP_3x4mm_Pitch0.4mm
