guilhermelionzo/tcc_files/(list of files, cad)

Other CAD files:
pcb/pcb_v1.wrl.sldprt
