guilhermelionzo/tcc_files/imagens/print_debug_MSP432.PNG

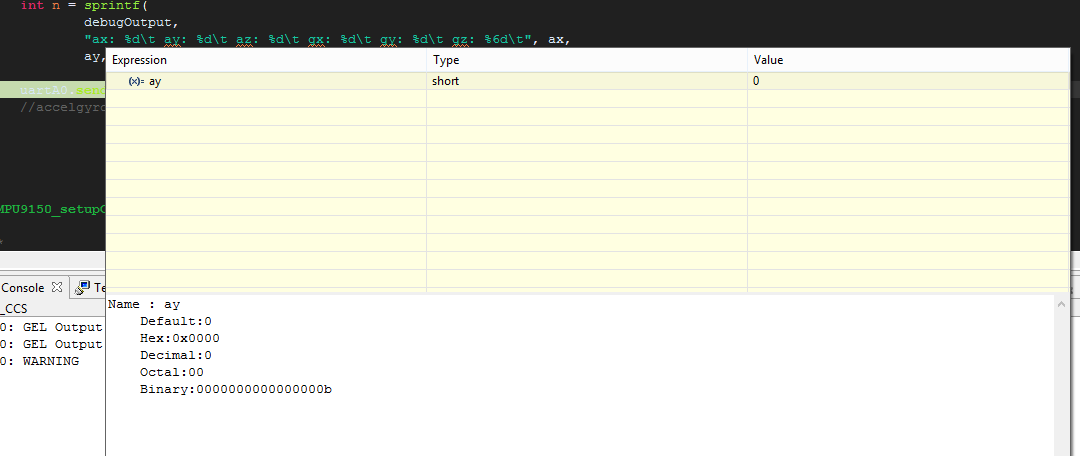
imagens/print_debug_MSP432.PNG
