guilhermelionzo/tcc_files/imagens/print_energiaMonitor.PNG

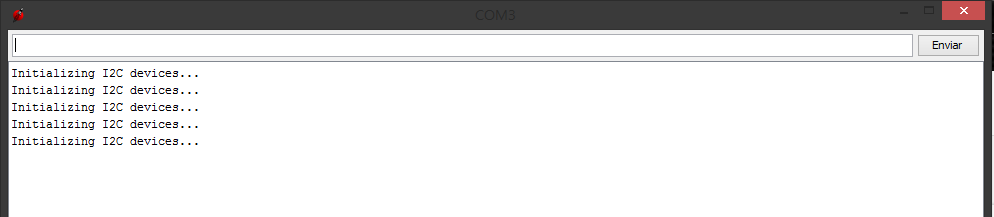
imagens/print_energiaMonitor.PNG
