guilhermelionzo/tcc_files/documents/Problemas.docx

1. O que? (Problema)
2. Porque? (Justificativa)
3. O que quer? (Objetivo)
4. Como? (Metodologia)
5. Quando? (Cronograma)
6. Com o que? & Quanto? (Recursos)
