guilhermelionzo/tcc_files/imagens/print_compileProblems.PNG

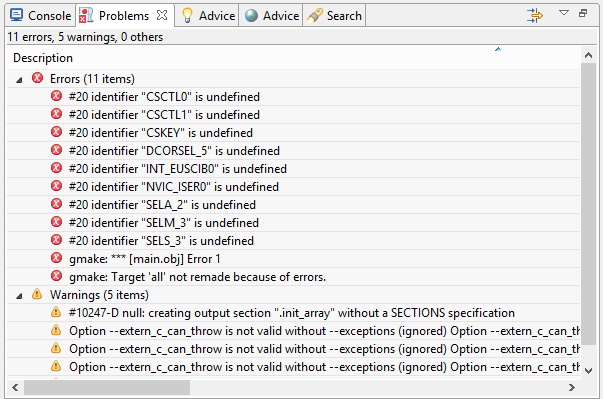
imagens/print_compileProblems.PNG
