guilhermelionzo/tcc_files/Topologia_Hardware.pdf

## EPS

## TT&C

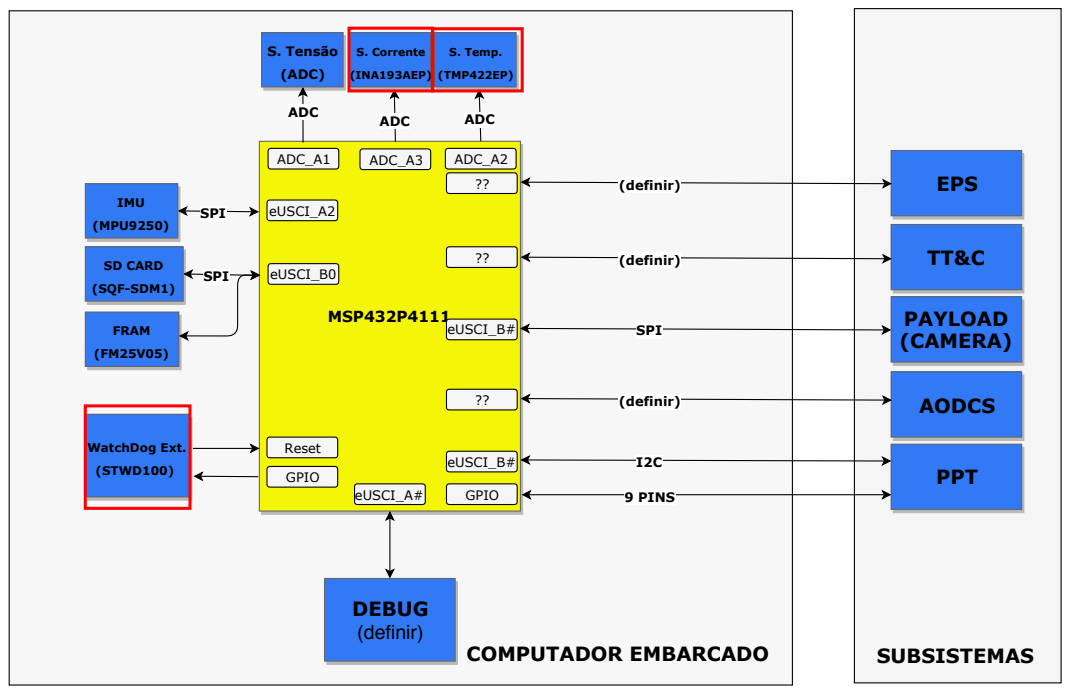
[picture p156: page 1]
MSP432P4111; COMPUTADOR EMBARCADO; AODCS; PAYLOAD (CAMERA); PPT; SUBSISTEMAS; eUSCI_B#; GPIO; 9 PINS; SPI; eUSCI_A2; WatchDog Ext.; (STWD100); Reset; DEBUG (definir); eUSCI_A#; ADC; ADC_A1; ADC_A2; (definir); S. Tensão (ADC); S. Temp.; (TMP422EP); ADC_A3; S. Corrente; (INA193AEP); IMU; (MPU9250); eUSCI_B0 SD CARD; (SQF-SDM1); FRAM
