guilhermelionzo/tcc_files/latex/figuras/flowChart_clockSetup.pdf

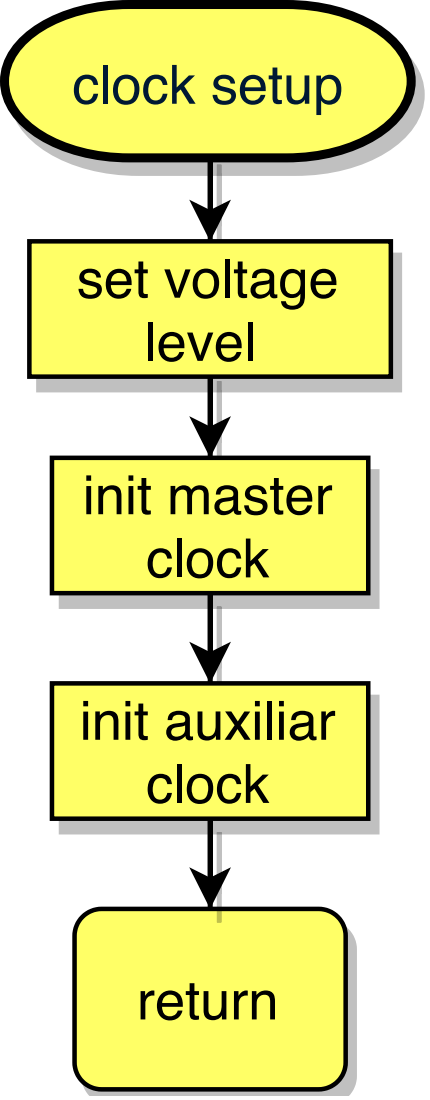
[picture p157: page 1]
clock setup; set voltage level; init master clock; return; init auxiliar clock
