guilhermelionzo/tcc_files/latex/pcb_v1.pdf

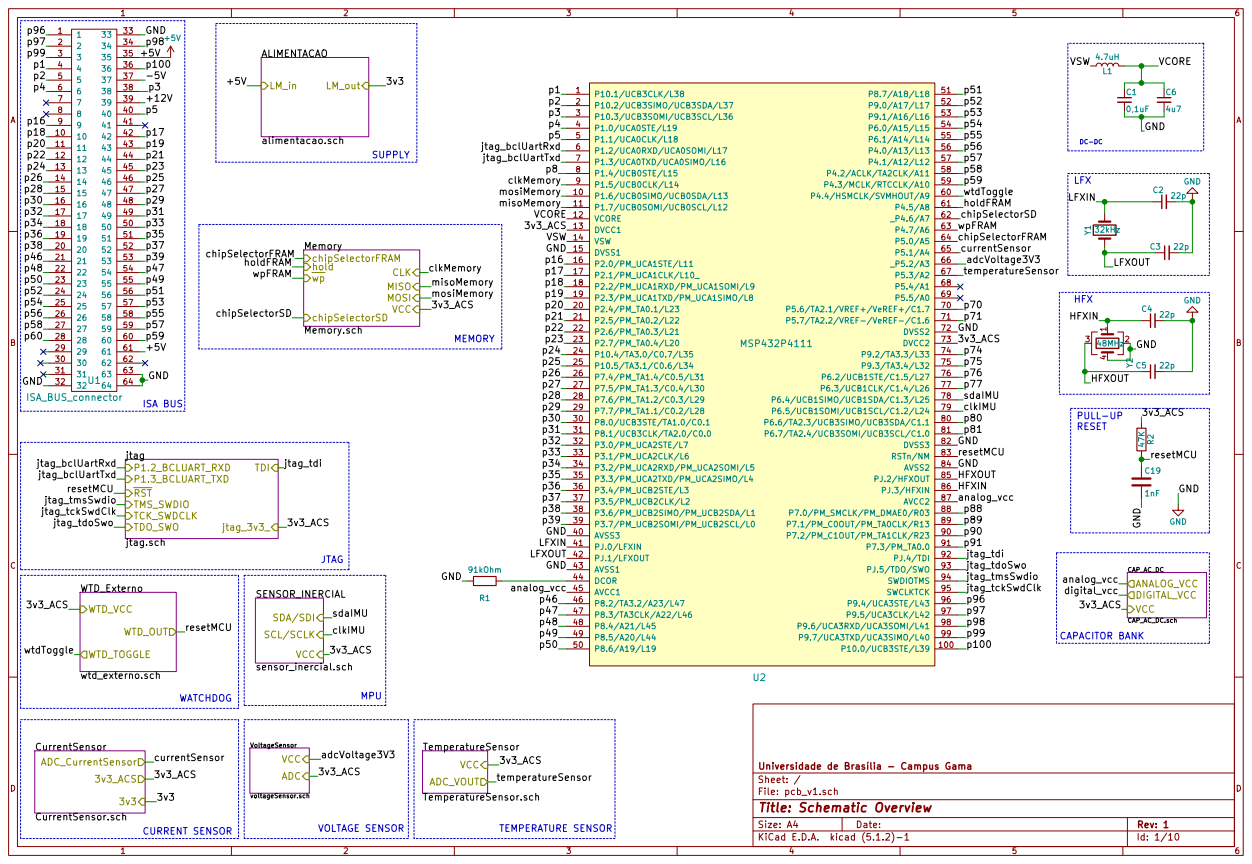
[picture p158: page 1]

File: pcb_v1.sch Sheet: / Universidade de Brasília - Campus Gama R1

VoltageSensor voltageSensor.sch VCC

Id: 1/10 Title: Schematic Overview

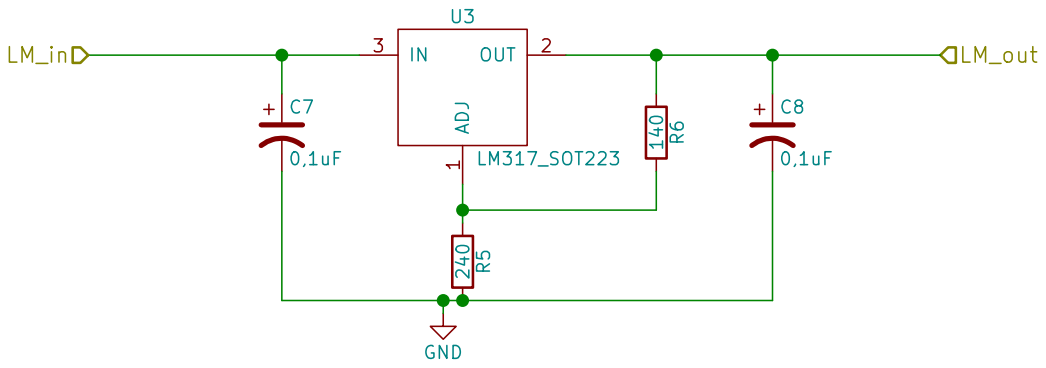
[picture p159: page 2]

Id: 2/10 Title: Supply Schematic

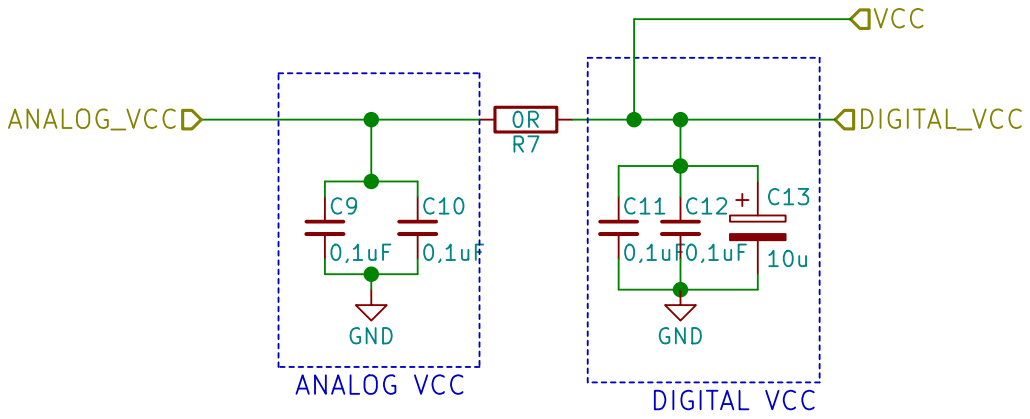
[picture p160: page 3]

Universidade de Brasília - Campus Gama C9
0,1uF GND

Sheet: /CAP_AC_DC/
File: CAP_AC_DC.sch
Id: 3/10 Title: Capacitor Bank Schematic

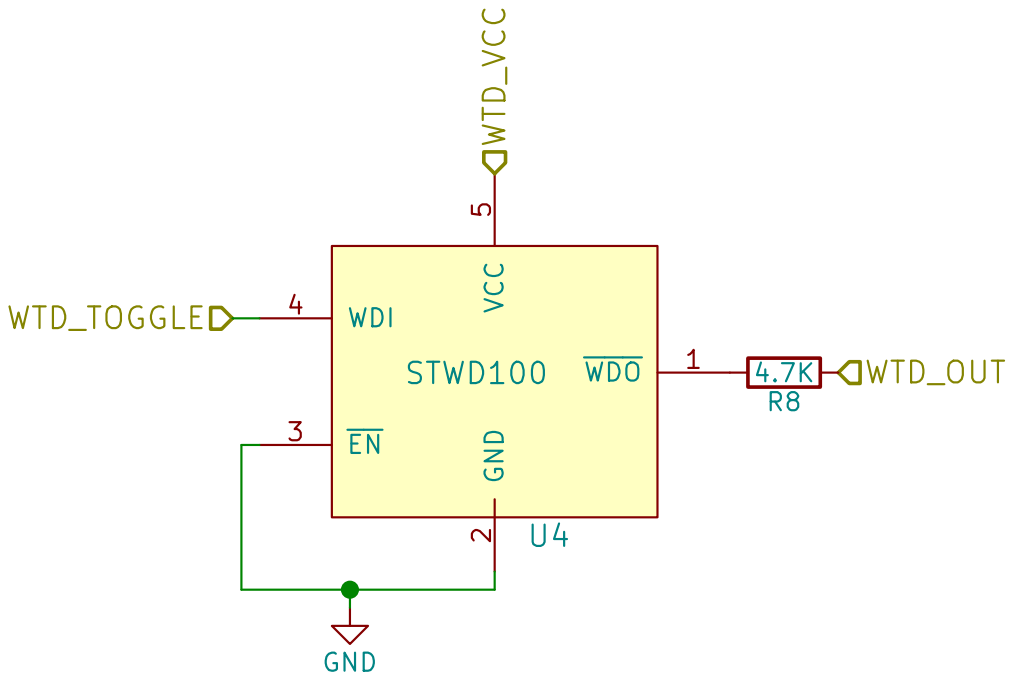
[picture p161: page 4]

Sheet: /WTD_Externo/
File: wtd_externo.sch
Id: 4/10 Title: Watchdog Schematic

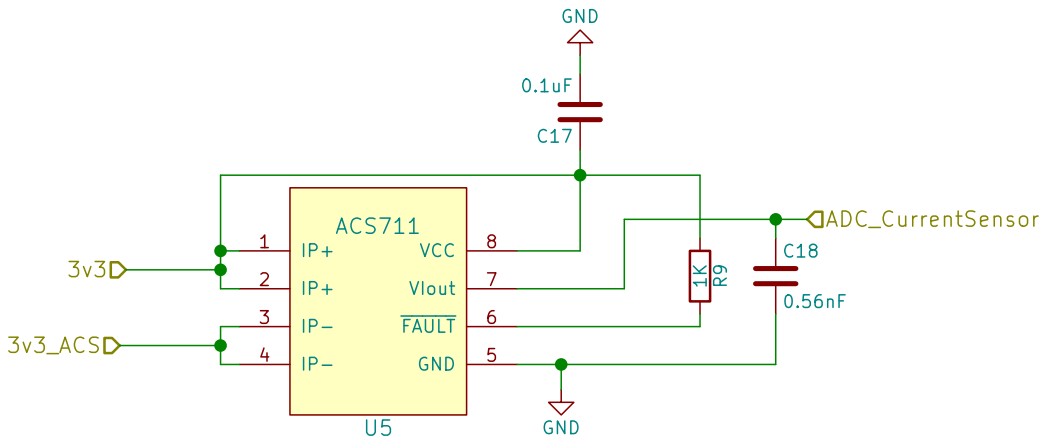
[picture p162: page 5]

File: CurrentSensor.sch Sheet: /CurrentSensor/ Universidade de Brasília - Campus Gama GND

Id: 5/10 Title: Current Sensor Schematic

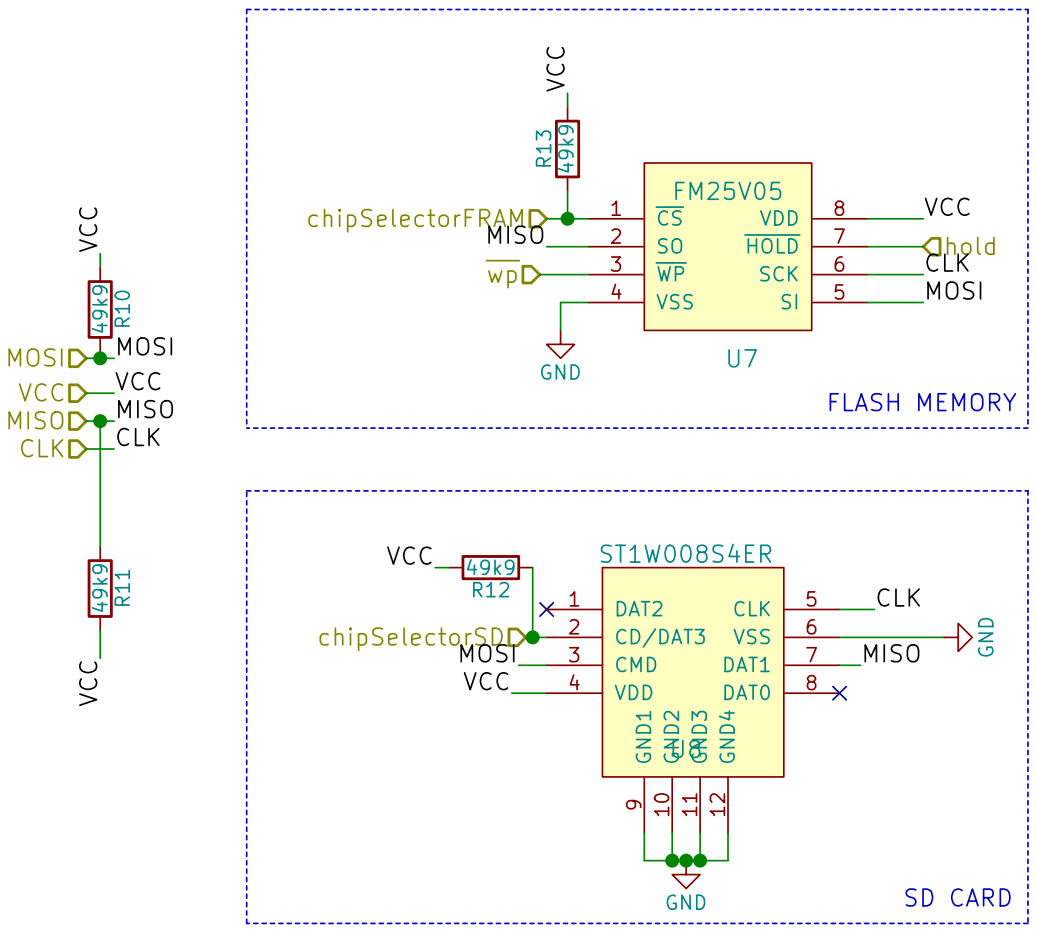
[picture p163: page 6]

Universidade de Brasília - Campus Gama
Sheet: /Memory/
File: Memory.sch
Id: 6/10 Title: Memory Module Schematic

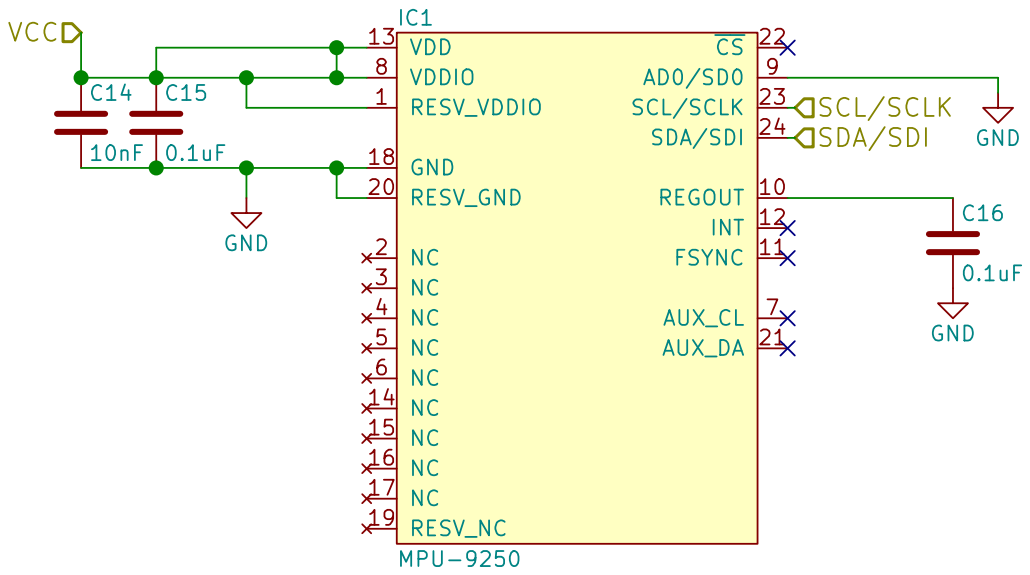
[picture p164: page 7]

Universidade de Brasília - Campus Gama
Sheet: /SENSOR_INERCIAL /
File: sensor_inercial.sch
Id: 7/10 Title: Inercial Sensor Schematic

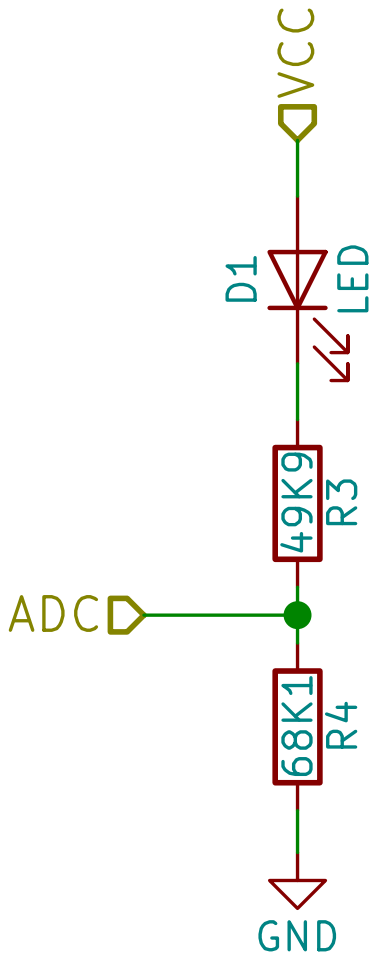
[picture p165: page 8]

Sheet: /VoltageSensor/
File: voltageSensor.sch
Id: 8/10 Title: Voltage Sensor Schematic

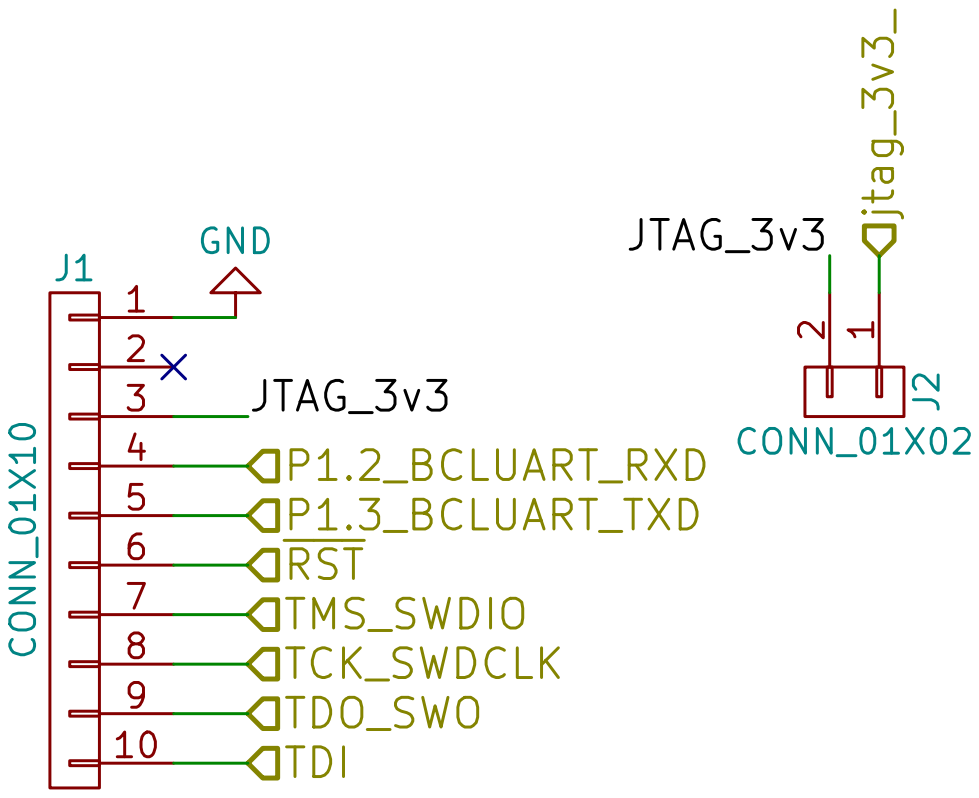
[picture p166: page 9]

Sheet: /jtag/
File: jtag.sch
Id: 9/10 Title: JTAG Connector Schematic

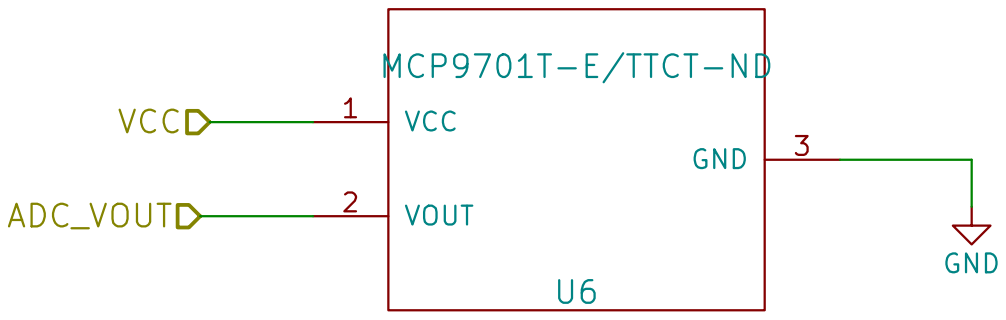
[picture p167: page 10]

Universidade de Brasília - Campus Gama
Sheet: /TemperatureSensor/
File: TemperatureSensor.sch
Id: 10/10 Title: Temperature Sensor Schematic
