guilhermelionzo/tcc_files/latex/figuras/flowChart_houseKeeping.pdf

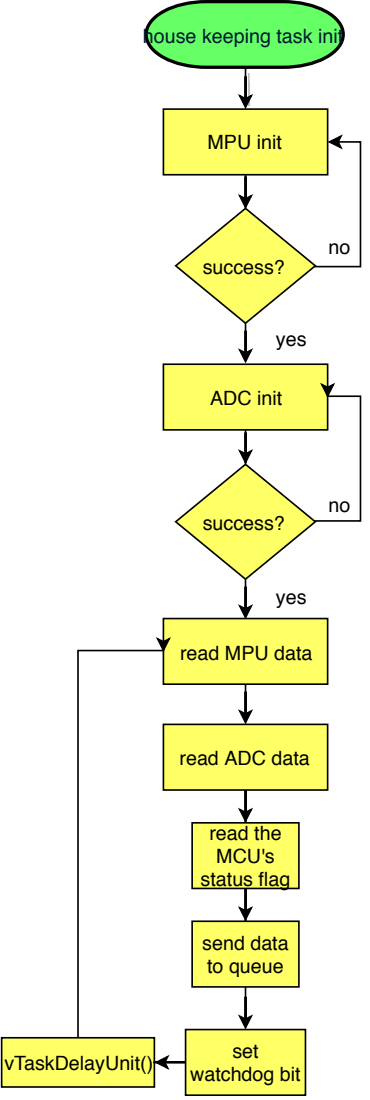
[picture p168: page 1]
vTaskDelayUnit(); MPU init; success?; yes; read the MCU's status flag; send data to queue; set watchdog bit; ADC init

house keeping task init

read MPU data

read ADC data
