guilhermelionzo/tcc_files/latex/figuras/flowChart_obc.pdf

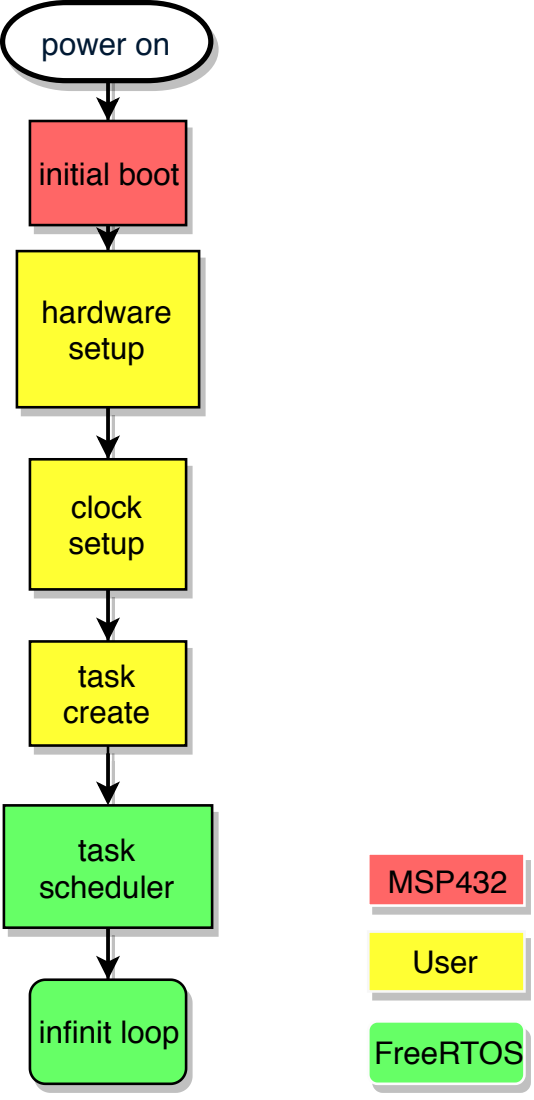
[picture p169: page 1]
power on; initial boot; hardware setup; clock setup; task create; task scheduler; infinit loop; FreeRTOS; User; MSP432
