guilhermelionzo/tcc_files/latex/figuras/flowChart_hardware.pdf

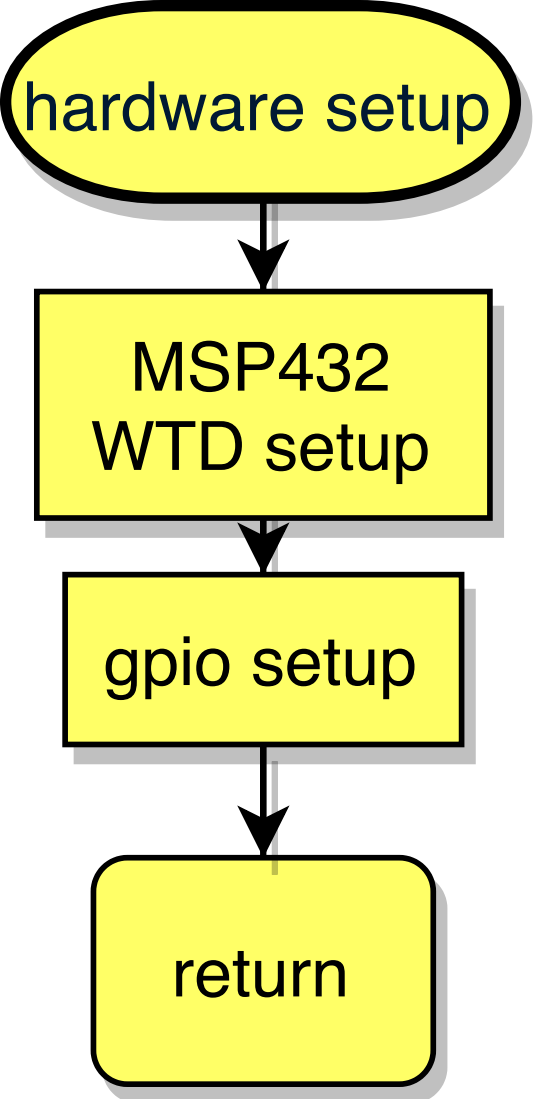
[picture p170: page 1]
hardware setup; MSP432 WTD setup; gpio setup; return
