guilhermelionzo/tcc_files/latex/figuras/flowChart_dataStorage.pdf

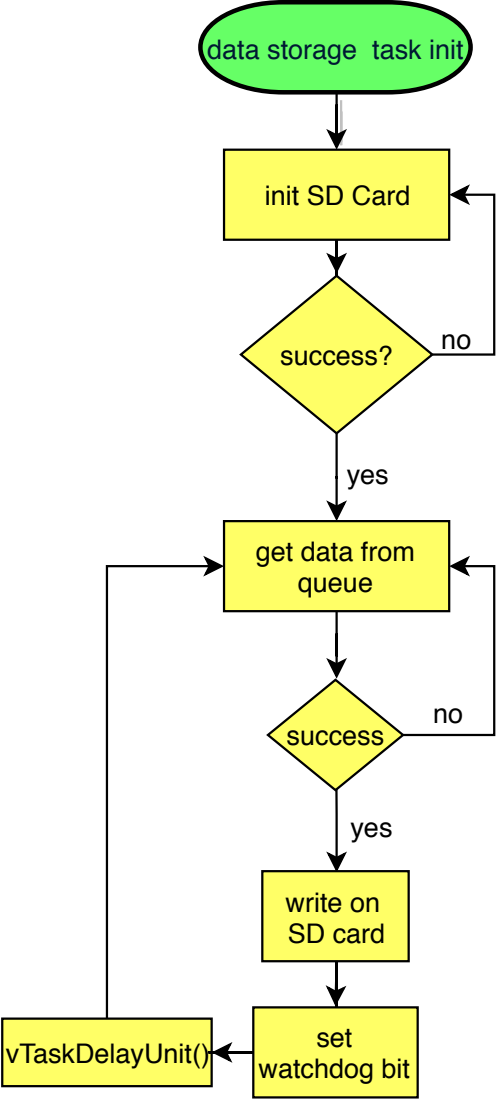
[picture p171: page 1]
vTaskDelayUnit(); success; yes; success?; write on SD card; set watchdog bit

data storage task init

init SD Card

get data from
queue
