guilhermelionzo/tcc_files/pcb/layout/pcb_v1-B_Cu.pdf

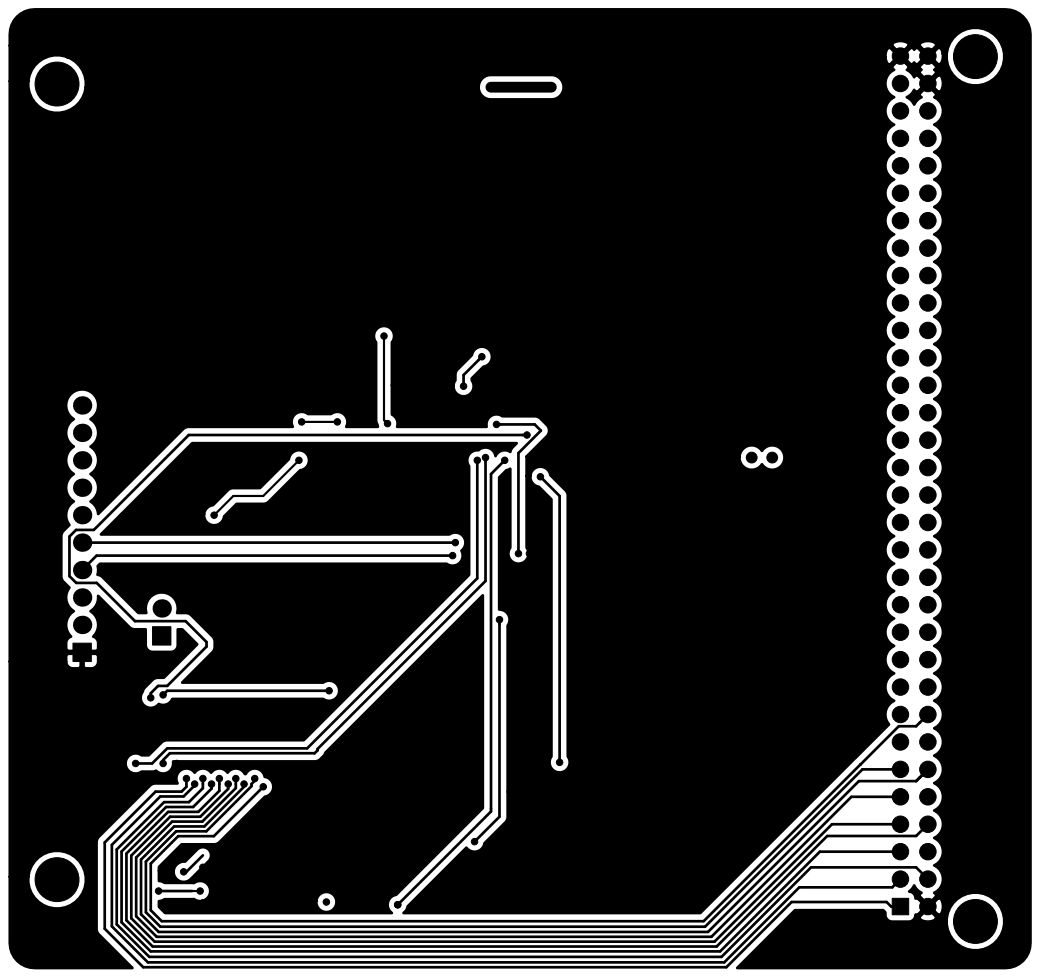
[picture p172: page 1]
