guilhermelionzo/tcc_files/pcb/layout/pcb_v1-Edge_Cuts.pdf

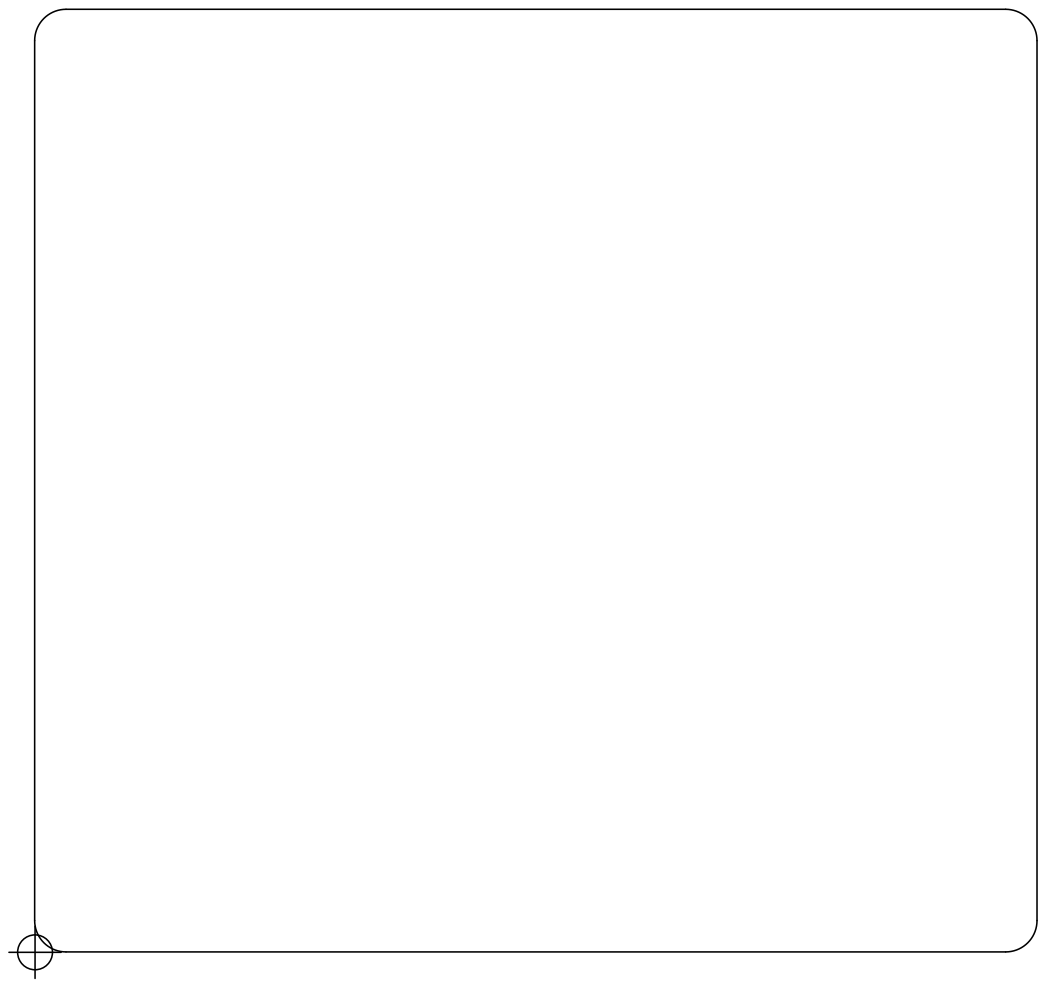
[picture p173: page 1]
