guilhermelionzo/tcc_files/pcb/layout/pcb_v1-F_Cu.pdf

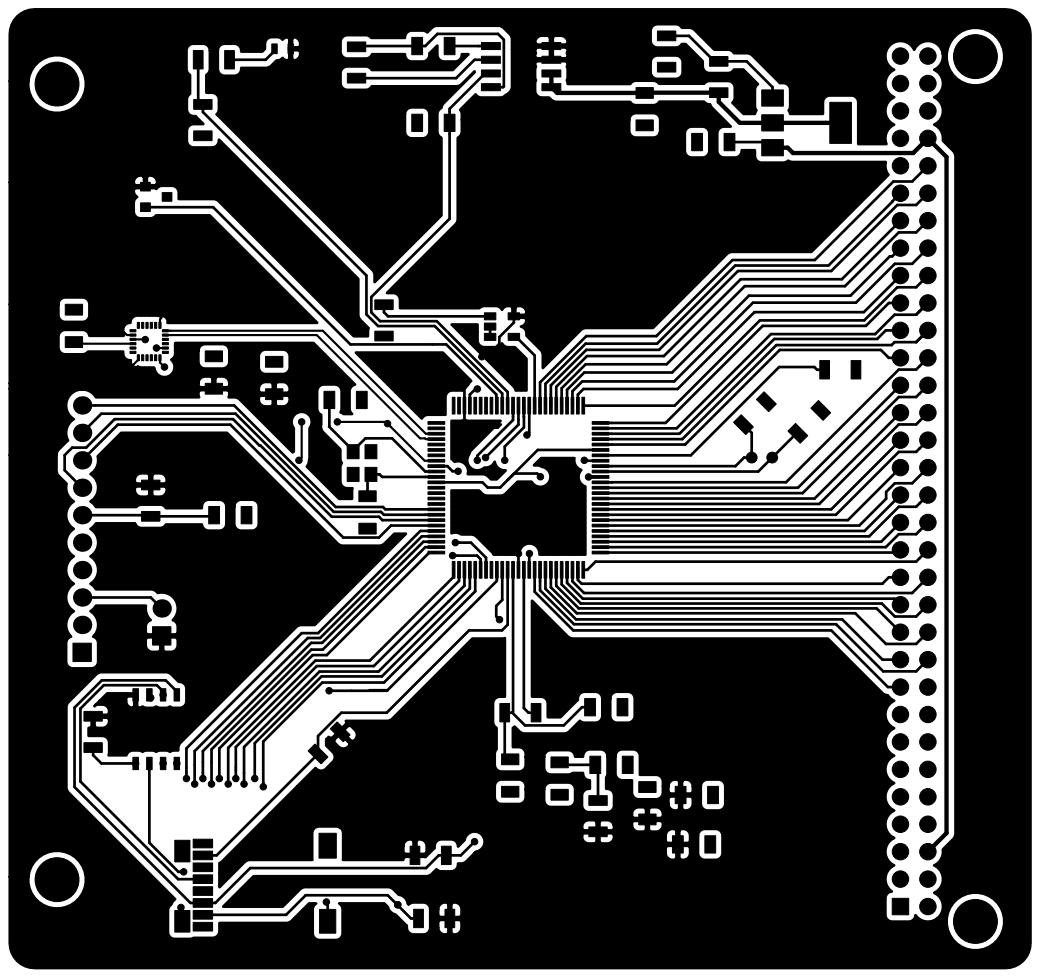
[picture p174: page 1]
