guilhermelionzo/tcc_files/pcb/layout/pcb_v1-F_Mask.pdf

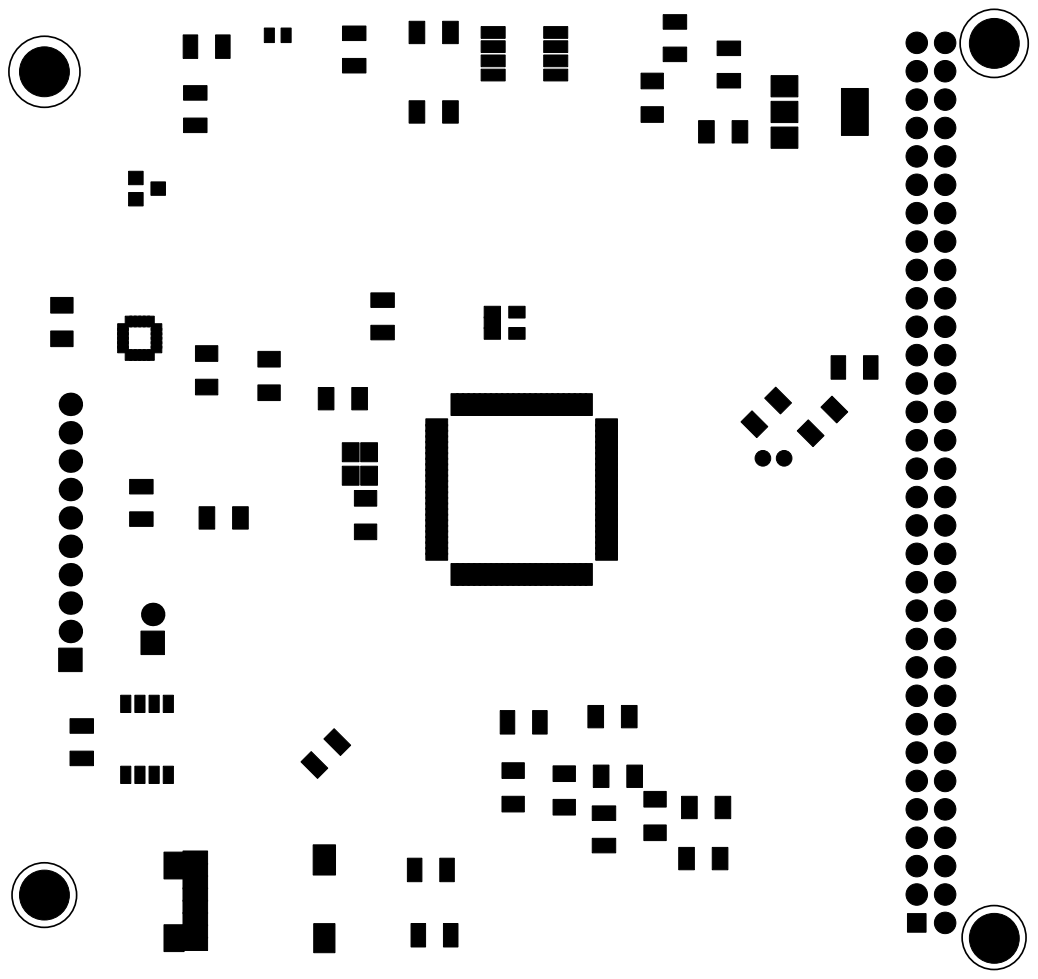
[picture p175: page 1]
