guilhermelionzo/tcc_files/pcb/layout/pcb_v1-F_SilkS.pdf

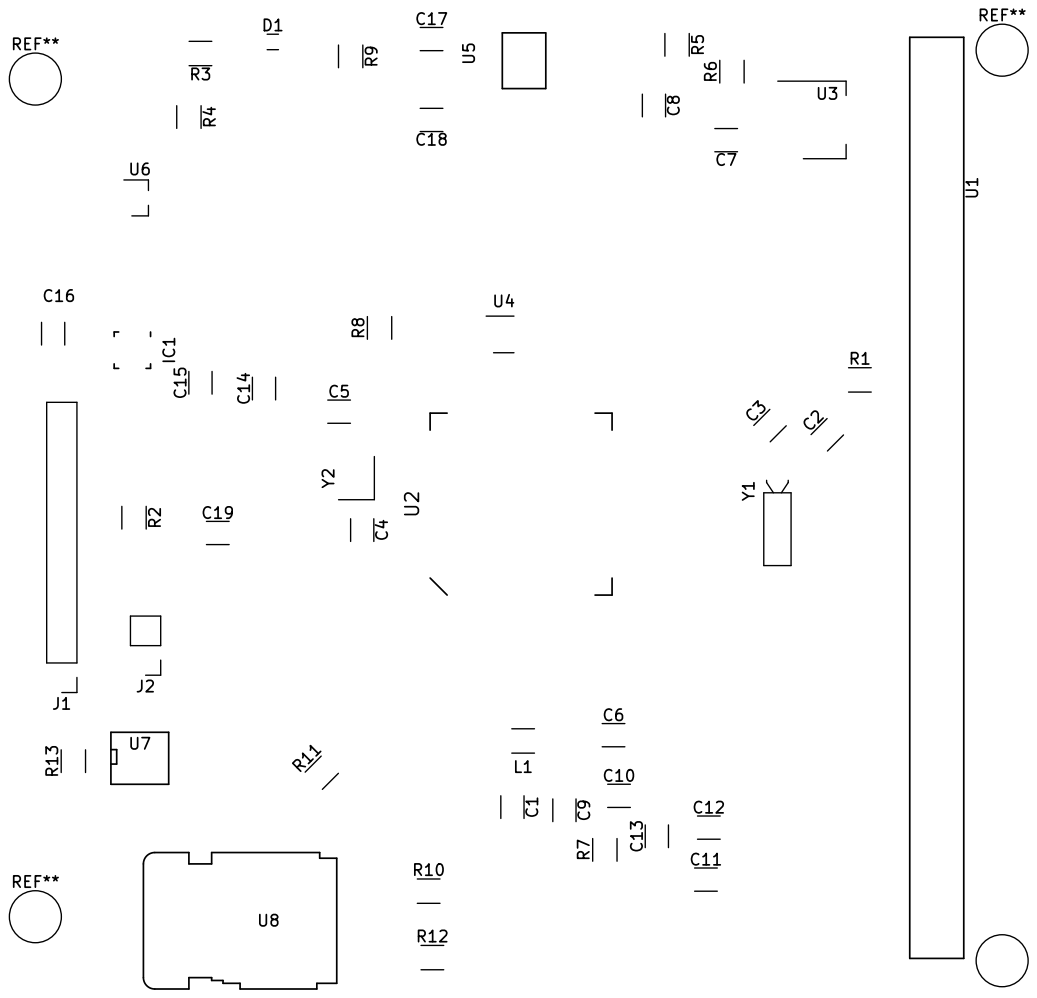
[picture p176: page 1]
