guilhermelionzo/tcc_files/pcb/pcb_v1.kicad_pcb

## KiCad design pcb/pcb_v1.kicad_pcb (2019-06-20)

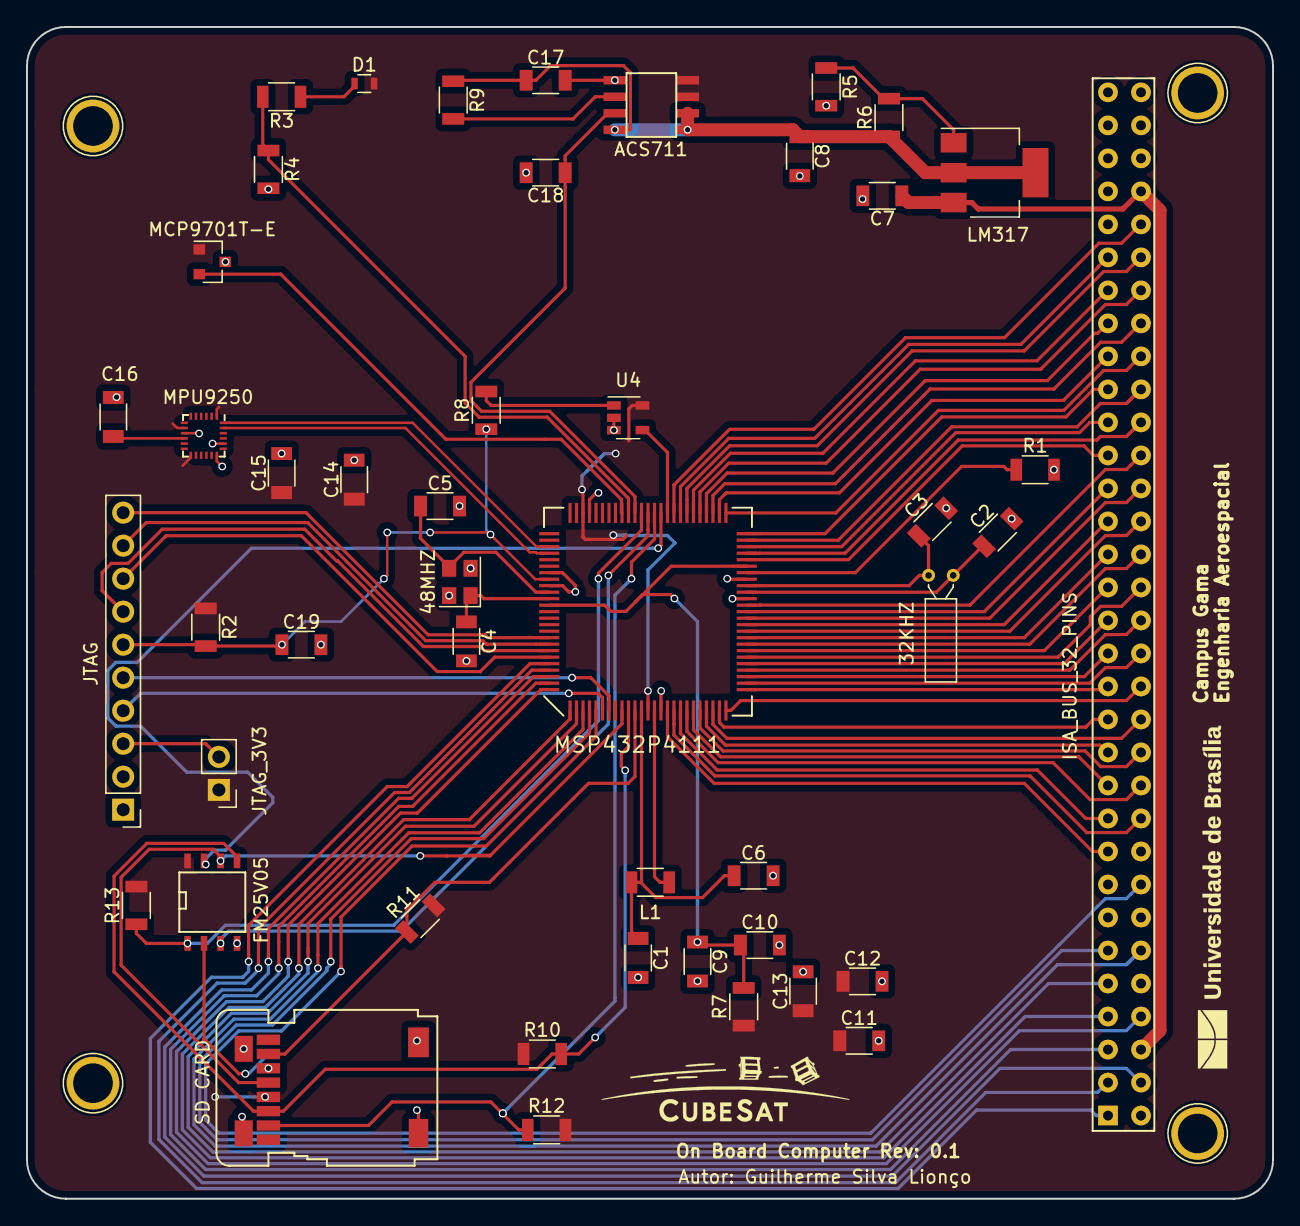
[picture p177: board pcb_v1.kicad_pcb from above]

Board: 2 copper layers, 95.9 x 90.2 mm, 47 parts (0 on the bottom side), 86 nets.

Parts:
32KHZ: 32kHz; Crystal_DS26_d2.0mm_l6.0mm_Horizontal
48MHZ: 48MHz; Oscillator_SMD_Abracon_ASE-4pin_3.2x2.5mm
ACS711: ACS711; ACS711_8-pin SOICN
C1, C7, C8, C9, C10, C11, C12: 0,1uF; C_1206
C2, C3, C4, C5: 22p; C_1206
C6: 4u7; C_1206
C13: 10u; C_1206
C14: 10nF; C_1206
C15, C16, C17: 0.1uF; C_1206
C18: 0.56nF; C_1206
C19: 1nF; C_1206
D1: LED; R_0603
FM25V05: FM25V05; SOIC-8-N
ISA_BUS_32_PINS: ISA_BUS_connector; ISA_CONNECTOR
JTAG: CONN_01X10; Pin_Header_Straight_1x10_Pitch2.54mm
JTAG_3V3: CONN_01X02; Pin_Header_Straight_1x02_Pitch2.54mm
L1: 4.7uH; L_1206
LM317: LM317_SOT223; SOT-223-3_TabPin2
MCP9701T-E: MCP9701T-E/TTCT-ND; SOT-23
MPU9250: MPU-9250; QFN-24_3x3mm_Pitch0.4mm
MSP432P4111: MSP432P4111
R1: 91kOhm; R_1206
R2: 47K; R_1206
R3: 49K9; R_1206
R4: 68K1; R_1206
R5: 240; R_1206
R6: 140; R_1206
R7: 0R; R_1206
R8: 4.7K; R_1206
R9: 1K; R_1206
R10, R11, R12, R13: 49k9; R_1206
SD CARD: ST1W008S4ER; ST1W008S4ER1500
U4: STWD100; SOT-23-5

Connections:
+5V: C7.1, ISA_BUS_32_PINS.35, ISA_BUS_32_PINS.61, LM317.3
/3v3: ACS711.1, ACS711.2, ACS711.8, C8.1, C17.1, LM317.2, R6.1, R9.1
/3v3_ACS: ACS711.3, ACS711.4, C11.1, C12.1, C13.1, C14.1, C15.1, D1.2, FM25V05.8, JTAG_3V3.1, MCP9701T-E.1, MPU9250.1, MPU9250.8, MPU9250.13, MSP432P4111.13, MSP432P4111.73, R2.1, R7.1, R10.1, R11.2, R12.2, R13.2, SD CARD.4, U4.5
/HFXIN: 48MHZ.1, C4.1, MSP432P4111.86
/HFXOUT: 48MHZ.3, C5.1, MSP432P4111.85
/LFXIN: 32KHZ.2, C2.1, MSP432P4111.41
/LFXOUT: 32KHZ.1, C3.1, MSP432P4111.42
/VCORE: C1.1, C6.1, L1.2, MSP432P4111.12
/VSW: L1.1, MSP432P4111.14
/adcVoltage3V3: MSP432P4111.66, R3.2, R4.1
/analog_vcc: C9.1, C10.1, MSP432P4111.45, MSP432P4111.87, R7.2
/chipSelectorFRAM: FM25V05.1, MSP432P4111.64, R13.1
/chipSelectorSD: MSP432P4111.62, R12.1, SD CARD.2
/clkIMU: MPU9250.23, MSP432P4111.79
/clkMemory: FM25V05.6, MSP432P4111.9, SD CARD.5
/currentSensor: ACS711.7, C18.1, MSP432P4111.65
/holdFRAM: FM25V05.7, MSP432P4111.61
/jtag/JTAG_3v3: JTAG.3, JTAG_3V3.2
/jtag_bclUartRxd: JTAG.4, MSP432P4111.6
/jtag_bclUartTxd: JTAG.5, MSP432P4111.7
/jtag_tckSwdClk: JTAG.8, MSP432P4111.95
/jtag_tdi: JTAG.10, MSP432P4111.92
/jtag_tdoSwo: JTAG.9, MSP432P4111.93
/jtag_tmsSwdio: JTAG.7, MSP432P4111.94
/misoMemory: FM25V05.2, MSP432P4111.11, R11.1, SD CARD.7
/mosiMemory: FM25V05.5, MSP432P4111.10, R10.2, SD CARD.3
/p1: ISA_BUS_32_PINS.4, MSP432P4111.1
/p2: ISA_BUS_32_PINS.5, MSP432P4111.2
/p3: ISA_BUS_32_PINS.38, MSP432P4111.3
/p4: ISA_BUS_32_PINS.6, MSP432P4111.4
/p5: ISA_BUS_32_PINS.40, MSP432P4111.5
/p16: ISA_BUS_32_PINS.9, MSP432P4111.16
/p17: ISA_BUS_32_PINS.42, MSP432P4111.17
/p18: ISA_BUS_32_PINS.10, MSP432P4111.18
/p19: ISA_BUS_32_PINS.43, MSP432P4111.19
/p20: ISA_BUS_32_PINS.11, MSP432P4111.20
/p21: ISA_BUS_32_PINS.44, MSP432P4111.21
/p22: ISA_BUS_32_PINS.12, MSP432P4111.22
/p23: ISA_BUS_32_PINS.45, MSP432P4111.23
/p24: ISA_BUS_32_PINS.13, MSP432P4111.24
/p25: ISA_BUS_32_PINS.46, MSP432P4111.25
/p26: ISA_BUS_32_PINS.14, MSP432P4111.26
/p27: ISA_BUS_32_PINS.47, MSP432P4111.27
/p28: ISA_BUS_32_PINS.15, MSP432P4111.28
/p29: ISA_BUS_32_PINS.48, MSP432P4111.29
/p30: ISA_BUS_32_PINS.16, MSP432P4111.30
/p31: ISA_BUS_32_PINS.49, MSP432P4111.31
/p32: ISA_BUS_32_PINS.17, MSP432P4111.32
/p33: ISA_BUS_32_PINS.50, MSP432P4111.33
/p34: ISA_BUS_32_PINS.18, MSP432P4111.34
/p35: ISA_BUS_32_PINS.51, MSP432P4111.35
/p36: ISA_BUS_32_PINS.19, MSP432P4111.36
/p37: ISA_BUS_32_PINS.52, MSP432P4111.37
/p38: ISA_BUS_32_PINS.20, MSP432P4111.38
/p39: ISA_BUS_32_PINS.53, MSP432P4111.39
/p46: ISA_BUS_32_PINS.21, MSP432P4111.46
/p47: ISA_BUS_32_PINS.54, MSP432P4111.47
/p48: ISA_BUS_32_PINS.22, MSP432P4111.48
/p49: ISA_BUS_32_PINS.55, MSP432P4111.49
/p50: ISA_BUS_32_PINS.23, MSP432P4111.50
/p51: ISA_BUS_32_PINS.56, MSP432P4111.51
/p52: ISA_BUS_32_PINS.24, MSP432P4111.52
/p53: ISA_BUS_32_PINS.57, MSP432P4111.53
/p54: ISA_BUS_32_PINS.25, MSP432P4111.54
/p55: ISA_BUS_32_PINS.58, MSP432P4111.55
/p56: ISA_BUS_32_PINS.26, MSP432P4111.56
/p57: ISA_BUS_32_PINS.59, MSP432P4111.57
/p58: ISA_BUS_32_PINS.27, MSP432P4111.58
/p59: ISA_BUS_32_PINS.60, MSP432P4111.59
/p96: ISA_BUS_32_PINS.1, MSP432P4111.96
/p97: ISA_BUS_32_PINS.2, MSP432P4111.97
/p98: ISA_BUS_32_PINS.34, MSP432P4111.98
/p99: ISA_BUS_32_PINS.3, MSP432P4111.99
/p100: ISA_BUS_32_PINS.36, MSP432P4111.100
/resetMCU: C19.1, JTAG.6, MSP432P4111.83, R2.2, R8.1
/sdaIMU: MPU9250.24, MSP432P4111.78
/temperatureSensor: MCP9701T-E.2, MSP432P4111.67
/wpFRAM: FM25V05.3, MSP432P4111.63
/wtdToggle: MSP432P4111.60, U4.4
GND: 48MHZ.2, 48MHZ.4, ACS711.5, C1.2, C2.2, C3.2, C4.2, C5.2, C6.2, C7.2, C8.2, C9.2, C10.2, C11.2, C12.2, C13.2, C14.2, C15.2, C16.2, C17.2, C18.2, C19.2, FM25V05.4, ISA_BUS_32_PINS.32, ISA_BUS_32_PINS.33, ISA_BUS_32_PINS.63, ISA_BUS_32_PINS.64, JTAG.1, MCP9701T-E.3, MPU9250.9, MPU9250.18, MPU9250.20, MSP432P4111.15, MSP432P4111.40, MSP432P4111.43, MSP432P4111.72, MSP432P4111.82, MSP432P4111.84, R1.2, R4.2, R5.2, SD CARD.6, SD CARD.9, SD CARD.10, SD CARD.12, U4.2, U4.3
unnamed: C16.1, MPU9250.10
unnamed: D1.1, R3.1
unnamed: MSP432P4111.44, R1.1
unnamed: LM317.1, R5.1, R6.2
unnamed: R8.2, U4.1
unnamed: ACS711.6, R9.2
