guilhermelionzo/tcc_files/code/SDCARD_PetiteFS_2553/SDCARD_PetiteFS_2553/config.h

/**
 * config.h - configure baud rates, xmit/recv pins and ring buffer size
 *
 * The values below are known to work on a launchpad
 * with an msp430g2231 in the socket and a 32.768k
 * crystal soldered onto the board.  The crystal is
 * needed to calibrate the DCO clock to the desired
 * CPU frequency.  The DCO needs to be fairly accurate
 * to achieve the proper bit timing at different
 * baud rates and SMCLK frequencies.
 *
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
 * Author: Rick Kimball
 * email: rick@kimballsoftware.com
 * Version: 1.00 Initial version 04-20-2011
 * Version: 1.01 cleanup 04-21-2011
 *
 */

#ifndef CONFIG_H_
#define CONFIG_H_

/**
 * F_CPU - To obtain the best results select a UART friendly speed.
 *         Measure the SMCLK speed at P1.4 using a multimeter or oscilloscope.
 *         Verify you are getting your desired frequency. Also, you
 *         will have the best luck if you choose BAUD_RATE and F_CPU
 *         combination that allows the ISR routines to complete before
 *         the next data bit arrives. If you are having problems with
 *         a specific baud rate, use a larger F_CPU value until it
 *         works.  You can test how well it works by use a copy paste
 *         command in your terminal emulator.  That seems to stress
 *         the full duplex aspects of the code.
 *
 *   More info about UART friendly F_CPU and BAUD_RATE combos can be found here:
 *
 *         http://mspgcc.sourceforge.net/baudrate.html
 *         http://www.wormfood.net/avrbaudcalc.php and
 */

//-------------------------------------------------------------------------
// CALIBRATE_DCO enable this flag to use the soldered 32.768k watch crystal
//               as a reference clock and calc the F_CPU frequency without
//               saving the results to flash. Only calibrated at POC
//               however temperature will affect the values and clock
//               An improvement to the code would be to occasionally recalc
//-------------------------------------------------------------------------
//#define CALIBRATE_DCO       // on by default

//#define F_CPU 18432000    // UART friendly but out of spec, might work
#define F_CPU 16000000      // fastest clock
//#define F_CPU 14746000    // UART friendly faster clock
//#define F_CPU 12000000    // a popular faster clock
//#define F_CPU 11059200    // UART friendly faster clock
//#define F_CPU  8000000    // a popular medium clock
//#define F_CPU  7372800    // UART and less power friendly rate
//#define F_CPU  3686400    // UART and less power friendly rate
//#define F_CPU  1843200    // UART and power friendly

#if !defined(CALIBRATE_DCO)
#undef F_CPU
#define F_CPU  16000000     // use calibrated 16MHZ clock
#endif

#define BAUD_RATE 9600      // launchpad max speed is 9600. However an FT232RL can go faster
                            // http://www.sparkfun.com/products/718 - FT232RL Breakout Board
#define RX_BUFFER_SIZE 20   // Set the size of the ring buffer data needs to be a power of 2

typedef unsigned char uint8_t;
typedef char int8_t;

#endif
