guilhermelionzo/tcc_files/(commit log)

2019-06-17 1° commit
    [2019-06-13T092040.xlsx, bom_v1.xlsx, oraçamento_v1.xlsx, orçamento_v1.xlsx]
2019-06-17 Clean up Kicad and TCC
    Some changes in the
    [CAP_AC_DC.sch, CurrentSensor.sch, Memory.sch, TemperatureSensor.sch, alimentacao.sch, jtag.sch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]
2019-06-17 Kicad and TCC clean up :muscle:
    [pcb_v1.kicad_pcb]
2019-06-18 add logo in the PCB
    [pcb_v1.kicad_pcb]
2019-06-19 add flowcharts
    [pcb_v1-B_Cu.gbl, pcb_v1-B_Mask.gbs, pcb_v1-B_SilkS.gbo, pcb_v1-Edge_Cuts.gm1, pcb_v1-F_Cu.gtl, pcb_v1-F_Mask.gts, pcb_v1-F_SilkS.gto, pcb_v1-NPTH.drl]
2019-06-20 update CSS
    Operations Mode + UML +State Machine
    [pcb_v1.kicad_pcb]
2019-06-26 update "modos de operação" + traces
2019-12-02 update images
    [pcb_v1.step, pcb_v1.wrl.sldprt]
