guilhermelionzo/tcc_files/(notices)

Notices in the files:
code/SDCARD_PetiteFS_2553/SDCARD_PetiteFS_2553/config.h:
License: Do with this code what you want. However, don't blame
